salehali22/Flight-Controller/Website/Project_Analysis.md

# Comprehensive Analysis: Custom Flight Controller Development for UAV Applications

## Executive Summary

This is a well-structured, ambitious senior capstone project proposing the complete design and development of a custom flight controller from scratch. The proposal demonstrates strong technical awareness, realistic scope definition, and professional documentation standards. The project balances ambitious technical goals with practical constraints, showing mature engineering judgment.

---

## 1. PROJECT STRUCTURE & OBJECTIVES ANALYSIS

### 1.1 Strengths
- **Clear Objective Hierarchy**: Five specific, measurable objectives that cascade logically from hardware design to flight demonstration
- **Realistic Scope Definition**: Excellent distinction between "hardware-first" focus and "validation-level" firmware development
- **Modular Design Philosophy**: Emphasis on compatibility with existing ecosystems (ArduPilot, iNav, Betaflight) shows pragmatic engineering approach
- **Industry Alignment**: References to EASA/FAA standards demonstrate awareness of real-world requirements

### 1.2 Potential Concerns
- **Scope Creep Risk**: Section 1.4 mentions "cascaded PID control loops, sensor fusion, waypoint navigation" - this may be more extensive than "minimal firmware bring-up" (Section 1.3)
- **Ambiguity in Objective 5**: "Demonstrate stable quadcopter flight" could range from basic hover to full autonomous mission
- **Timeline Alignment**: 9-month timeline (Oct 2025 - June 2026) appears tight for a complete custom design-to-flight cycle

---

## 2. TECHNICAL ARCHITECTURE ANALYSIS

### 2.1 Microcontroller Selection: STM32H743

**Analysis:**
- **Appropriate Choice**: 480 MHz Cortex-M7 with FPU is well-suited for real-time flight control
- **Memory Adequacy**: 1MB RAM + 2MB Flash is sufficient but not generous for complex firmware ecosystems
- **Peripheral Richness**: Extensive peripheral set aligns with modular design goals
- **Cost Consideration**: STM32H743 is premium-priced; may stress budget constraints

**Concerns:**
- Compatibility with open-source firmware (ArduPilot/iNav) requires careful pin mapping - must verify these ecosystems support H7 series
- 480 MHz may be overkill if primarily using existing firmware, but appropriate for custom control loops

### 2.2 Sensor Architecture

#### Primary IMU: InvenSense ICM-42688-P
- **Excellent Choice**: High-performance, modern sensor with 4 kHz gyro rate
- **SPI Interface**: Correct choice for deterministic, low-latency operation
- **Redundancy**: Dual IMU setup (ICM-42688-P + BMI270) is industry best-practice

#### Secondary IMU: Bosch BMI270
- **Solid Choice**: Well-established sensor with good documentation
- **Compatibility**: Different manufacturer reduces common-mode failure risk

#### Barometric Sensor: BMP388
- **Standard Choice**: Widely used in UAV applications
- **Resolution**: ±0.08m is adequate but not exceptional (BMP390 offers better)
- **I²C Interface**: Appropriate for barometric sensing (not time-critical)

#### Missing/Not Explicitly Mentioned:
- **Temperature Sensors**: Critical for IMU calibration - need to verify if included in IMU packages
- **External Magnetometer**: Placement in GPS module is smart (avoids interference)

### 2.3 Power Management System

**Strengths:**
- **Staged Regulation**: Buck converters → LDOs is correct approach for noise isolation
- **Protection Circuitry**: Reverse-polarity and transient suppression mentioned
- **USB-C Integration**: Modern, convenient for development
- **Separation of Concerns**: Power distribution board for motors/servos is excellent design

**Potential Issues:**
- **Current Monitoring**: I²C sensor mentioned but not specified - verify bandwidth for real-time monitoring
- **Efficiency**: Multiple regulation stages may reduce overall efficiency (calculate power budget)
- **Component Count**: More components = higher cost and board complexity

### 2.4 Interface Architecture

#### CAN Bus (FDCAN)
- **Forward-Thinking**: Enables modern distributed UAV architectures
- **Implementation**: Requires proper termination and topology planning
- **Cost Impact**: CAN transceiver adds component cost

#### PWM Outputs (12 channels)
- **Sufficient Capacity**: Covers multirotor (4), individual ESCs (4), servos (4)
- **Timer Resource Allocation**: Must verify STM32H743 has sufficient timer peripherals for 12 independent PWM outputs
- **Voltage Level**: 3.3V logic may require level shifting for 5V ESC compatibility

#### Video Systems
- **Comprehensive Coverage**: Both analog (OSD) and digital (DJI Air Unit) support
- **DJI Integration**: Multiple Air Unit variants supported - excellent for market compatibility
- **Power Requirements**: DJI Air Units need significant power (9V/12V) - verify regulator capacity

---

## 3. PCB DESIGN & LAYOUT ANALYSIS

### 3.1 Six-Layer Stack-Up

**Layer Structure Analysis:**
```
Top Layer: Signal routing (GND reference)
Layer 2: VCC power plane
Layer 3: Solid GND
Layer 4: Segregated power (noisy domains)
Layer 5: Solid GND
Bottom Layer: Signal routing (GND reference)
```

**Strengths:**
- **Proper GND-PWR-GND Sandwich**: Essential for EMI control
- **Dedicated Noisy Power Layer**: Shows understanding of mixed-signal design
- **Signal Layers Adjacent to GND**: Minimizes loop area

**Concerns:**
- **Cost**: 6-layer PCBs are significantly more expensive than 4-layer (may consume 30-40% of PCB budget)
- **Manufacturing Complexity**: Not all cheap PCB fabs can reliably produce 6-layer boards
- **Via Stacks**: Need careful via design to avoid impedance discontinuities

### 3.2 EMC Design Philosophy

**Excellent Approach:**
- **Design-for-Compliance**: Proactive rather than reactive
- **Standards Reference**: IEC 61000 series, CISPR 32, IPC-2221 show proper research
- **Split Ground Avoidance**: Modern best practice (many designs incorrectly split grounds)

**Potential Gaps:**
- **Shielding**: No mention of board-level shielding or enclosure considerations
- **Ferrite Beads**: May be needed on external connectors for common-mode noise
- **Crystal Placement**: HSE oscillator placement relative to sensitive analog circuits

### 3.3 Signal Integrity Considerations

**Not Explicitly Addressed:**
- **Differential Pair Routing**: SPI at 8-10 MHz may need controlled impedance (depends on trace length)
- **Clock Distribution**: HSE oscillator routing and termination
- **Power Plane Decoupling**: Strategy for high-frequency decoupling capacitor placement

---

## 4. FIRMWARE STRATEGY ANALYSIS

### 4.1 Dual-Purpose Approach

**Strengths:**
- Compatibility with ArduPilot/iNav enables rapid validation
- Custom firmware path allows deep learning and experimentation
- Realistic acknowledgment that full firmware development is outside scope

### 4.2 Firmware Scope Clarification

**Inconsistency Identified:**
- Section 1.3: "firmware development is limited to essential board validation"
- Section 1.4: "cascaded PID control loops, sensor fusion, waypoint navigation"
- Section 3.2: "sensor fusion, filtering" and "state estimation, control logic"

**Recommendation**: Clarify whether custom flight control is required or if ArduPilot port is sufficient for validation

### 4.3 Sensor Fusion & State Estimation

**Complexity Assessment:**
- **IMU Fusion**: Basic complementary filter is manageable; full EKF/Madgwick requires significant effort
- **Altitude Fusion**: Combining barometer with IMU accelerometer (Z-axis)
- **GPS Integration**: Position/velocity fusion for autonomous modes

**Time Estimate**: Sensor fusion alone could consume 2-3 months if done from scratch

---

## 5. PROJECT TIMELINE & TASK ALLOCATION

### 5.1 Timeline Analysis (Oct 2025 - June 2026)

**Month-by-Month Breakdown:**
- **Oct 2025**: Planning & Schematic (1 month)
- **Nov 2025**: PCB Layout (1 month) - **AGGRESSIVE**
- **Dec 2025**: Manufacturing (1 month) - Includes fab lead time
- **Dec-Jan 2026**: Hardware bring-up (2 months)
- **Jan-Mar 2026**: Firmware development (3 months)
- **Feb-Apr 2026**: Control algorithms (3 months, overlaps)
- **Apr-May 2026**: Integration & flight testing (2 months)
- **Jun 2026**: Documentation & delivery (1 month)

**Critical Path Risks:**
1. **PCB Layout Duration**: 6-layer board with EMC considerations typically requires 4-6 weeks minimum
2. **Manufacturing Lead Time**: December may have holiday delays (2-4 weeks typical fab time)
3. **Hardware Debugging**: 2 months may be insufficient if major issues found
4. **Flight Testing**: Weather dependencies in Apr-May may cause delays

### 5.2 Task Allocation Analysis

#### Akaki Gvelesiani: Hardware + Low-Level Firmware
**Workload Assessment:**
- **Schematic Design**: 2-3 weeks
- **PCB Layout (6-layer)**: 4-6 weeks (CRITICAL PATH)
- **Low-Level Firmware**: HAL setup, drivers, sensor fusion - **4-6 weeks minimum**
- **Total**: 10-15 weeks of intensive work

**Risk**: Very heavy workload, particularly PCB layout is time-intensive and error-prone

#### Saleh Alhomeidy: Hardware Review + High-Level Firmware
**Workload Assessment:**
- **Hardware Review**: Ongoing support role
- **High-Level Firmware**: Control algorithms, PID tuning - **6-8 weeks**
- **Risk**: Control algorithm tuning is iterative and unpredictable

#### Levani Kazaishvili: Procurement + Mechanical
**Workload Assessment:**
- **Component Sourcing**: Critical early in project (Oct-Nov)
- **Budget Management**: Ongoing
- **Mechanical Integration**: Late-stage focus (Mar-May)

**Note**: This role appears lighter but procurement delays can derail entire timeline

---

## 6. BUDGET ANALYSIS (800 GEL ≈ $280 USD)

### 6.1 Cost Breakdown Estimate

**PCB Manufacturing:**
- 6-layer PCB (50mm x 50mm, ~10 pieces): $150-200
- Assembly (if outsourced): $200-300
- **Total PCB Cost**: Likely $200-300 (if manual assembly)

**Components:**
- STM32H743 (QFP-100): $15-25
- IMU ICM-42688-P: $8-12
- IMU BMI270: $5-8
- BMP388: $3-5
- AT7456E OSD: $5-8
- Power management ICs: $20-30
- Passive components, connectors: $30-50
- **Total Components**: ~$100-150

**Test Platform:**
- 7-inch quadcopter frame: $30-50
- Motors, ESCs (4x): $80-120
- Battery, props: $30-50
- **Total Test Platform**: ~$150-200

**Total Estimate**: $450-650 - **EXCEEDS BUDGET**

### 6.2 Budget Concerns

- **Single PCB Iteration**: No room for respins if issues found
- **Component Costs**: High-end MCU and dual IMUs are expensive
- **Test Platform**: May need to reuse existing equipment or borrow

**Recommendations:**
- Consider 4-layer PCB initially (save ~$100)
- Use lower-cost MCU alternative for validation (STM32F7 series)
- Plan for manual assembly to save costs
- Source components from budget distributors (LCSC, AliExpress)

---

## 7. TECHNICAL RISK ASSESSMENT

### 7.1 High-Risk Areas

#### 7.1.1 PCB First-Pass Success
**Risk Level**: HIGH
**Mitigation**: Extensive design review, simulation before fab
**Impact**: 4-6 week delay + additional cost

#### 7.1.2 Firmware Development Time
**Risk Level**: MEDIUM-HIGH
**Mitigation**: Leverage existing firmware (ArduPilot) rather than custom
**Impact**: May not meet "custom firmware" learning objectives

#### 7.1.3 Component Availability
**Risk Level**: MEDIUM
**Mitigation**: Early procurement, identify alternates
**Impact**: 2-4 week delays possible

#### 7.1.4 EMC/EMI Issues
**Risk Level**: MEDIUM
**Mitigation**: Design-for-compliance approach, but no testing validation
**Impact**: May have interference issues in flight that are difficult to diagnose

### 7.2 Medium-Risk Areas

- **Sensor Calibration**: Time-consuming, requires proper test setup
- **Control Algorithm Tuning**: Iterative process, weather-dependent flight testing
- **Power System Stability**: Under-transient conditions with motor loads

### 7.3 Low-Risk Areas

- **Basic Sensor Communication**: Well-documented interfaces
- **Mechanical Integration**: Standard form factor
- **Documentation**: Writing is less risky than hardware/firmware

---

## 8. STRENGTHS OF THE PROPOSAL

1. **Professional Documentation**: Well-structured, comprehensive, properly referenced
2. **Realistic Limitations**: Honest about constraints (budget, testing, certification)
3. **Standards Awareness**: References to IEC, IPC, EASA/FAA show professional approach
4. **Modular Design**: Enables flexibility and future extensibility
5. **Educational Value**: Covers full engineering workflow from concept to flight
6. **Industry Relevance**: Addresses real need for open, modular flight controllers
7. **Redundancy**: Dual IMU architecture shows safety awareness
8. **EMC Design**: Proper attention to electromagnetic compatibility from start

---

## 9. AREAS FOR IMPROVEMENT / CONCERNS

### 9.1 Technical Concerns

1. **Scope Clarity**: Resolve firmware development scope inconsistency
2. **Budget Realism**: 800 GEL appears insufficient for described scope
3. **Timeline Aggressiveness**: PCB layout and flight testing phases are tight
4. **Missing Specifications**: 
   - Exact form factor dimensions
   - Current ratings for power system
   - Connector specifications (pin counts, types)
   - Operating temperature range
5. **Component Selection Rationale**: Justify STM32H743 vs. lower-cost alternatives

### 9.2 Project Management Concerns

1. **Single PCB Iteration**: No buffer for hardware respins
2. **Weather Dependencies**: Flight testing in Apr-May may face weather delays
3. **Team Workload**: Akaki's role appears overloaded (hardware + significant firmware)
4. **Risk Mitigation**: Limited discussion of backup plans or scope reduction options

### 9.3 Testing Strategy Gaps

1. **Unit Testing**: No mention of individual sensor/interface validation procedures
2. **Integration Testing**: Sequence of integration steps not defined
3. **Failure Modes**: No discussion of how failures will be diagnosed
4. **Test Equipment**: What instrumentation is available/needed?

---

## 10. RECOMMENDATIONS

### 10.1 Immediate Actions

1. **Clarify Firmware Scope**: Define whether ArduPilot port or custom firmware is primary goal
2. **Revise Budget**: Either increase budget or reduce scope (e.g., 4-layer PCB, single IMU)
3. **Expand Timeline Buffer**: Add 2-3 weeks buffer to PCB layout and flight testing phases
4. **Component Procurement**: Immediately verify availability and lead times for critical components

### 10.2 Design Refinements

1. **Form Factor Specification**: Define exact dimensions, mounting hole pattern, connector placement
2. **Power Budget**: Calculate total power consumption and verify regulator capacity
3. **Thermal Analysis**: Consider heat dissipation, especially for power regulators
4. **Alternate Component List**: Prepare backup components for critical parts

### 10.3 Risk Mitigation Strategies

1. **PCB Design Review**: Schedule external review before manufacturing
2. **Prototype Phases**: Consider simplified first revision (fewer features) for validation
3. **Firmware Strategy**: Prioritize ArduPilot compatibility over custom firmware if time constrained
4. **Test Platform**: Secure test platform early to enable parallel work

### 10.4 Documentation Enhancements

1. **Test Procedures**: Define specific test procedures for each subsystem
2. **Design Decisions Log**: Document key design choices and rationale
3. **Risk Register**: Maintain formal risk tracking
4. **Change Management**: Process for handling scope/timeline changes

---

## 11. FEASIBILITY ASSESSMENT

### 11.1 Overall Feasibility: **MEDIUM-HIGH**

**Feasible If:**
- Firmware scope is limited to ArduPilot port + basic validation
- Budget is increased to ~1200-1500 GEL OR scope is reduced
- PCB layout receives adequate time (6 weeks minimum)
- Test platform is available/reused (not purchased)
- Team can dedicate significant weekly hours (15-20 hours/week)

**High-Risk If:**
- Custom firmware development is required
- Single PCB iteration fails
- Component procurement faces delays
- Weather delays flight testing window

### 11.2 Success Criteria Assessment

The proposal defines clear deliverables, but success hinges on:
- **Hardware**: First-pass PCB functionality (HIGH RISK)
- **Firmware**: ArduPilot compatibility OR basic custom control (MEDIUM RISK)
- **Flight**: Stable hover/manual flight (MEDIUM RISK)
- **Timeline**: June 2026 delivery (MEDIUM-HIGH RISK)

---

## 12. COMPETITIVE/INDUSTRY ANALYSIS

### 12.1 Comparison to Existing Solutions

**Commercial Flight Controllers:**
- Pixhawk variants: $100-300, open hardware
- Matek F405/F722: $30-50, popular in DIY community
- DJI N3/A3: $500-1000, proprietary

**Your Design Advantages:**
- Modern MCU (H743 vs. older F4/F7)
- Redundant IMU architecture
- CAN bus support
- DJI Air Unit integration
- Custom learning experience

**Market Position**: Educational/research focus rather than commercial competition

---

## 13. FINAL VERDICT

### 13.1 Technical Merit: **EXCELLENT**
- Sound engineering principles
- Proper standards awareness
- Realistic hardware design
- Good educational value

### 13.2 Project Execution Risk: **MEDIUM-HIGH**
- Timeline is aggressive
- Budget may be insufficient
- Single PCB iteration risky
- Workload distribution concerns

### 13.3 Recommendation: **PROCEED WITH MODIFICATIONS**

**Critical Success Factors:**
1. Clarify and reduce firmware scope to validation-only
2. Increase budget OR reduce hardware complexity
3. Add timeline buffers (especially PCB layout phase)
4. Secure test platform early
5. Prepare for single PCB iteration (extensive design review)

**Modified Timeline Suggestion:**
- Consider extending to 10-11 months OR
- Reduce scope to 4-layer PCB + single IMU for first revision

---

## 14. KEY QUESTIONS FOR CLARIFICATION

1. **Firmware**: Is ArduPilot/iNav port sufficient, or is custom flight control required?
2. **Budget**: Can budget be increased, or should hardware be simplified?
3. **PCB Iterations**: Is there budget/time for a second PCB revision if needed?
4. **Test Platform**: Is 7-inch quadcopter available, or must it be purchased?
5. **Firmware Tools**: What development tools are available (IDEs, debuggers, simulators)?
6. **Component Availability**: Have critical components been verified for availability?
7. **Assembly**: Will PCB be manually assembled or outsourced?
8. **Timeline Flexibility**: Can deadline be extended if needed?

---

## CONCLUSION

This is a well-conceived, technically sound proposal that demonstrates strong engineering fundamentals and professional documentation. The primary risks are **execution-related** (timeline, budget, scope) rather than **technical feasibility**. With appropriate scope adjustments and risk mitigation, this project is highly achievable and will provide excellent educational value.

The proposal would benefit from clearer firmware scope definition, more realistic budget planning, and explicit risk mitigation strategies. However, the technical approach is sound, and the modular, standards-aware design philosophy is appropriate for an academic project with potential for future extension.

**Overall Grade for Proposal: A- (Excellent with minor improvements needed)**

---

*Analysis Date: Based on Project Proposal dated Tbilisi, Georgia*
*Analyzer: Comprehensive Technical Review*
*Project Timeline: October 2025 - June 2026*
