salehali22/Flight-Controller/Hardware/1.png

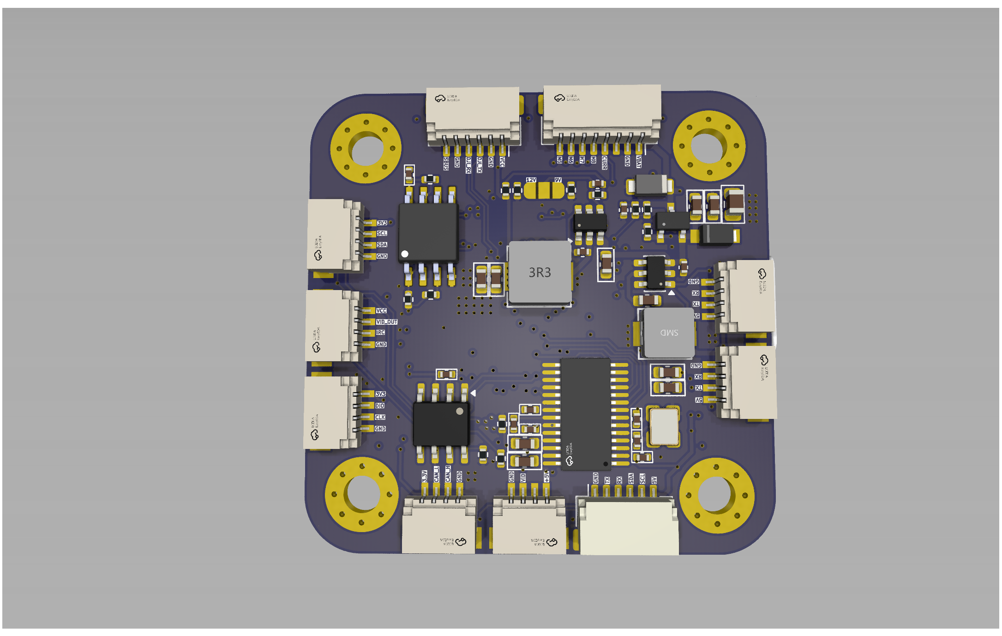
Hardware/1.png
