salehali22/Flight-Controller/Hardware/2.png

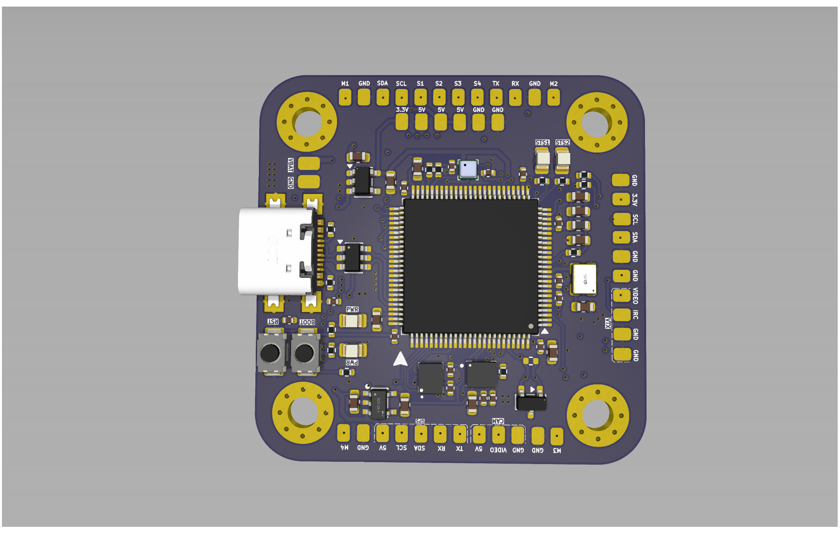
Hardware/2.png
