salehali22/Flight-Controller/Hardware/Flight Controller3.png

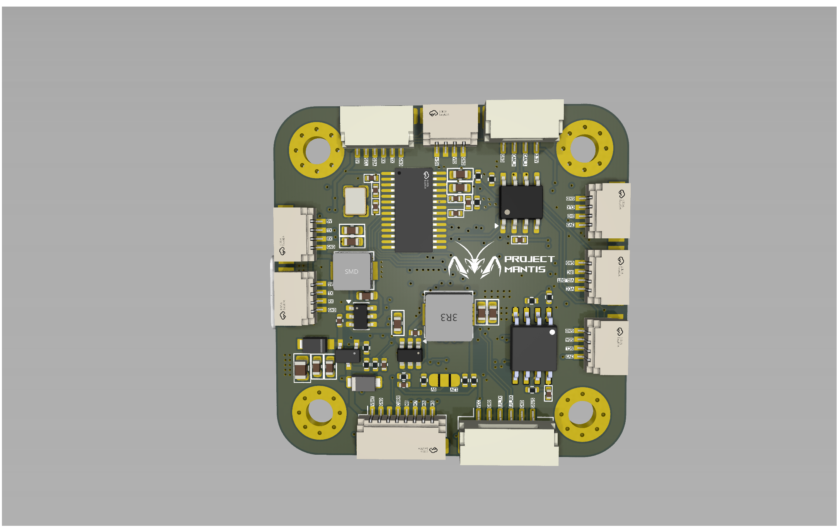
Hardware/Flight Controller3.png
