salehali22/Flight-Controller/Hardware/Flight Controller4.png

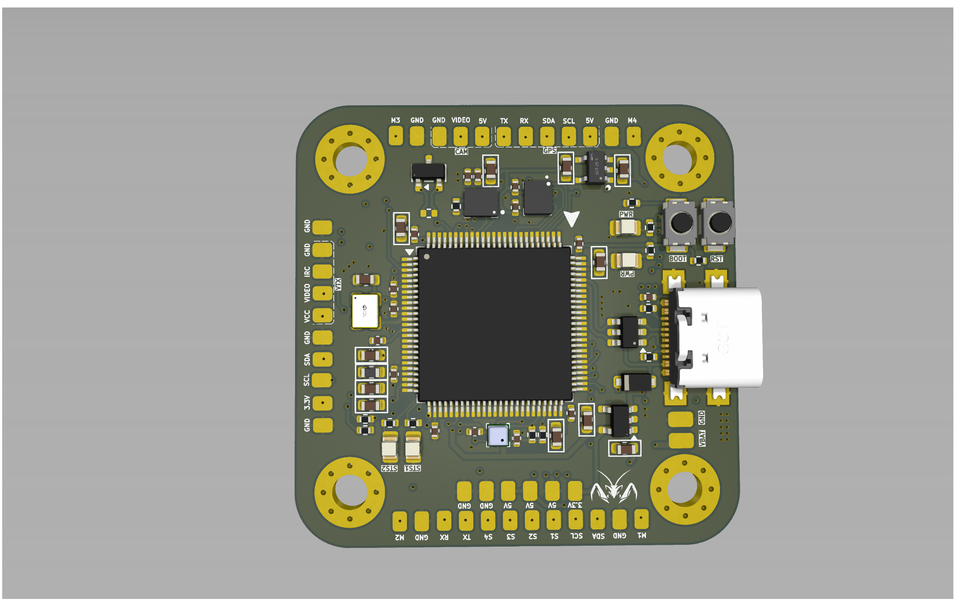
Hardware/Flight Controller4.png
