salehali22/Flight-Controller/Hardware/Flight Controller 1.png

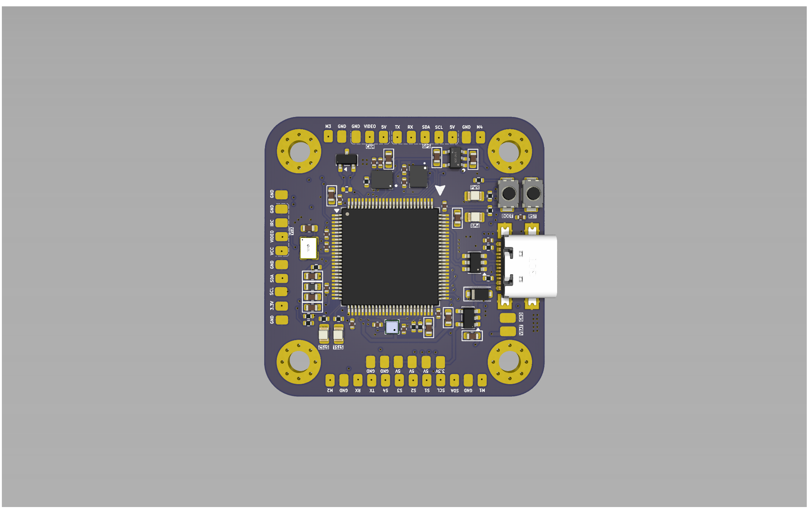
Hardware/Flight Controller 1.png
