salehali22/Flight-Controller/Hardware/Flight Controller 2.png

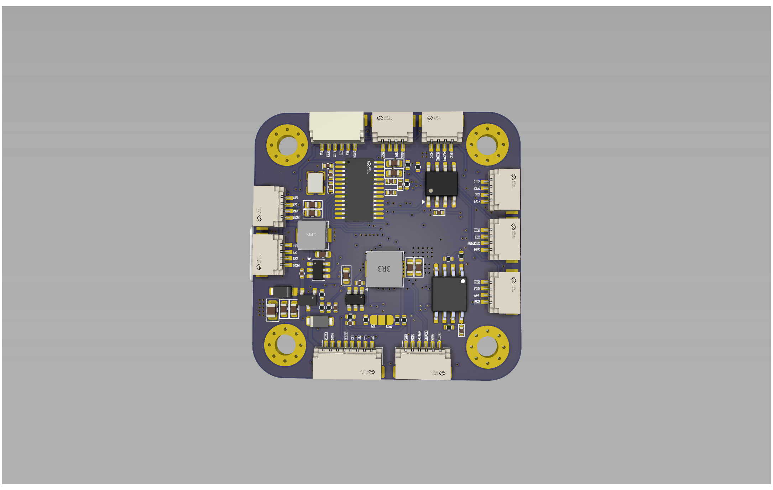
Hardware/Flight Controller 2.png
