salehali22/Flight-Controller/recordings/imu_chart_2025-11-14_03-24-00.png

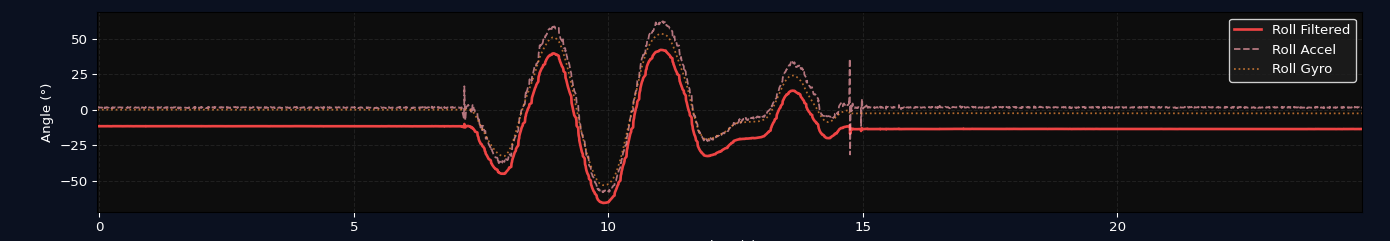
recordings/imu_chart_2025-11-14_03-24-00.png
