salehali22/Flight-Controller/Hardware/3D models/SM06B-GHS-TB.step

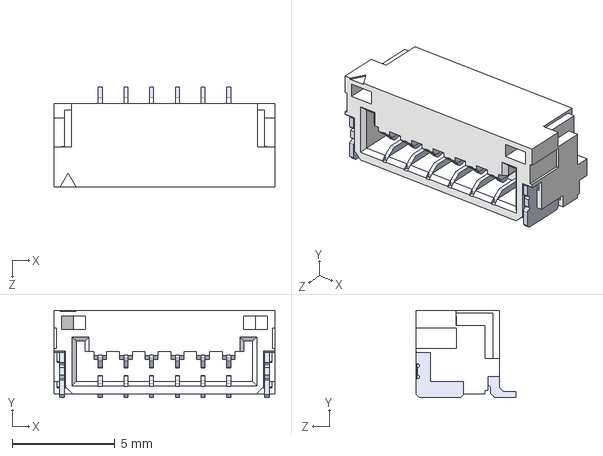
[picture p13: CAD file, 2026-02-09]
Hardware/3D models/SM06B-GHS-TB.step
10.8 x 4.25 x 4.85 mm
SMxB-GHS-TB_06
pin x 6
