salehali22/Flight-Controller/Test_Board/3D models/BMI270.step

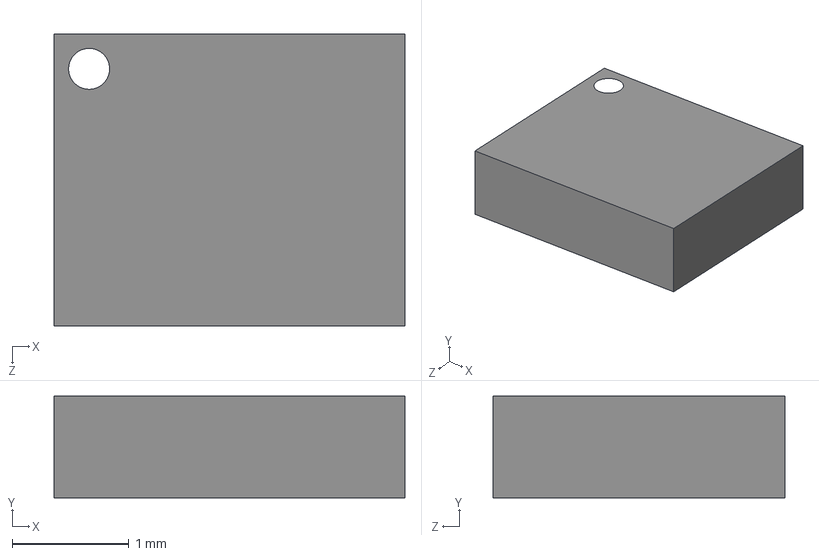
[picture p14: CAD file, 2025-11-20]
Test_Board/3D models/BMI270.step
3.00 x 0.87 x 2.50 mm
