salehali22/Flight-Controller/Hardware/3D models/(zener)SOD-123FL_L2.8-W1.8-LS3.7-RD-1.step

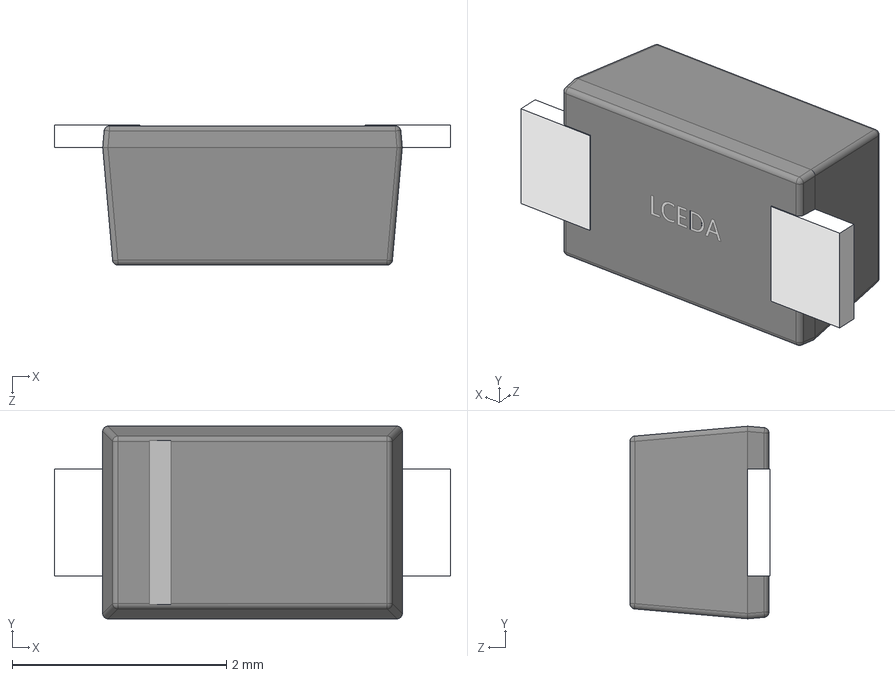
[picture p15: CAD file, 2026-02-07]
Hardware/3D models/(zener)SOD-123FL_L2.8-W1.8-LS3.7-RD-1.step
3.70 x 1.80 x 1.31 mm
