salehali22/Flight-Controller/Test_Board/3D models/SW-SMD_SSSS810701.step

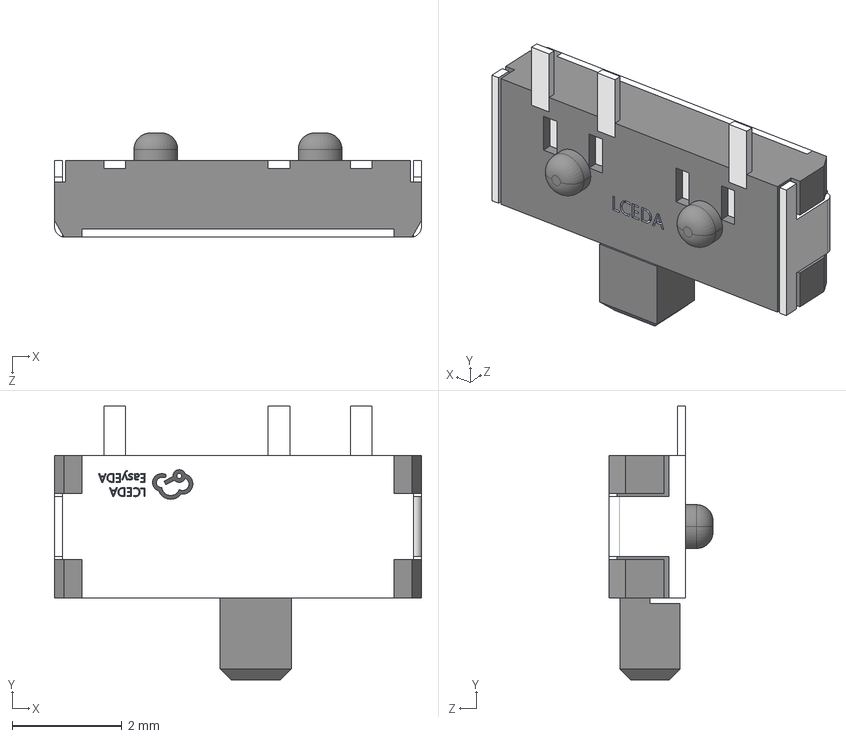
[picture p16: CAD file, 2025-11-14]
Test_Board/3D models/SW-SMD_SSSS810701.step
6.70 x 5.00 x 1.90 mm
