salehali22/Flight-Controller/Hardware/3D models/(HSE)OSC-SMD_4P-L3.2-W2.5-CJ13-320001210A20.step

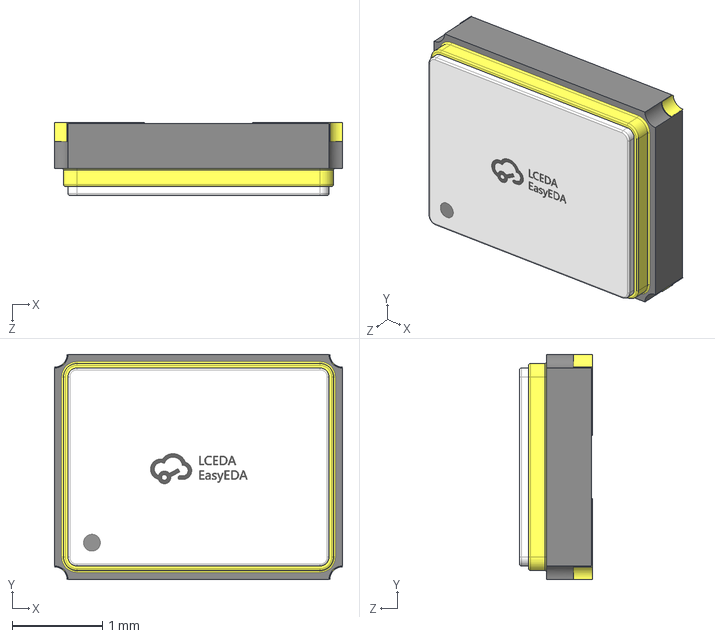
[picture p17: CAD file, 2025-12-16]
Hardware/3D models/(HSE)OSC-SMD_4P-L3.2-W2.5-CJ13-320001210A20.step
3.20 x 2.50 x 0.811 mm
