salehali22/Flight-Controller/Test_Board/3D models/QMC5883P.step

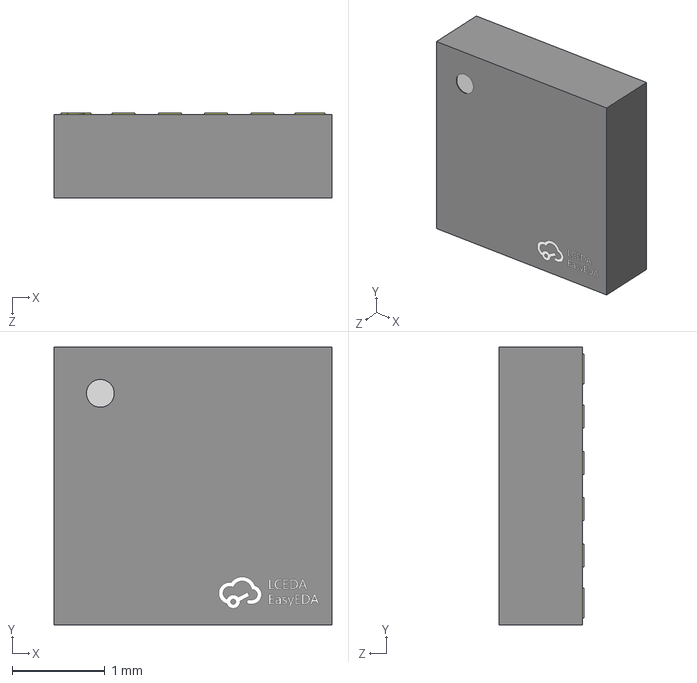
[picture p18: CAD file, 2025-11-14]
Test_Board/3D models/QMC5883P.step
3.00 x 3.00 x 0.921 mm
