salehali22/Flight-Controller/Hardware/3D models/mag.step

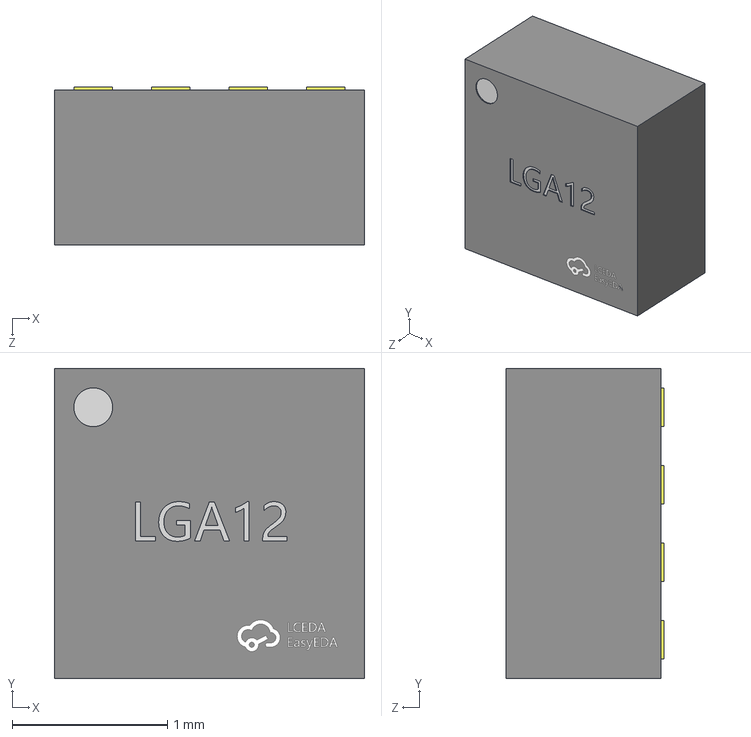
[picture p19: CAD file, 2025-12-01]
Hardware/3D models/mag.step
2.00 x 2.00 x 1.02 mm
