salehali22/Flight-Controller/Test_Board/3D models/W25Q128JVSIQ.step

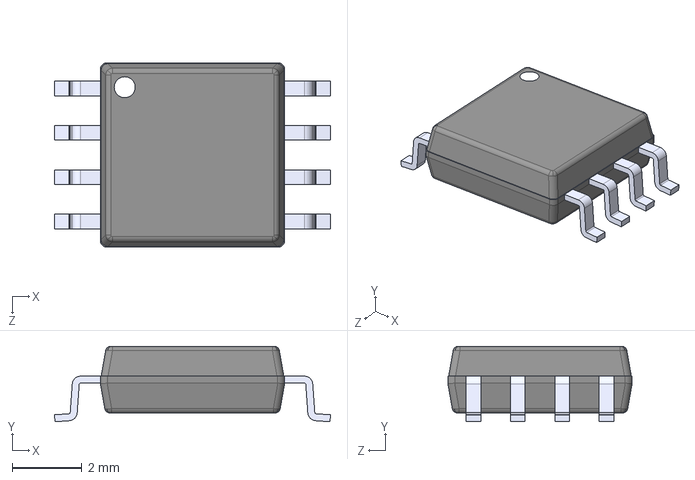
[picture p20: CAD file, 2025-11-14]
Test_Board/3D models/W25Q128JVSIQ.step
7.90 x 2.16 x 5.28 mm
