salehali22/Flight-Controller/Hardware/3D models/AP7343 .step

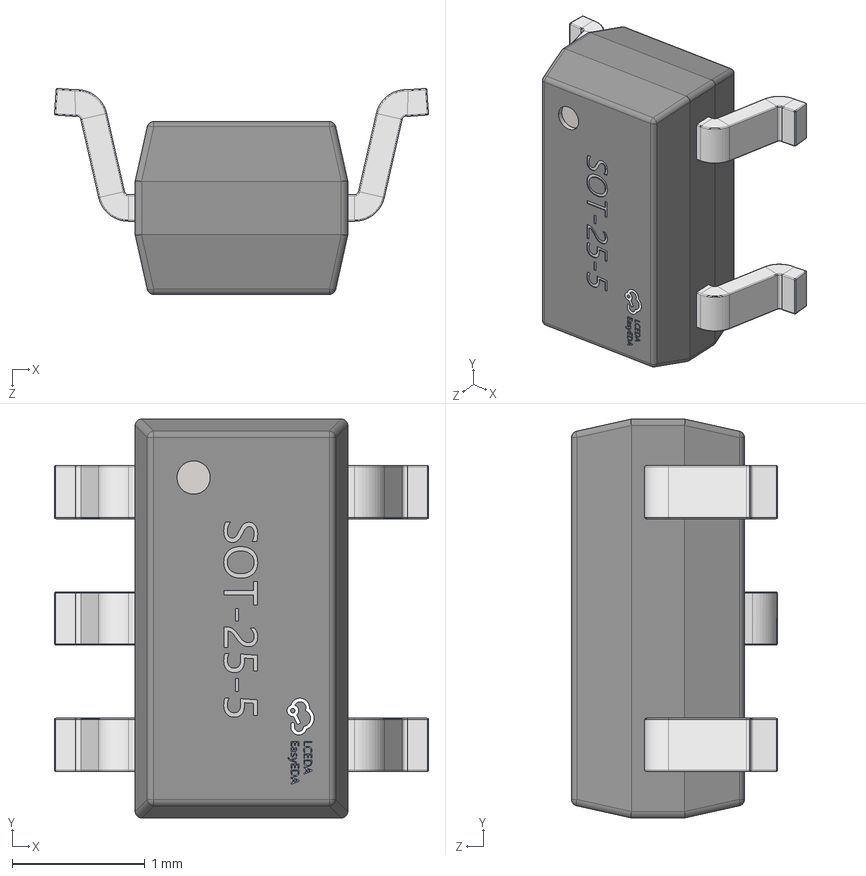
[picture p21: CAD file, 2025-12-01]
Hardware/3D models/AP7343 .step
2.81 x 3.00 x 1.55 mm
