salehali22/Flight-Controller/Test_Board/3D models/ICM-42688-P.step

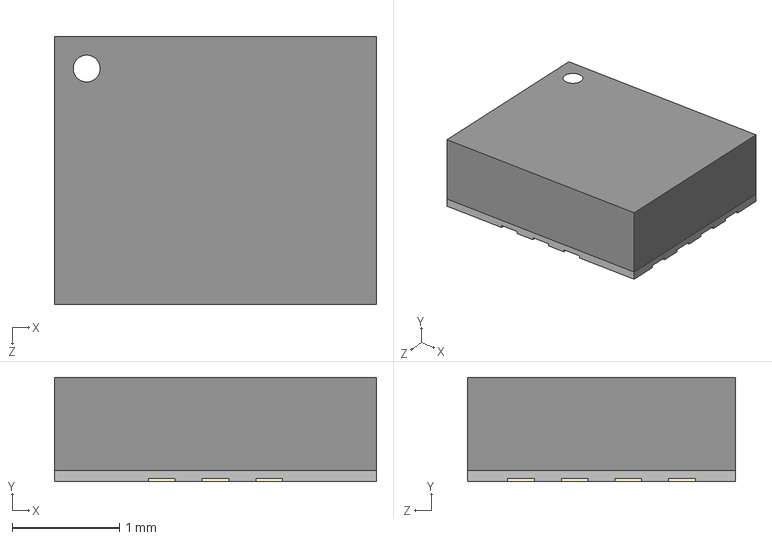
[picture p22: CAD file, 2025-11-13]
Test_Board/3D models/ICM-42688-P.step
3.00 x 0.97 x 2.50 mm
