salehali22/Flight-Controller/Hardware/3D models/AP2112K-3.3TRG1.step

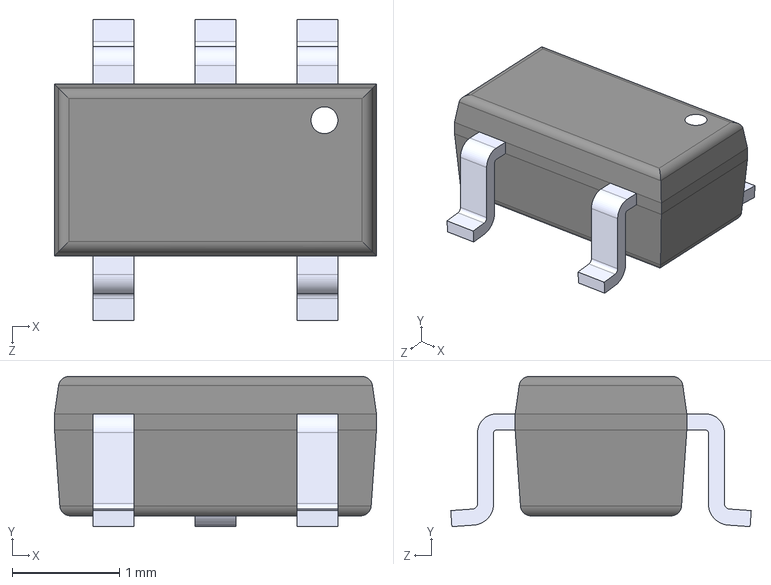
[picture p23: CAD file, 2025-11-29]
Hardware/3D models/AP2112K-3.3TRG1.step
3.00 x 1.40 x 2.80 mm
