salehali22/Flight-Controller/Test_Board/3D models/BMP388.step

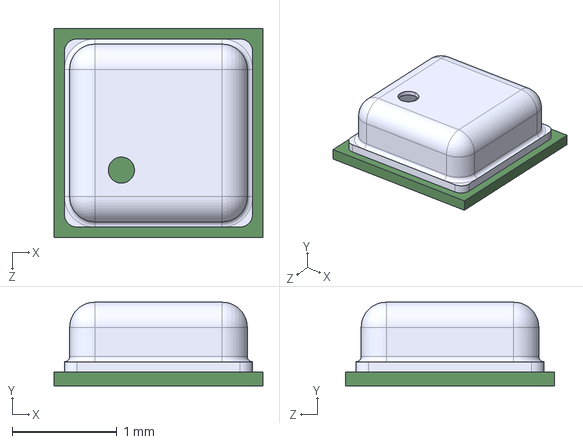
[picture p24: CAD file, 2025-11-13]
Test_Board/3D models/BMP388.step
2.00 x 0.8 x 2.00 mm
