salehali22/Flight-Controller/Hardware/3D models/8pconn.step

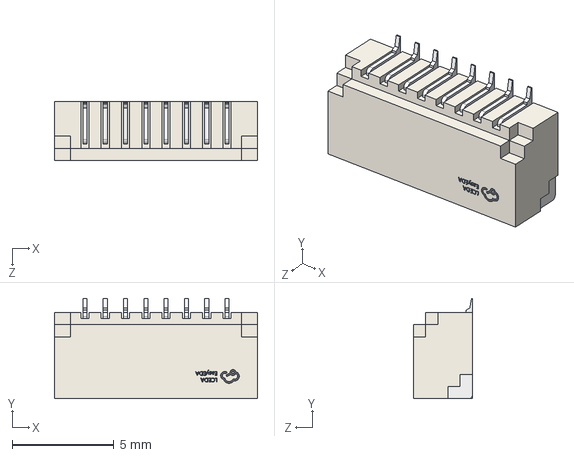
[picture p25: CAD file, 2025-11-25]
Hardware/3D models/8pconn.step
10.0 x 4.95 x 2.91 mm
