salehali22/Flight-Controller/Test_Board/3D models/AT7456E.step

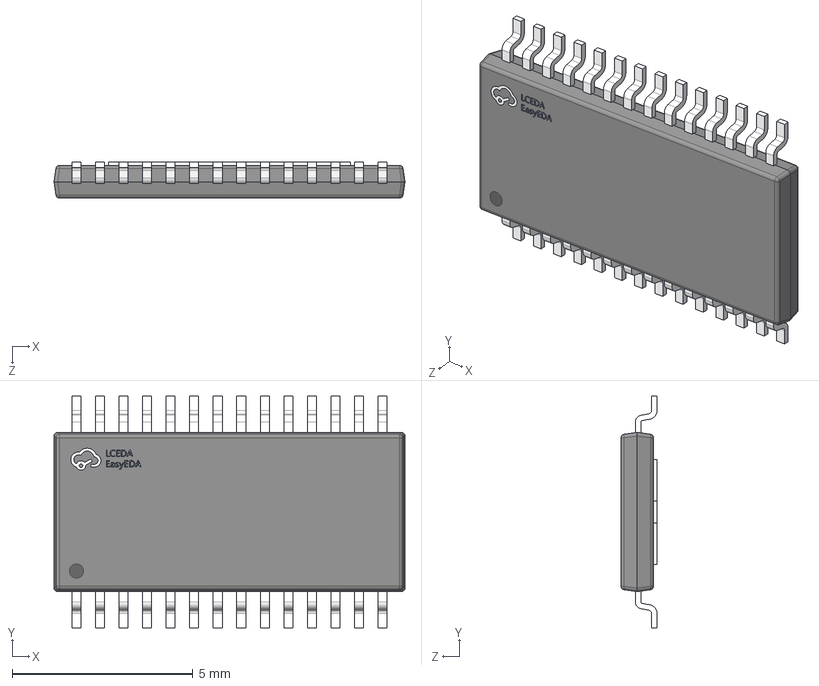
[picture p26: CAD file, 2025-11-13]
Test_Board/3D models/AT7456E.step
9.70 x 6.40 x 1.00 mm
