salehali22/Flight-Controller/Hardware/3D models/4pconnector1mm.step

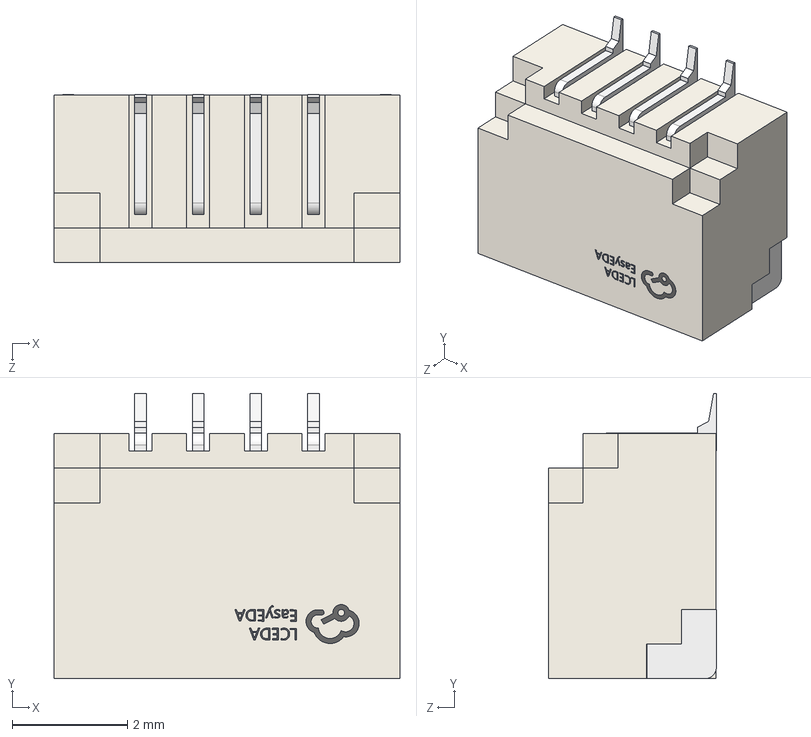
[picture p27: CAD file, 2025-11-25]
Hardware/3D models/4pconnector1mm.step
6.00 x 4.95 x 2.91 mm
