salehali22/Flight-Controller/Test_Board/3D models/USB4110GFA.step

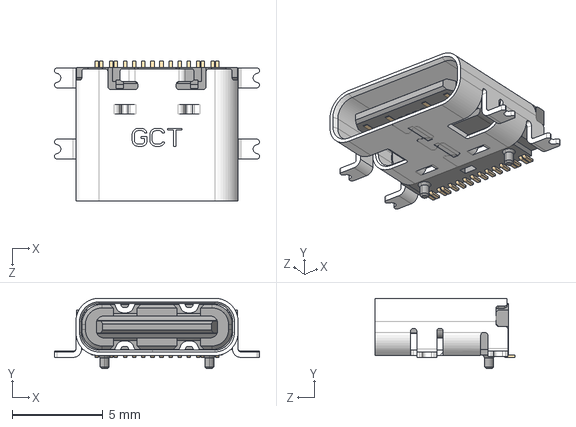
[picture p28: CAD file, 2025-11-13]
Test_Board/3D models/USB4110GFA.step
11.3 x 3.89 x 7.70 mm
