salehali22/Flight-Controller/Hardware/3D models/6pconn.step

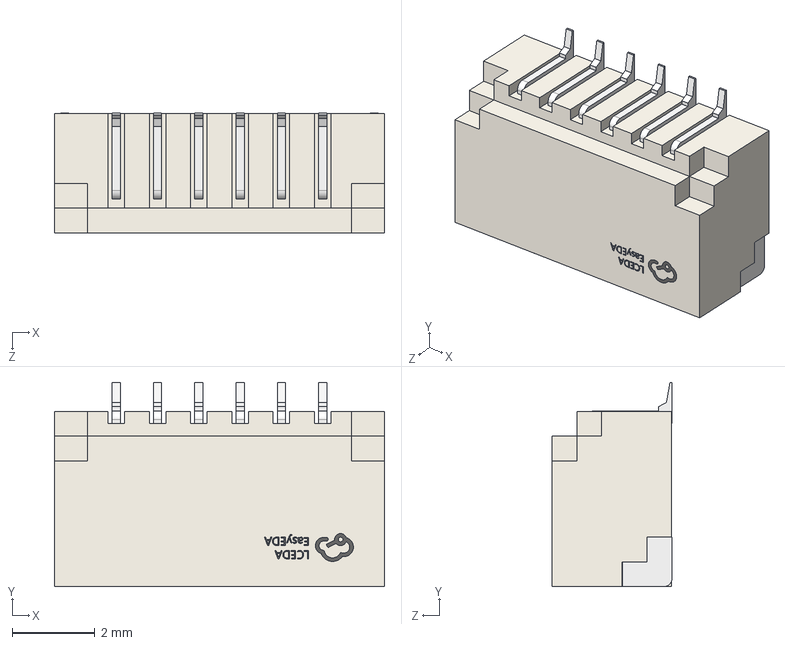
[picture p29: CAD file, 2025-11-25]
Hardware/3D models/6pconn.step
8.00 x 4.95 x 2.91 mm
