salehali22/Flight-Controller/Test_Board/3D models/STM32F722RET6.step

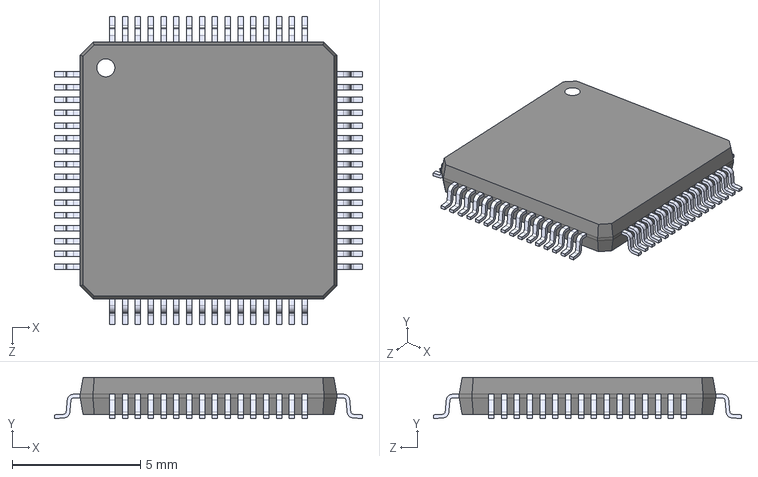
[picture p30: CAD file, 2025-11-13]
Test_Board/3D models/STM32F722RET6.step
12.0 x 1.60 x 12.0 mm
