salehali22/Flight-Controller/Hardware/3D models/IND-SMD_L4.2-W4.4-H2.0.step

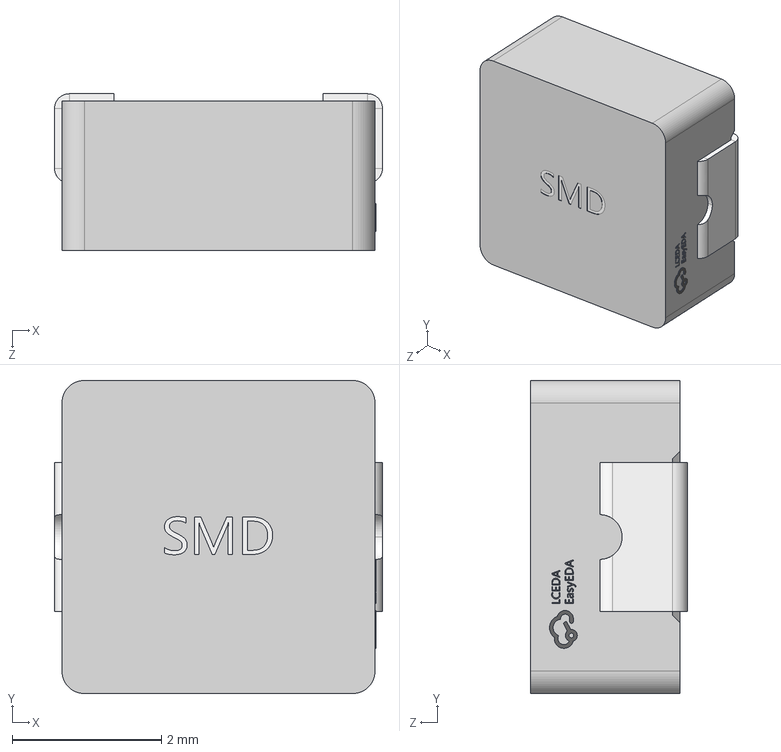
[picture p31: CAD file, 2025-11-23]
Hardware/3D models/IND-SMD_L4.2-W4.4-H2.0.step
4.40 x 4.20 x 2.10 mm
