salehali22/Flight-Controller/Hardware/3D models/AO3407A.step

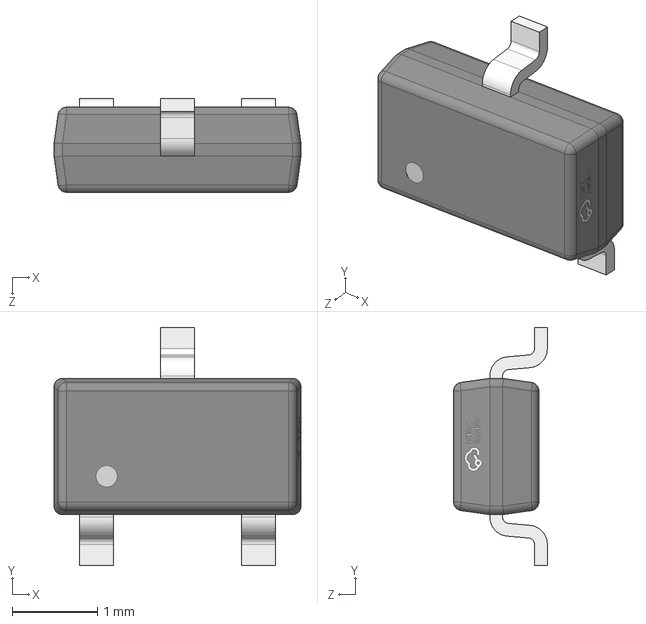
[picture p32: CAD file, 2025-11-23]
Hardware/3D models/AO3407A.step
2.90 x 2.80 x 1.10 mm
