salehali22/Flight-Controller/Hardware/3D models/IND-SMD_L5.4-W5.2-H3.0.step

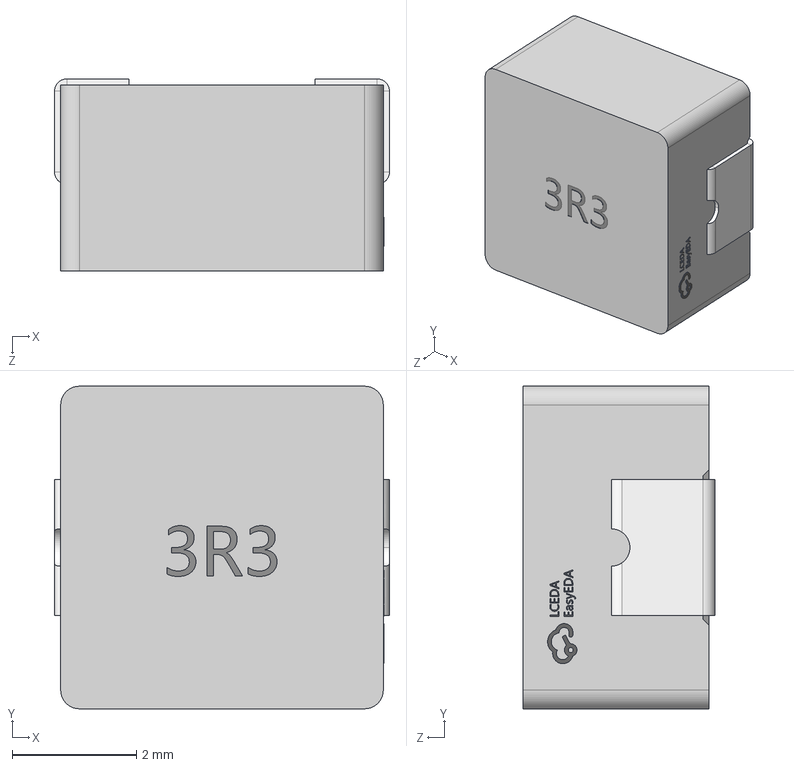
[picture p33: CAD file, 2025-11-23]
Hardware/3D models/IND-SMD_L5.4-W5.2-H3.0.step
5.40 x 5.20 x 3.10 mm
