salehali22/Flight-Controller/Hardware/3D models/R2512_L6.3-W3.2-H0.6.step

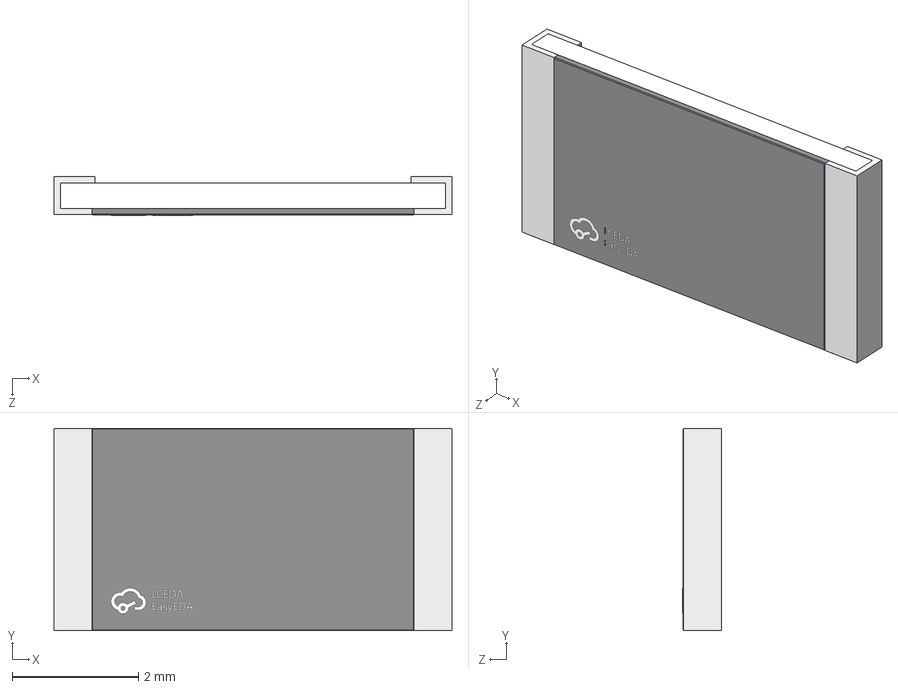
[picture p34: CAD file, 2025-11-23]
Hardware/3D models/R2512_L6.3-W3.2-H0.6.step
6.30 x 3.20 x 0.611 mm
