salehali22/Flight-Controller/recordings/drift_test_2025-11-14_01-17/drift_test_2025-11-14_01-17.csv

# IMU Data Export
# Exported: 2025-11-14 01:17:02
# Blocks: 1
# Range: markers
# Block 7: Mode=FILTERED Rate=100 Samples=29999 Duration=300.01s
# MODE=FILTERED
# RATE=100
# ALPHA=0.98
# DURATION=300
block_id | timestamp_s | datetime | roll | pitch | yaw | gx | gy | gz | ax | ay | az | roll_raw | pitch_raw | yaw_raw
7 | 0.000000 | 2025-11-14 01:09:52.246 | -0.089000 | 0.618000 | -0.001000
7 | 0.010000 | 2025-11-14 01:09:52.256 | -0.094000 | 0.616000 | -0.001000
7 | 0.020000 | 2025-11-14 01:09:52.266 | -0.090000 | 0.615000 | -0.000000
7 | 0.030000 | 2025-11-14 01:09:52.276 | -0.088000 | 0.608000 | -0.001000
7 | 0.040000 | 2025-11-14 01:09:52.286 | -0.081000 | 0.612000 | -0.001000
7 | 0.050000 | 2025-11-14 01:09:52.296 | -0.088000 | 0.615000 | -0.001000
7 | 0.060000 | 2025-11-14 01:09:52.306 | -0.087000 | 0.607000 | 0.000000
7 | 0.070000 | 2025-11-14 01:09:52.316 | -0.086000 | 0.612000 | -0.001000
7 | 0.080000 | 2025-11-14 01:09:52.326 | -0.097000 | 0.621000 | -0.001000
7 | 0.090000 | 2025-11-14 01:09:52.336 | -0.089000 | 0.610000 | -0.002000
7 | 0.100000 | 2025-11-14 01:09:52.346 | -0.084000 | 0.615000 | -0.003000
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
