salehali22/Flight-Controller/recordings/drift_test_2025-11-14_01-25/drift_test_2025-11-14_01-25.csv

# IMU Data Export
# Exported: 2025-11-14 01:25:01
# Blocks: 1
# Range: markers
# Block 12: Mode=FILTERED Rate=100 Samples=29999 Duration=300.04s
# MODE=FILTERED
# RATE=100
# ALPHA=0.95
# DURATION=300
block_id | timestamp_s | datetime | roll | pitch | yaw | gx | gy | gz | ax | ay | az | roll_raw | pitch_raw | yaw_raw
12 | 0.000000 | 2025-11-14 01:19:35.700 | 0.017000 | 0.559000 | -0.001000
12 | 0.010000 | 2025-11-14 01:19:35.710 | 0.012000 | 0.519000 | -0.001000
12 | 0.020000 | 2025-11-14 01:19:35.720 | 0.022000 | 0.533000 | -0.001000
12 | 0.030000 | 2025-11-14 01:19:35.730 | 0.052000 | 0.529000 | -0.001000
12 | 0.040000 | 2025-11-14 01:19:35.740 | 0.027000 | 0.525000 | 0.001000
12 | 0.050000 | 2025-11-14 01:19:35.750 | 0.009000 | 0.536000 | -0.001000
12 | 0.060000 | 2025-11-14 01:19:35.760 | 0.017000 | 0.525000 | -0.000000
12 | 0.070000 | 2025-11-14 01:19:35.770 | 0.038000 | 0.534000 | 0.000000
12 | 0.080000 | 2025-11-14 01:19:35.780 | 0.031000 | 0.545000 | -0.002000
12 | 0.090000 | 2025-11-14 01:19:35.790 | 0.030000 | 0.524000 | -0.000000
12 | 0.100000 | 2025-11-14 01:19:35.800 | 0.021000 | 0.518000 | -0.000000
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
