salehali22/Flight-Controller/recordings/drift_test_2025-11-14_01-27/drift_test_2025-11-14_01-27.csv

# IMU Data Export
# Exported: 2025-11-14 01:27:50
# Blocks: 1
# Range: markers
# Block 13: Mode=FILTERED Rate=100 Samples=339 Duration=3.39s
# MODE=FILTERED
# RATE=100
# ALPHA=0.95
# DURATION=300
block_id | timestamp_s | datetime | roll | pitch | yaw | gx | gy | gz | ax | ay | az | roll_raw | pitch_raw | yaw_raw
13 | 0.000000 | 2025-11-14 01:27:47.419 | 0.028000 | 0.613000 | 0.000000
13 | 0.010000 | 2025-11-14 01:27:47.429 | 0.023000 | 0.620000 | 0.001000
13 | 0.020000 | 2025-11-14 01:27:47.439 | 0.030000 | 0.639000 | 0.001000
13 | 0.030000 | 2025-11-14 01:27:47.449 | 0.025000 | 0.603000 | 0.001000
13 | 0.040000 | 2025-11-14 01:27:47.459 | 0.008000 | 0.611000 | -0.001000
13 | 0.050000 | 2025-11-14 01:27:47.469 | 0.015000 | 0.656000 | -0.000000
13 | 0.060000 | 2025-11-14 01:27:47.479 | 0.022000 | 0.619000 | 0.000000
13 | 0.070000 | 2025-11-14 01:27:47.489 | 0.036000 | 0.630000 | 0.002000
13 | 0.080000 | 2025-11-14 01:27:47.499 | 0.017000 | 0.615000 | 0.002000
13 | 0.090000 | 2025-11-14 01:27:47.509 | 0.011000 | 0.615000 | 0.002000
13 | 0.100000 | 2025-11-14 01:27:47.519 | 0.026000 | 0.624000 | -0.000000
13 | 0.110000 | 2025-11-14 01:27:47.529 | 0.024000 | 0.625000 | 0.000000
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
