salehali22/Flight-Controller/recordings/drift_test_2025-11-14_03-00/drift_test_2025-11-14_03-00.csv

# IMU Data Export
# Exported: 2025-11-14 03:00:15
# Blocks: 1
# Range: markers
# Block 0: Mode=BOTH Rate=100 Samples=77 Duration=0.77s
# MODE=BOTH
# RATE=100
# ALPHA=0.98
block_id | timestamp_s | datetime | roll | pitch | yaw | gx | gy | gz | ax | ay | az | roll_raw | pitch_raw | yaw_raw | roll_gyro_raw | pitch_gyro_raw | yaw_gyro_raw
0 | 0.000000 | 2025-11-14 03:00:15.151 | -0.036000 | 0.150000 | -0.002000 | -0.020000 | 0.097000 | -0.155000 | -0.043000 | 0.021000 | 0.882000 | 1.362310 | 2.790332 |  | 0.000000 | 0.000000 | 0.000000
0 | 0.010000 | 2025-11-14 03:00:15.161 | -0.033000 | 0.151000 | -0.003000 | -0.142000 | 0.013000 | -0.116000 | -0.043000 | 0.024000 | 0.881000 | 1.558598 | 2.793250 |  | -0.001420 | 0.000130 | -0.001160
0 | 0.020000 | 2025-11-14 03:00:15.171 | -0.033000 | 0.154000 | -0.003000 | 0.072000 | 0.135000 | 0.013000 | -0.045000 | 0.024000 | 0.878000 | 1.563730 | 2.932911 |  | -0.000700 | 0.001480 | -0.001030
0 | 0.030000 | 2025-11-14 03:00:15.181 | -0.030000 | 0.157000 | -0.003000 | -0.027000 | 0.143000 | -0.078000 | -0.046000 | 0.027000 | 0.883000 | 1.749050 | 2.980745 |  | -0.000970 | 0.002910 | -0.001810
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
