salehali22/Flight-Controller/recordings/drift_test_2025-11-14_03-19/drift_test_2025-11-14_03-19.csv

# IMU Data Export
# Exported: 2025-11-14 03:19:24
# Blocks: 1
# Range: markers
# Block 2: Mode=FILTERED Rate=100 Samples=29999 Duration=300.00s
# MODE=FILTERED
# RATE=100
# ALPHA=0.98
# DURATION=300
block_id | timestamp_s | datetime | roll | pitch | yaw | gx | gy | gz | ax | ay | az | roll_raw | pitch_raw | yaw_raw | roll_gyro_raw | pitch_gyro_raw | yaw_gyro_raw
2 | 0.000000 | 2025-11-14 03:08:09.763 | -0.176000 | 0.326000 | -0.001000 |  |  |  |  |  |  |  |  |  | 0.000000 | 0.000000 | 0.000000
2 | 0.010000 | 2025-11-14 03:08:09.773 | -0.175000 | 0.331000 | -0.000000 |  |  |  |  |  |  |  |  |  | 0.000000 | 0.000000 | 0.000000
2 | 0.020000 | 2025-11-14 03:08:09.783 | -0.176000 | 0.323000 | -0.001000 |  |  |  |  |  |  |  |  |  | 0.000000 | 0.000000 | 0.000000
2 | 0.030000 | 2025-11-14 03:08:09.793 | -0.176000 | 0.328000 | -0.001000 |  |  |  |  |  |  |  |  |  | 0.000000 | 0.000000 | 0.000000
2 | 0.040000 | 2025-11-14 03:08:09.803 | -0.170000 | 0.330000 | -0.002000 |  |  |  |  |  |  |  |  |  | 0.000000 | 0.000000 | 0.000000
2 | 0.050000 | 2025-11-14 03:08:09.813 | -0.168000 | 0.314000 | -0.001000 |  |  |  |  |  |  |  |  |  | 0.000000 | 0.000000 | 0.000000
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
