salehali22/Flight-Controller/recordings/static test.csv

# IMU Timed Run Data Export
# Start Time: 2025-11-15 15:52:04
# Samples: 6063
# Duration: 66.67 s
#
# Configuration:
# Calibration Samples: 1000
# Alpha Factor: 0.9500
# Sample Rate (Set): 100 Hz
# Sample Rate (Measured): 90.94 Hz
#
# Statistics:
# Roll: Min= -0.321° Max= 0.252° Mean= -0.018° StdDev= 0.073° RMS= 0.075° Drift= -0.021°/min
# Pitch: Min= -0.285° Max= 0.334° Mean= 0.017° StdDev= 0.085° RMS= 0.086° Drift= -0.031°/min
# Yaw: Min= -0.157° Max= -0.023° Mean= -0.101° StdDev= 0.032° RMS= 0.106° Drift= -0.041°/min
#
Time_Relative_s | Roll_deg | Pitch_deg | Yaw_deg
0.000000 | 0.108000 | -0.037000 | -0.113000
0.009660 | 0.126000 | -0.088000 | -0.114000
0.019835 | 0.121000 | -0.189000 | -0.118000
0.040004 | 0.145000 | -0.160000 | -0.120000
0.043531 | 0.074000 | -0.028000 | -0.123000
0.059693 | 0.090000 | 0.025000 | -0.126000
0.061569 | 0.113000 | -0.019000 | -0.127000
0.069936 | 0.126000 | 0.030000 | -0.130000
0.079673 | 0.164000 | 0.032000 | -0.131000
0.088875 | 0.189000 | 0.036000 | -0.132000
0.098912 | 0.129000 | 0.101000 | -0.134000
0.118081 | 0.117000 | -0.005000 | -0.134000
0.120137 | 0.150000 | -0.009000 | -0.136000
0.138444 | 0.125000 | -0.002000 | -0.136000
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
