salehali22/Flight-Controller/Hardware/Flight Controller.kicad_pcb

## KiCad design Hardware/Flight Controller.kicad_pcb (2026-02-22)

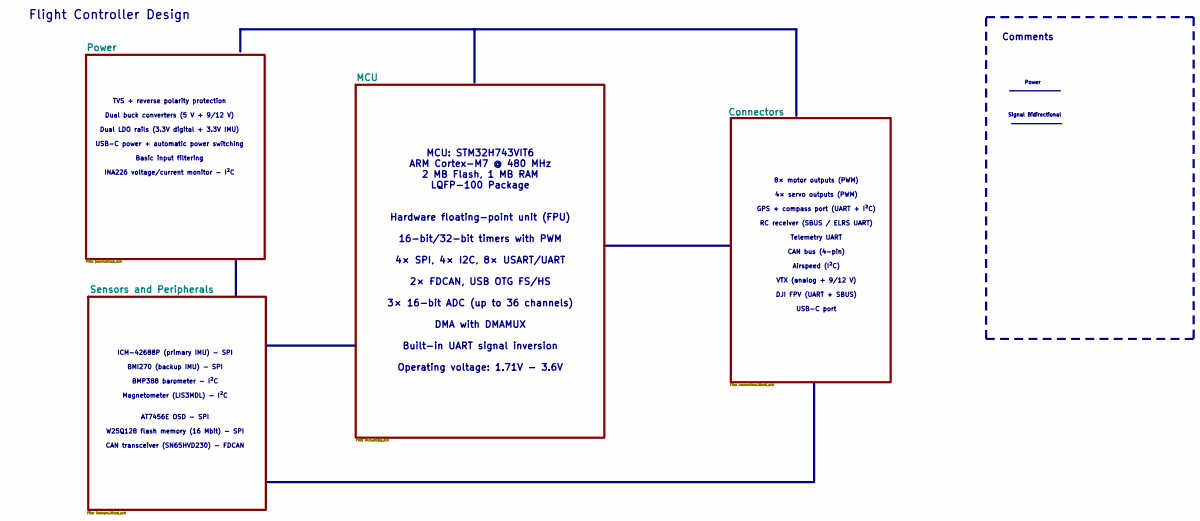
[picture p35: schematic Flight Controller.kicad_sch]

Notes on the sheet:
Flight Controller Design
ICM-42688P (primary IMU) - SPI BMI270 (backup IMU) - SPI BMP388 barometer - I²C Magnetometer (LIS3MDL) - I²C AT7456E OSD - SPI W25Q128 flash memory (16 Mbit) - SPI CAN transceiver (SN65HVD230) - FDCAN
Signal Bidirectional
8× motor outputs (PWM) 4× servo outputs (PWM) GPS + compass port (UART + I²C) RC receiver (SBUS / ELRS UART) Telemetry UART CAN bus (4-pin) Airspeed (I²C) VTX (analog + 9/12 V) DJI FPV (UART + SBUS) USB-C port
Comments
TVS + reverse polarity protection Dual buck converters (5 V + 9/12 V) Dual LDO rails (3.3V digital + 3.3V IMU) USB-C power + automatic power switching Basic input filtering INA226 voltage/current monitor - I²C
MCU: STM32H743VIT6 ARM Cortex-M7 @ 480 MHz 2 MB Flash, 1 MB RAM LQFP-100 Package Hardware floating-point unit (FPU) 16-bit/32-bit timers with PWM 4× SPI, 4× I2C, 8× USART/UART 2× FDCAN, USB OTG FS/HS 3× 16-bit ADC (up to 36 channels) DMA with DMAMUX Built-in UART signal inversion Operating voltage: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
Power

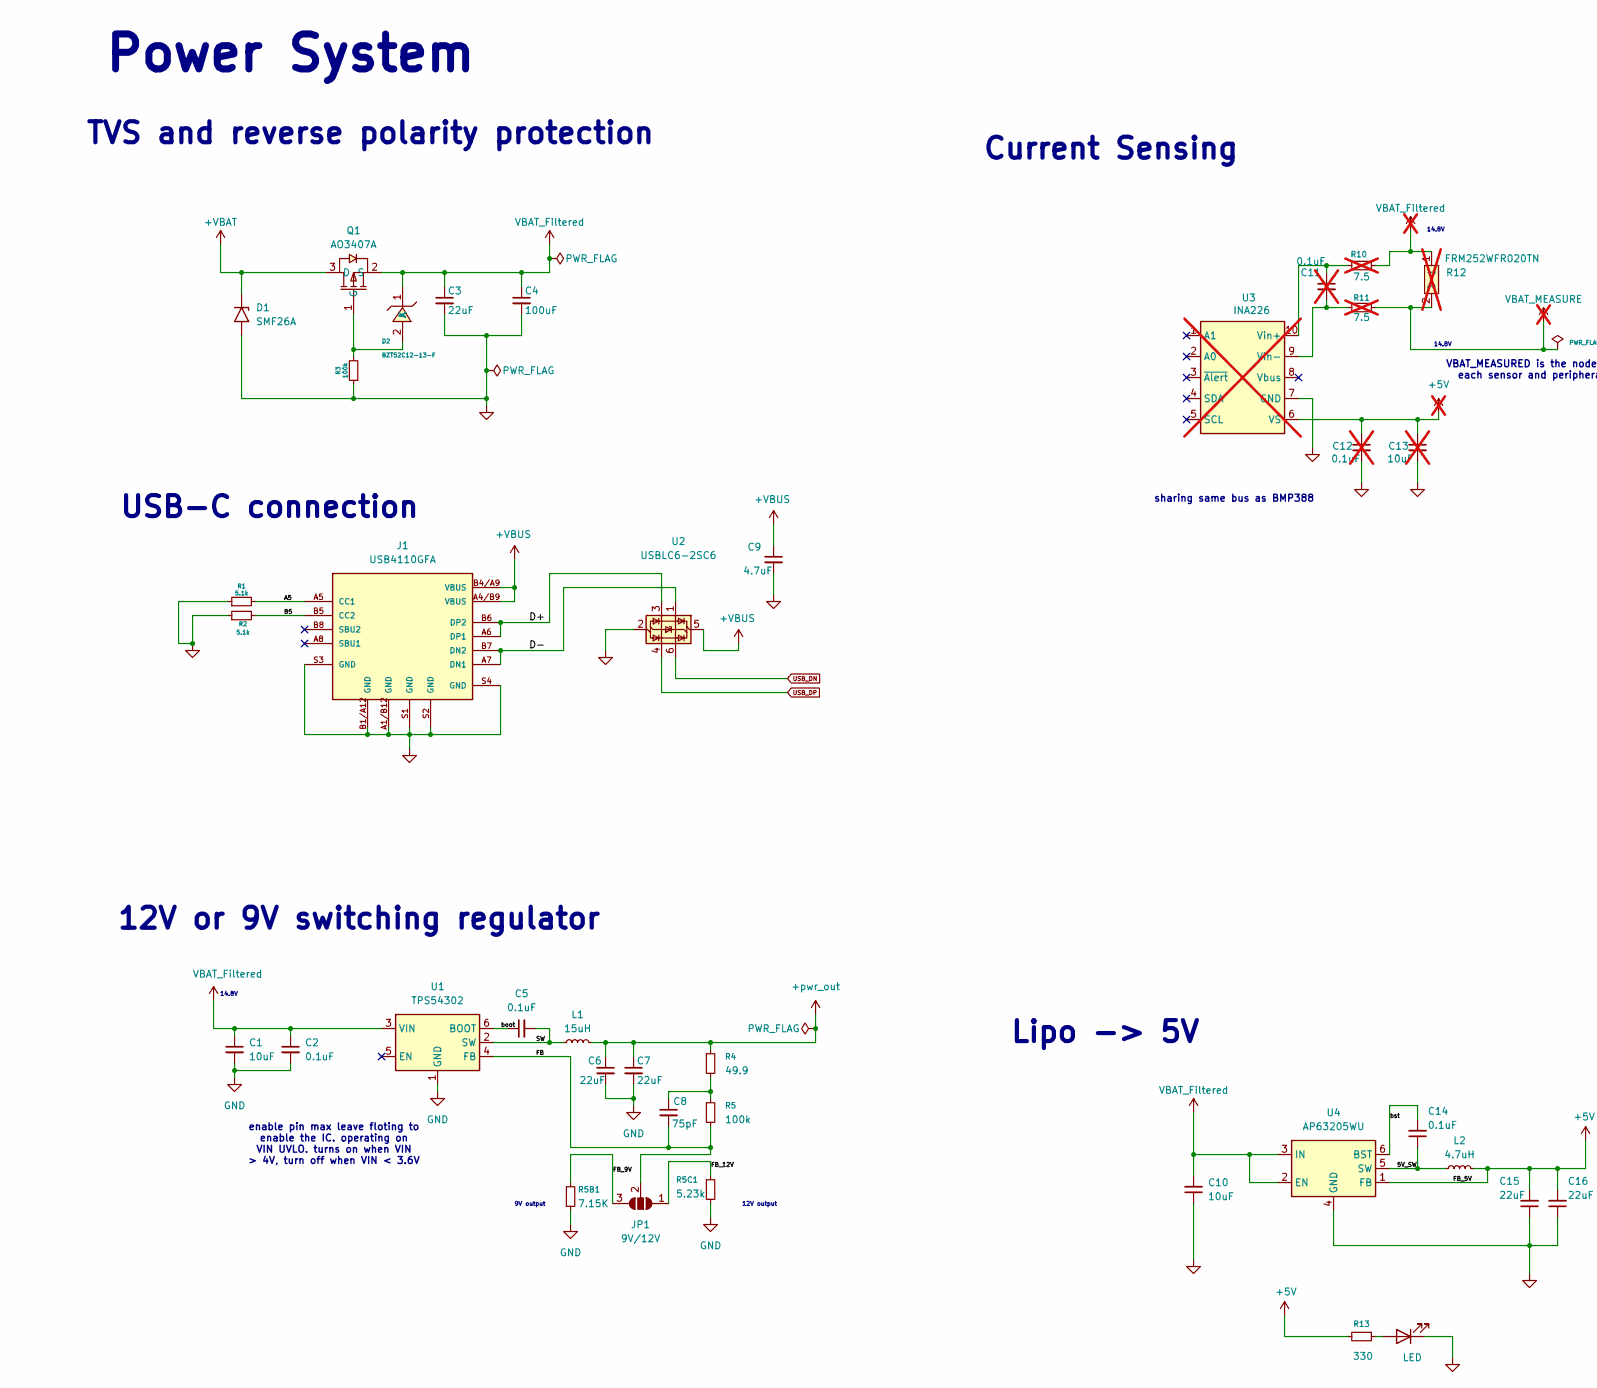
[picture p36: schematic power.kicad_sch, part in row 1, column 1]

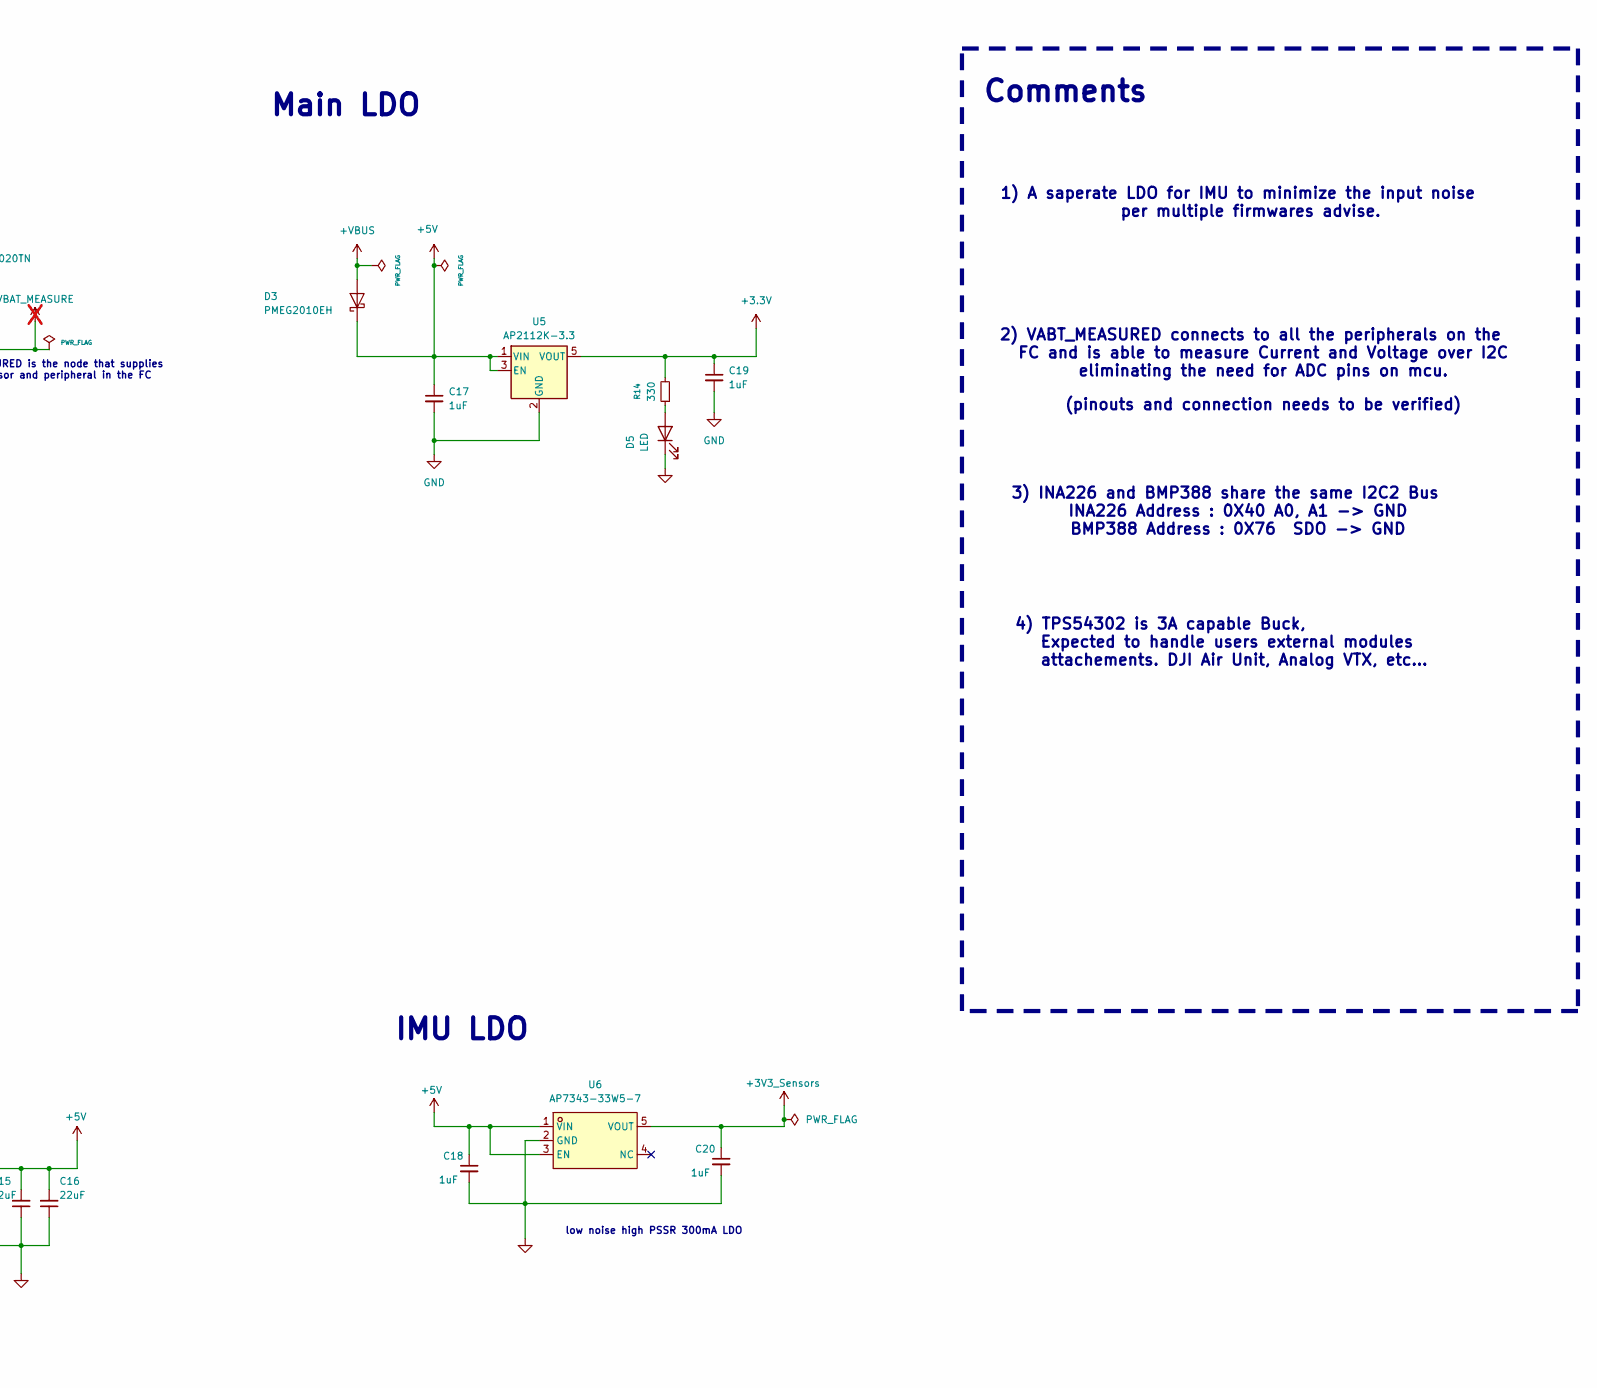
[picture p37: schematic power.kicad_sch, part in row 1, column 2]

Parts:
C1, C10: 10uF; C_0603_1608Metric
C2, C5: 0.1uF; C_0402_1005Metric
C3, C6, C7, C15, C16: 22uF; C_0603_1608Metric
C4: 100uF; C_0805_2012Metric
C8: 75pF; C_0402_1005Metric
C9: 4.7uF; C_0402_1005Metric
C11, C12: 0.1uF; C_0603_1608Metric; not fitted
C13: 10uF; C_0805_2012Metric; not fitted
C14: 0.1uF; C_0603_1608Metric
C17, C18, C19, C20: 1uF; C_0603_1608Metric
D1: SMF26A; D_SMF
D2: BZT52C12-13-F; (zener)SOD-123F_L2.8-W1.8-LS3.7-RD; LCSC Part C177013
D3: PMEG2010EH; D_SOD-123F
D4, D5: LED; LED_0805_2012Metric
J1: USB4110GFA; GCT_USB4110GFA
JP1: 9V/12V; SolderJumper-3_P1.3mm_Open_RoundedPad1.0x1.5mm_NumberLabels
L1: 15uH; IND-SMD_L5.4-W5.2
L2: 4.7uH; IND-SMD_L4.4-W4.2
Q1: AO3407A; LCSC Part C15155
R1, R2: 5.1k; R_0402_1005Metric
R3, R5: 100k; R_0402_1005Metric
R4: 49.9; R_0402_1005Metric
R5B1: 7.15K; R_0402_1005Metric
R5C1: 5.23k; R_0402_1005Metric
R10, R11: 7.5; R_0402_1005Metric; not fitted
R12: FRM252WFR020TN; R2512; LCSC Part C7420049; not fitted
R13, R14: 330; R_0402_1005Metric
U1: TPS54302; SOT-23-6
U2: USBLC6-2SC6; SOT-23-6
U3: INA226; VSSOP-10_3x3mm_P0.5mm; not fitted
U4: AP63205WU; TSOT-23-6
U5: AP2112K-3.3; SOT-23-5
U6: AP7343-33W5-7; (AP7343 )SOT-25_L3.0-W1.6-P0.95-LS2.8-BL; LCSC Part C460383

Connections:
+3.3V: C19.1, R14.2, U5.5 (VOUT); also elsewhere on the board
+3V3_Sensors: C20.1, U6.5 (VOUT); also elsewhere on the board
+5V: C12.1, C13.1, C15.2, C16.2, C17.1, C18.1, D3.1 (K), L2.2, R13.2, U3.6 (VS), U4.1 (FB), U5.1 (VIN), U5.3 (EN), U6.1 (VIN), U6.3 (EN); also elsewhere on the board
+VBAT: D1.1 (A1), Q1.3 (D); also elsewhere on the board
+VBUS: C9.1, D3.2 (A), J1.A4/B9 (VBUS), J1.B4/A9 (VBUS), U2.5 (VBUS)
+pwr_out: C6.1, C7.1, L1.2, R4.1; also elsewhere on the board
/Power/5V_SW: C14.1, L2.1, U4.5 (SW)
/Power/A5: J1.A5 (CC1), R1.2
/Power/B5: J1.B5 (CC2), R2.2
/Power/D+: J1.A6 (DP1), J1.B6 (DP2), U2.3 (I/O2)
/Power/D-: J1.A7 (DN1), J1.B7 (DN2), U2.1 (I/O1)
/Power/FB: C8.2, JP1.2 (C), R5.2, U1.4 (FB)
/Power/FB_9V: JP1.3 (B), R5B1.1
/Power/FB_12V: JP1.1 (A), R5C1.1
/Power/SW: C5.2, L1.1, U1.2 (SW)
/Power/boot: C5.1, U1.6 (BOOT)
/Power/bst: C14.2, U4.6 (BST)
GND: C1.2, C2.2, C3.2, C4.2, C6.2, C7.2, C9.2, C10.1, C12.2, C13.2, C15.1, C16.1, C17.2, C18.2, C19.2, C20.2, D1.2 (A2), D4.1 (K), D5.1 (K), J1.A1/B12 (GND), J1.B1/A12 (GND), J1.S1 (GND), J1.S2 (GND), J1.S3 (GND), J1.S4 (GND), R1.1, R2.1, R3.1, R5B1.2, R5C1.2, U1.1 (GND), U2.2 (GND), U3.7 (GND), U4.4 (GND), U5.2 (GND), U6.2 (GND); also elsewhere on the board
unnamed: C8.1, R4.2, R5.1
unnamed: C11.1, R10.1, U3.10 (Vin+)
unnamed: C11.2, R11.1, U3.9 (Vin-)
unnamed: D2.2 (A), Q1.1 (G), R3.2
unnamed: D4.2 (A), R13.1
unnamed: D5.2 (A), R14.1
unnamed: R11.2, R12.2
USB_DN: U2.6 (I/O1); also elsewhere on the board
USB_DP: U2.4 (I/O2); also elsewhere on the board
VBAT_Filtered: C1.1, C2.1, C3.1, C4.1, C10.2, D2.1 (K), Q1.2 (S), R10.2, R12.1, U1.3 (VIN), U4.2 (EN), U4.3 (IN)

Notes on the sheet:
Lipo -> 5V
Power System
2) VABT_MEASURED connects to all the peripherals on the FC and is able to measure Current and Voltage over I2C eliminating the need for ADC pins on mcu.
low noise high PSSR 300mA LDO
(pinouts and connection needs to be verified)
VBAT_MEASURED is the node that supplies each sensor and peripheral in the FC
9V output
12V output
IMU LDO
TVS and reverse polarity protection
4) TPS54302 is 3A capable Buck, Expected to handle users external modules attachements. DJI Air Unit, Analog VTX, etc...
sharing same bus as BMP388
Comments
3) INA226 and BMP388 share the same I2C2 Bus INA226 Address : 0X40 A0, A1 -> GND BMP388 Address : 0X76 SDO -> GND
14.8V
Current Sensing
12V or 9V switching regulator
USB-C connection
1) A saperate LDO for IMU to minimize the input noise per multiple firmwares advise.
Main LDO
enable pin max leave floting to enable the IC. operating on VIN UVLO. turns on when VIN > 4V, turn off when VIN < 3.6V

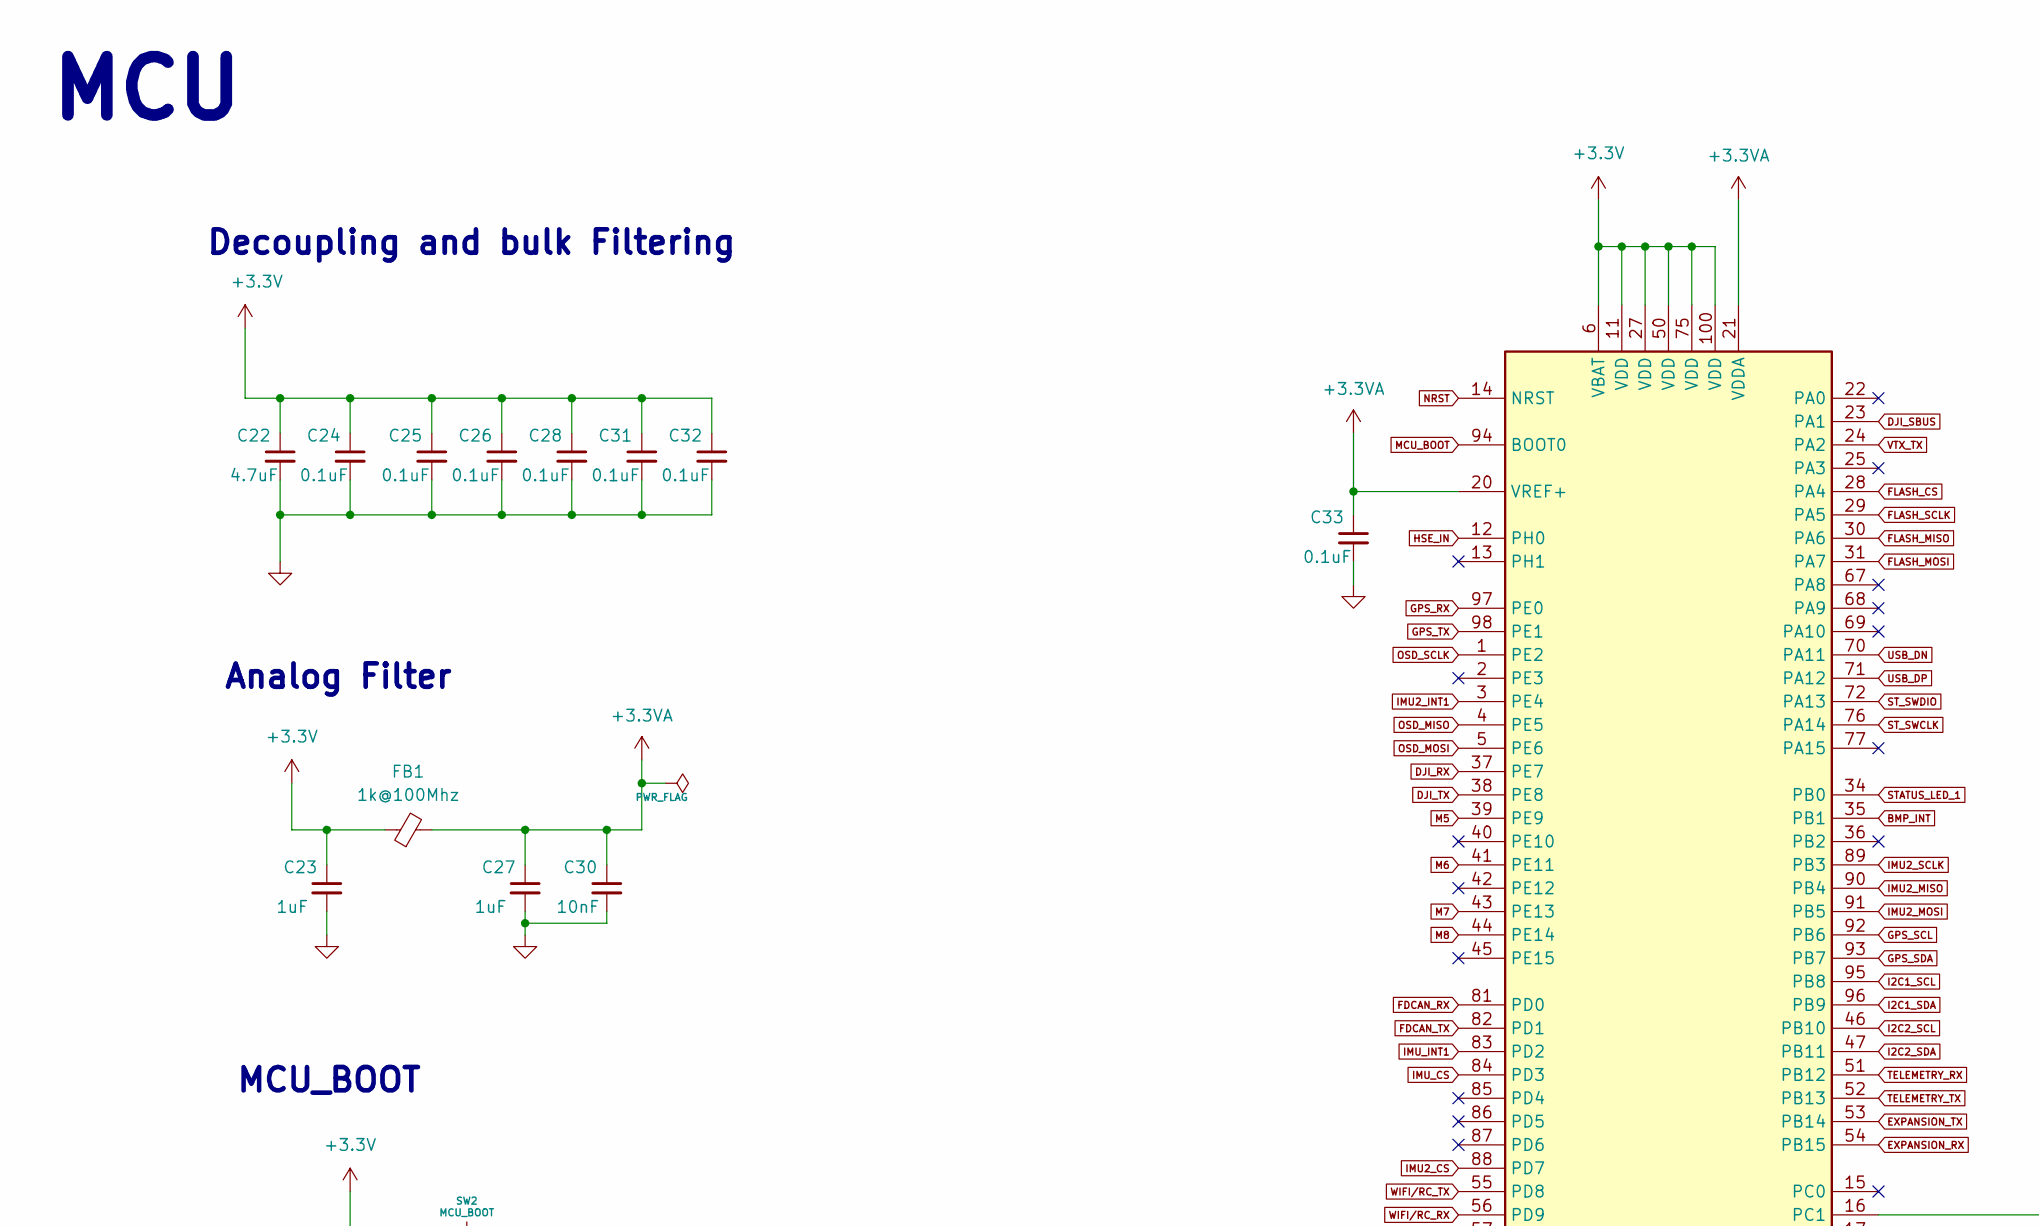
[picture p38: schematic MCU.kicad_sch, part in row 1, column 1]

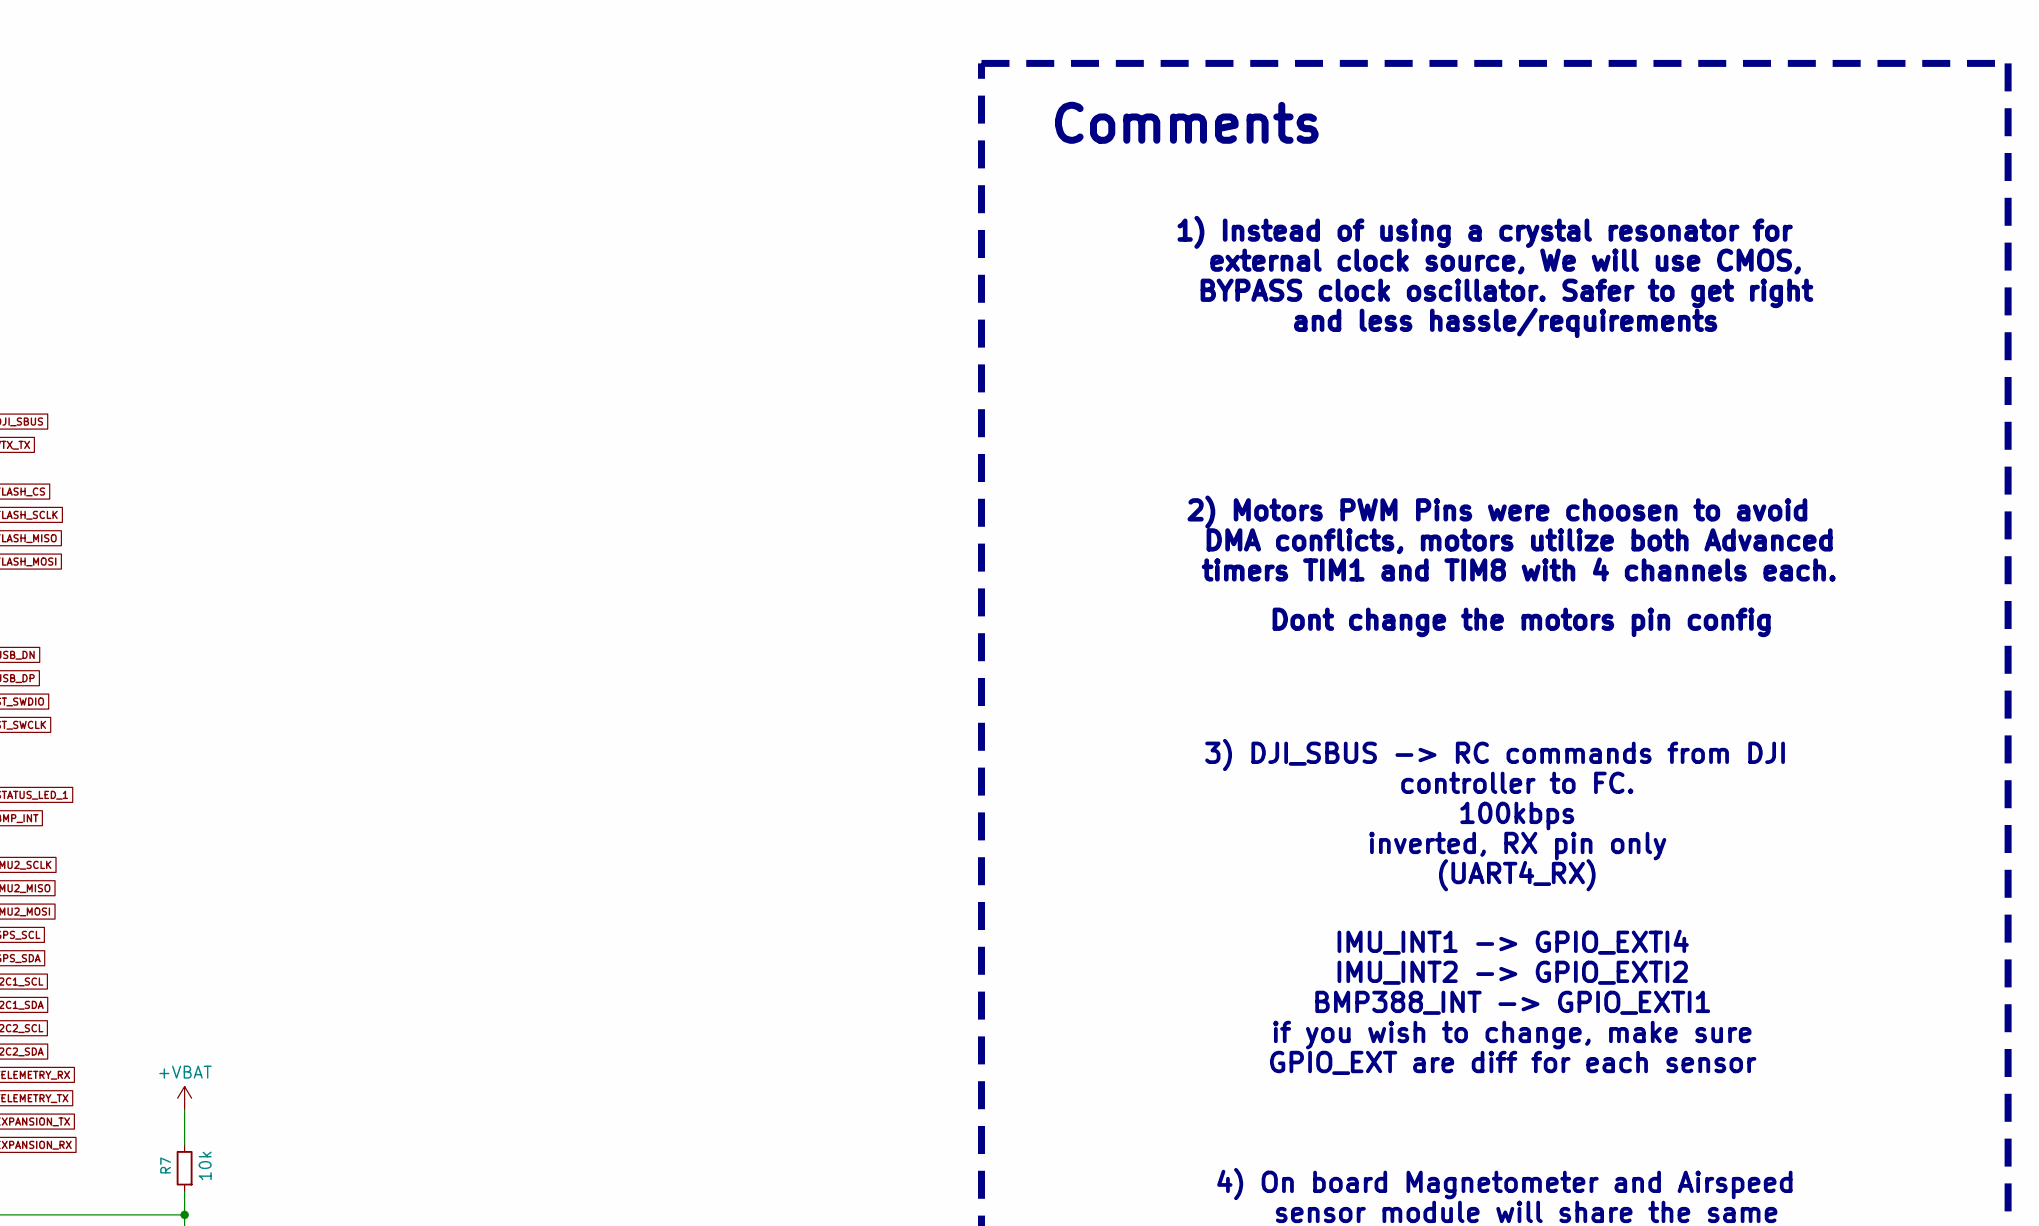
[picture p39: schematic MCU.kicad_sch, part in row 1, column 2]

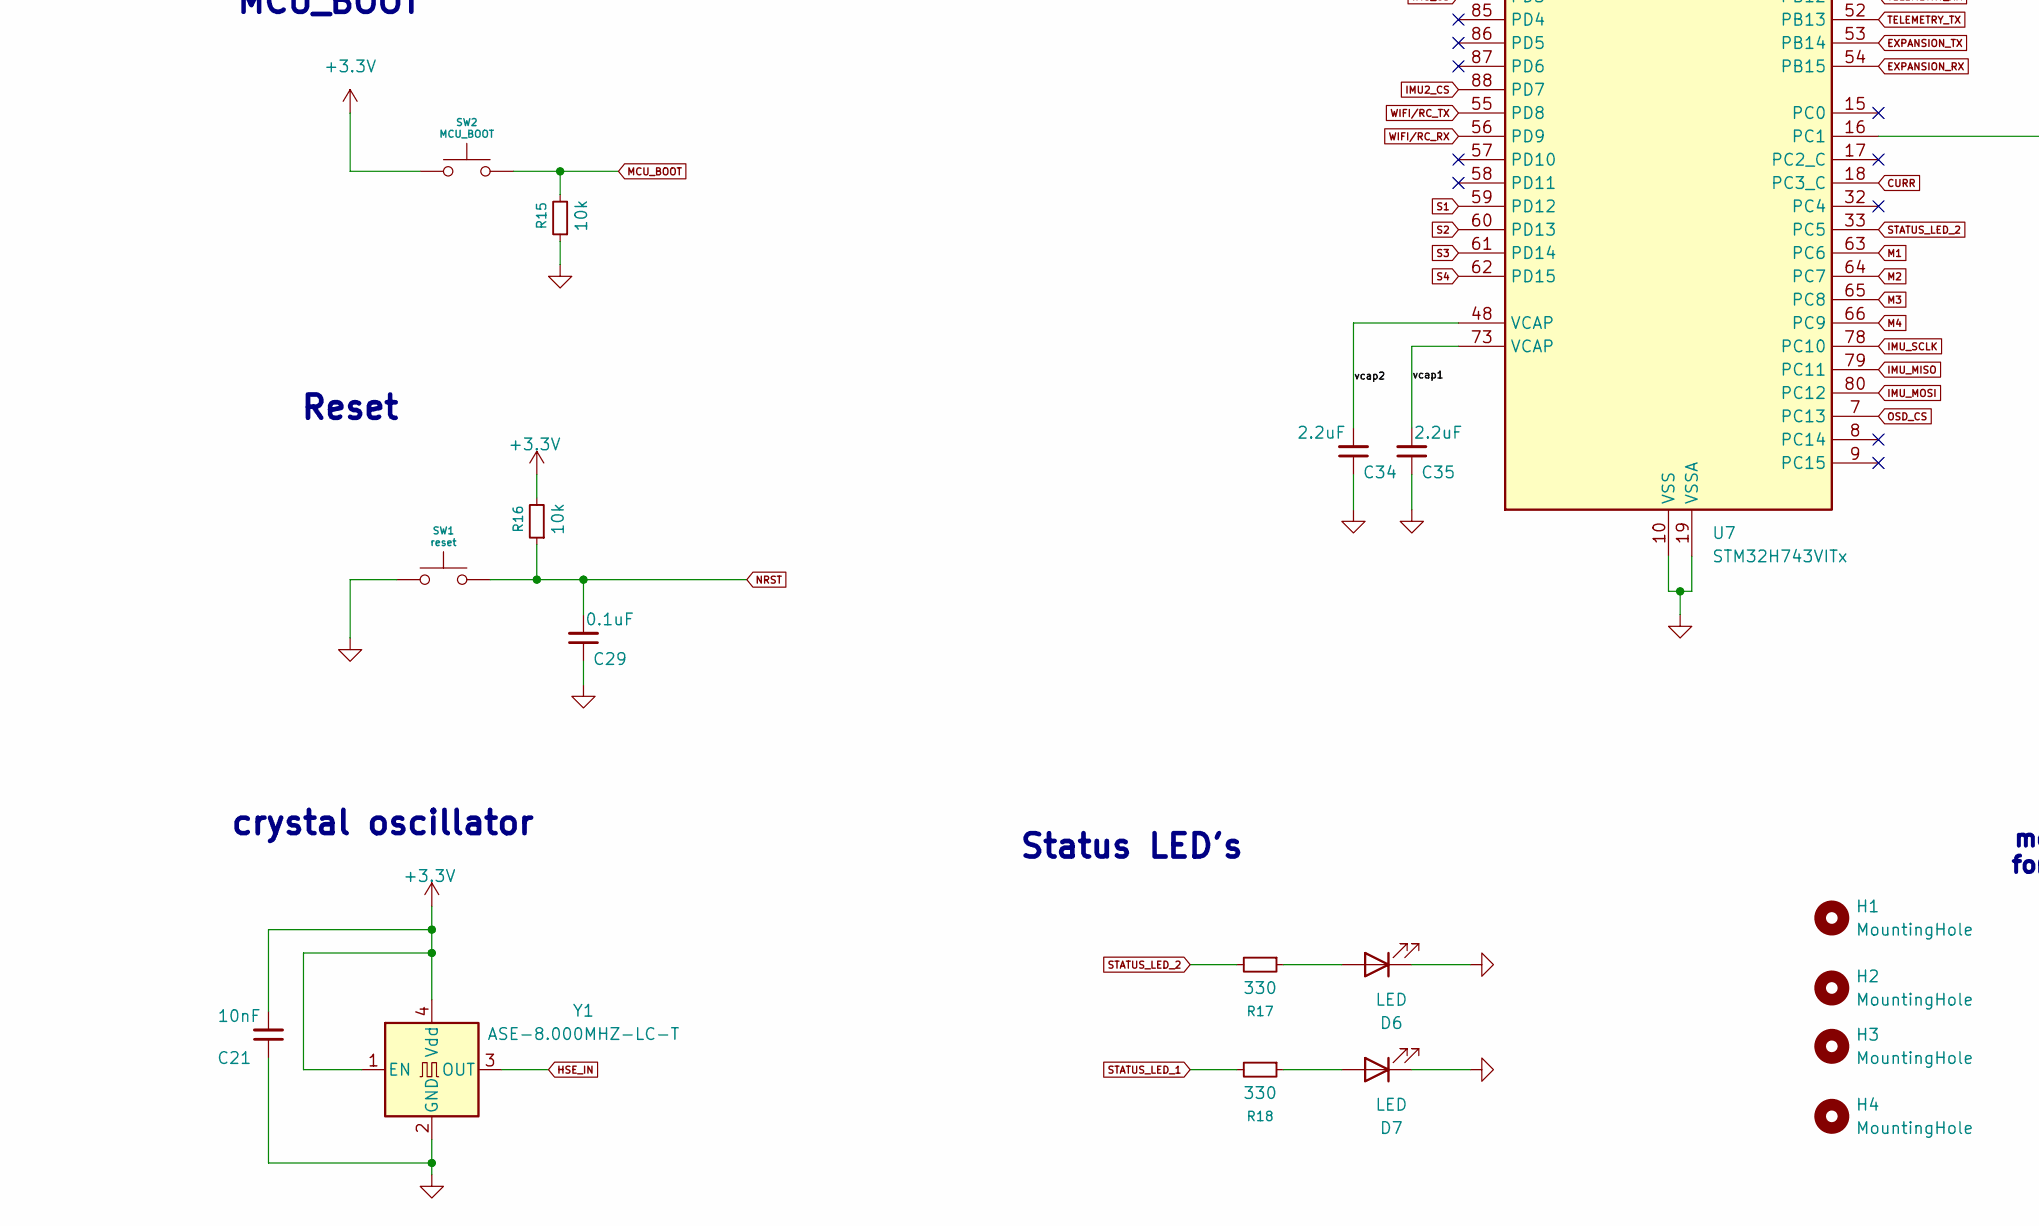
[picture p40: schematic MCU.kicad_sch, part in row 2, column 1]

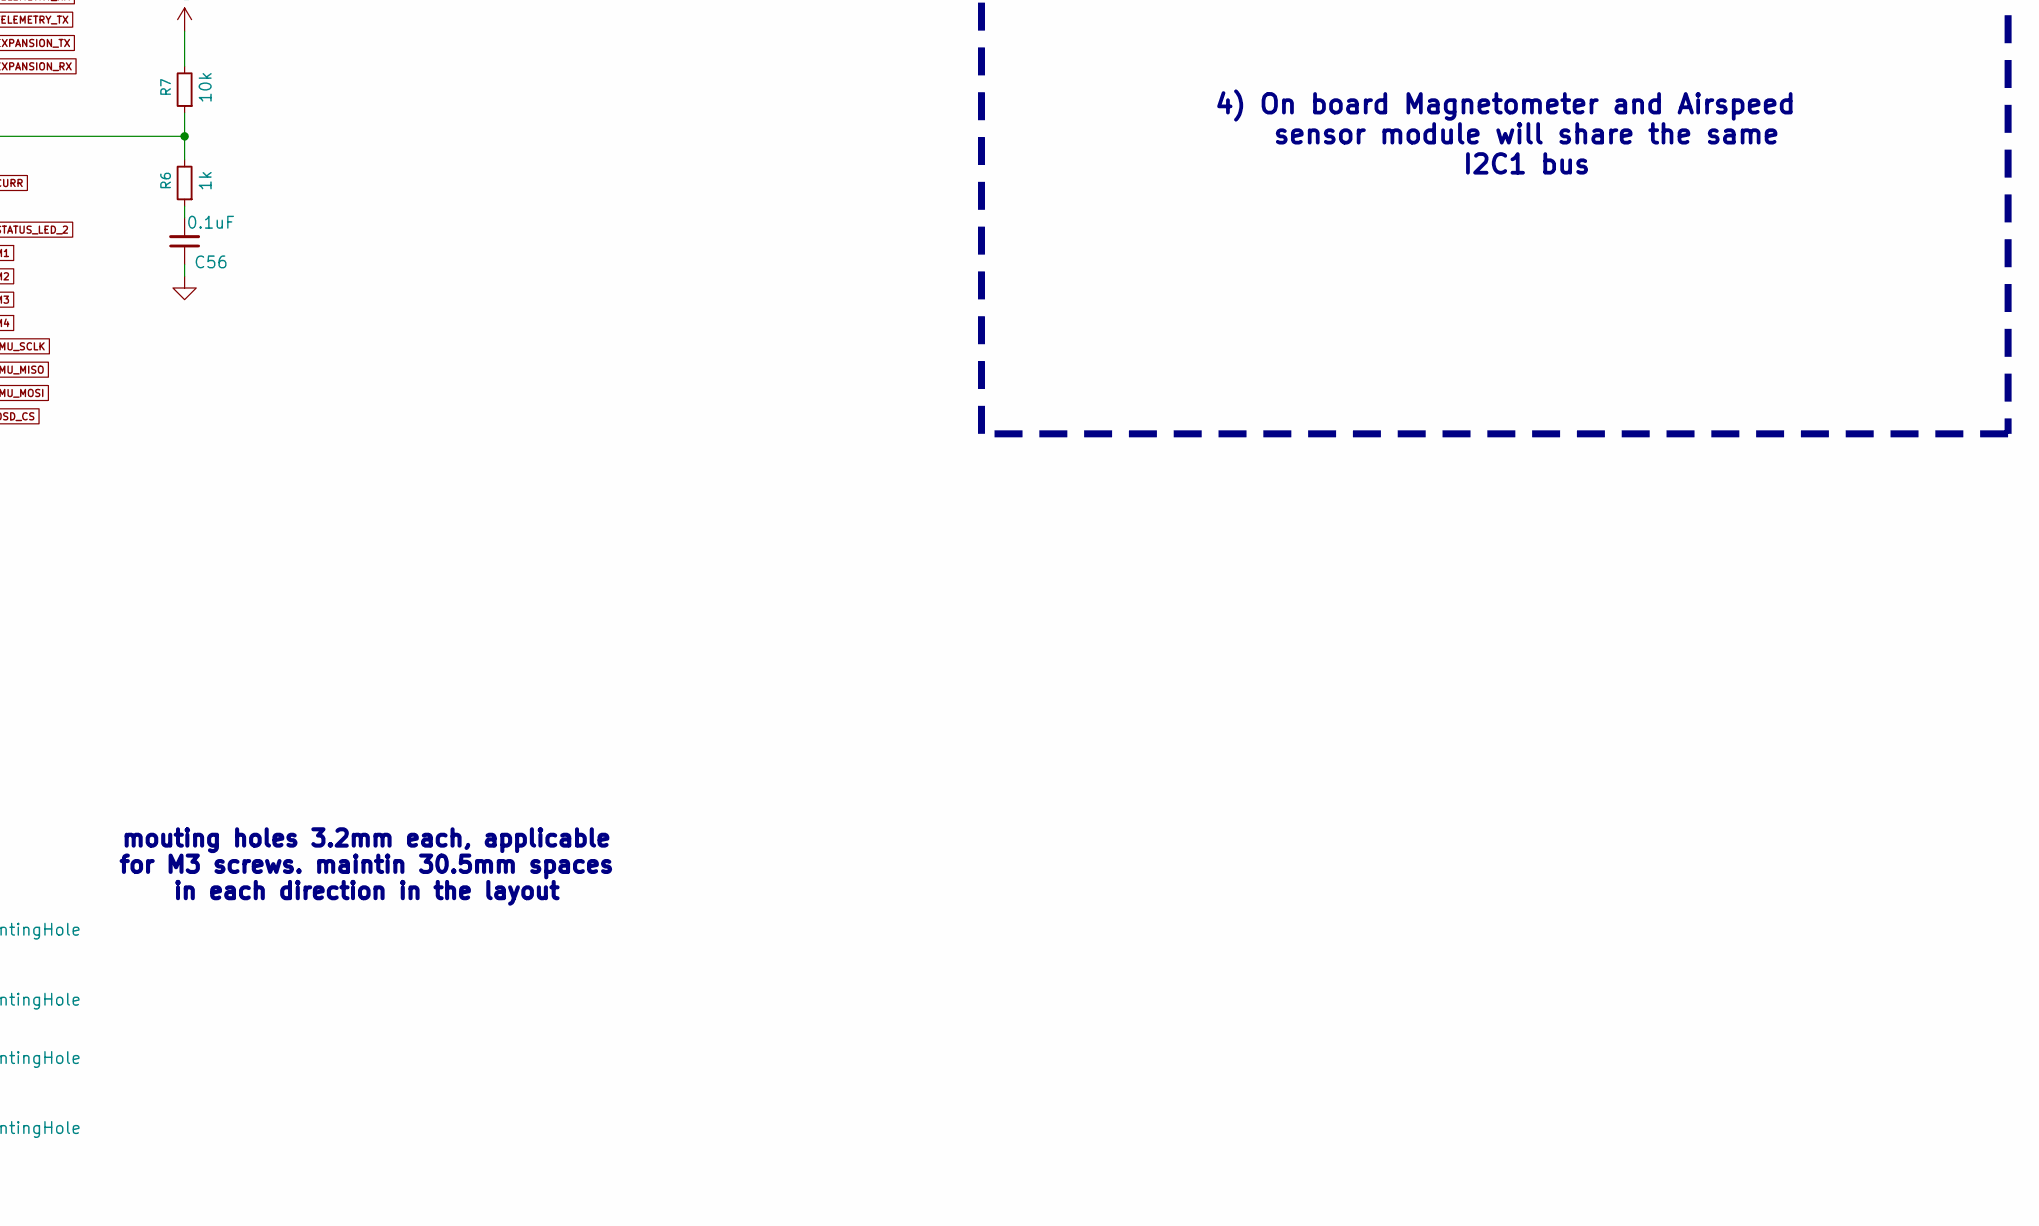
[picture p41: schematic MCU.kicad_sch, part in row 2, column 2]

Parts:
C21: 10nF; C_0603_1608Metric
C22: 4.7uF; C_0603_1608Metric
C23, C27: 1uF; C_0603_1608Metric
C24, C25, C26, C28, C29, C31, C32, C56: 0.1uF; C_0402_1005Metric
C30: 10nF; C_0402_1005Metric
C33: 0.1uF; C_0603_1608Metric
C34, C35: 2.2uF; C_0603_1608Metric
D6, D7: LED; LED_0805_2012Metric
FB1: 1k@100Mhz; L_0603_1608Metric
H1, H2, H3, H4: MountingHole; MountingHole_3.2mm_M3_Pad_Via
R6: 1k; R_0402_1005Metric
R7, R15, R16: 10k; R_0402_1005Metric
R17, R18: 330; R_0402_1005Metric
SW1: reset; SW_Push_SPST_NO_Alps_SKRK
SW2: MCU_BOOT; SW_Push_SPST_NO_Alps_SKRK
U7: STM32H743VITx; LQFP-100_14x14mm_P0.5mm
Y1: ASE-8.000MHZ-LC-T; Oscillator_SMD_Abracon_ASE-4Pin_3.2x2.5mm

Connections:
+3.3V: C21.2, C22.1, C23.1, C24.1, C25.1, C26.1, C28.1, C31.1, C32.1, FB1.1, R16.2, SW2.1, U7.6 (VBAT), U7.11 (VDD), U7.27 (VDD), U7.50 (VDD), U7.75 (VDD), U7.100 (VDD), Y1.1 (EN), Y1.4 (Vdd); also elsewhere on the board
+3.3VA: C27.1, C30.1, C33.1, FB1.2, U7.20 (VREF+), U7.21 (VDDA)
+VBAT: R7.2; also elsewhere on the board
/MCU/vcap1: C35.2, U7.73 (VCAP)
/MCU/vcap2: C34.2, U7.48 (VCAP)
BMP_INT: U7.35 (PB1); also elsewhere on the board
CURR: U7.18 (PC3_C); also elsewhere on the board
DJI_RX: U7.37 (PE7); also elsewhere on the board
DJI_SBUS: U7.23 (PA1); also elsewhere on the board
DJI_TX: U7.38 (PE8); also elsewhere on the board
EXPANSION_RX: U7.54 (PB15); also elsewhere on the board
EXPANSION_TX: U7.53 (PB14); also elsewhere on the board
FDCAN_RX: U7.81 (PD0); also elsewhere on the board
FDCAN_TX: U7.82 (PD1); also elsewhere on the board
FLASH_CS: U7.28 (PA4); also elsewhere on the board
FLASH_MISO: U7.30 (PA6); also elsewhere on the board
FLASH_MOSI: U7.31 (PA7); also elsewhere on the board
FLASH_SCLK: U7.29 (PA5); also elsewhere on the board
GND: C21.1, C22.2, C23.2, C24.2, C25.2, C26.2, C27.2, C28.2, C29.1, C30.2, C31.2, C32.2, C33.2, C34.1, C35.1, C56.1, D6.1 (K), D7.1 (K), R15.1, SW1.1, U7.10 (VSS), U7.19 (VSSA), U7.26 (VSS), U7.49 (VSS), U7.74 (VSS), U7.99 (VSS), Y1.2 (GND); also elsewhere on the board
GPS_RX: U7.97 (PE0); also elsewhere on the board
GPS_SCL: U7.92 (PB6); also elsewhere on the board
GPS_SDA: U7.93 (PB7); also elsewhere on the board
GPS_TX: U7.98 (PE1); also elsewhere on the board
HSE_IN: U7.12 (PH0), Y1.3 (OUT)
I2C1_SCL: U7.95 (PB8); also elsewhere on the board
I2C1_SDA: U7.96 (PB9); also elsewhere on the board
I2C2_SCL: U7.46 (PB10); also elsewhere on the board
I2C2_SDA: U7.47 (PB11); also elsewhere on the board
IMU2_CS: U7.88 (PD7); also elsewhere on the board
IMU2_INT1: U7.3 (PE4); also elsewhere on the board
IMU2_MISO: U7.90 (PB4); also elsewhere on the board
IMU2_MOSI: U7.91 (PB5); also elsewhere on the board
IMU2_SCLK: U7.89 (PB3); also elsewhere on the board
IMU_CS: U7.84 (PD3); also elsewhere on the board
IMU_INT1: U7.83 (PD2); also elsewhere on the board
IMU_MISO: U7.79 (PC11); also elsewhere on the board
IMU_MOSI: U7.80 (PC12); also elsewhere on the board
IMU_SCLK: U7.78 (PC10); also elsewhere on the board
M1: U7.63 (PC6); also elsewhere on the board
M2: U7.64 (PC7); also elsewhere on the board
M3: U7.65 (PC8); also elsewhere on the board
M4: U7.66 (PC9); also elsewhere on the board
M5: U7.39 (PE9); also elsewhere on the board
M6: U7.41 (PE11); also elsewhere on the board
M7: U7.43 (PE13); also elsewhere on the board
M8: U7.44 (PE14); also elsewhere on the board
MCU_BOOT: R15.2, SW2.2, U7.94 (BOOT0)
NRST: C29.2, R16.1, SW1.2, U7.14 (NRST)
unnamed: C56.2, R6.1
unnamed: D6.2 (A), R17.1
unnamed: D7.2 (A), R18.1
unnamed: R6.2, R7.1, U7.16 (PC1)
OSD_CS: U7.7 (PC13); also elsewhere on the board
OSD_MISO: U7.4 (PE5); also elsewhere on the board
OSD_MOSI: U7.5 (PE6); also elsewhere on the board
OSD_SCLK: U7.1 (PE2); also elsewhere on the board
S1: U7.59 (PD12); also elsewhere on the board
S2: U7.60 (PD13); also elsewhere on the board
S3: U7.61 (PD14); also elsewhere on the board
S4: U7.62 (PD15); also elsewhere on the board
STATUS_LED_1: R18.2, U7.34 (PB0)
STATUS_LED_2: R17.2, U7.33 (PC5)
ST_SWCLK: U7.76 (PA14); also elsewhere on the board
ST_SWDIO: U7.72 (PA13); also elsewhere on the board
TELEMETRY_RX: U7.51 (PB12); also elsewhere on the board
TELEMETRY_TX: U7.52 (PB13); also elsewhere on the board
USB_DN: U7.70 (PA11); also elsewhere on the board
USB_DP: U7.71 (PA12); also elsewhere on the board
VTX_TX: U7.24 (PA2); also elsewhere on the board
WIFI/RC_RX: U7.56 (PD9); also elsewhere on the board
WIFI/RC_TX: U7.55 (PD8); also elsewhere on the board

Notes on the sheet:
Analog Filter
Reset
4) On board Magnetometer and Airspeed sensor module will share the same I2C1 bus
mouting holes 3.2mm each, applicable for M3 screws. maintin 30.5mm spaces in each direction in the layout
1) Instead of using a crystal resonator for external clock source, We will use CMOS, BYPASS clock oscillator. Safer to get right and less hassle/requirements
Comments
MCU
2) Motors PWM Pins were choosen to avoid DMA conflicts, motors utilize both Advanced timers TIM1 and TIM8 with 4 channels each.
3) DJI_SBUS -> RC commands from DJI controller to FC. 100kbps inverted, RX pin only (UART4_RX)
MCU_BOOT
crystal oscillator
IMU_INT1 -> GPIO_EXTI4 IMU_INT2 -> GPIO_EXTI2 BMP388_INT -> GPIO_EXTI1 if you wish to change, make sure GPIO_EXT are diff for each sensor
Dont change the motors pin config
Decoupling and bulk Filtering
Status LED's
