salehali22/Flight-Controller/Hardware/Flight Controller.kicad_pcb

## KiCad design Hardware/Flight Controller.kicad_pcb (continued)

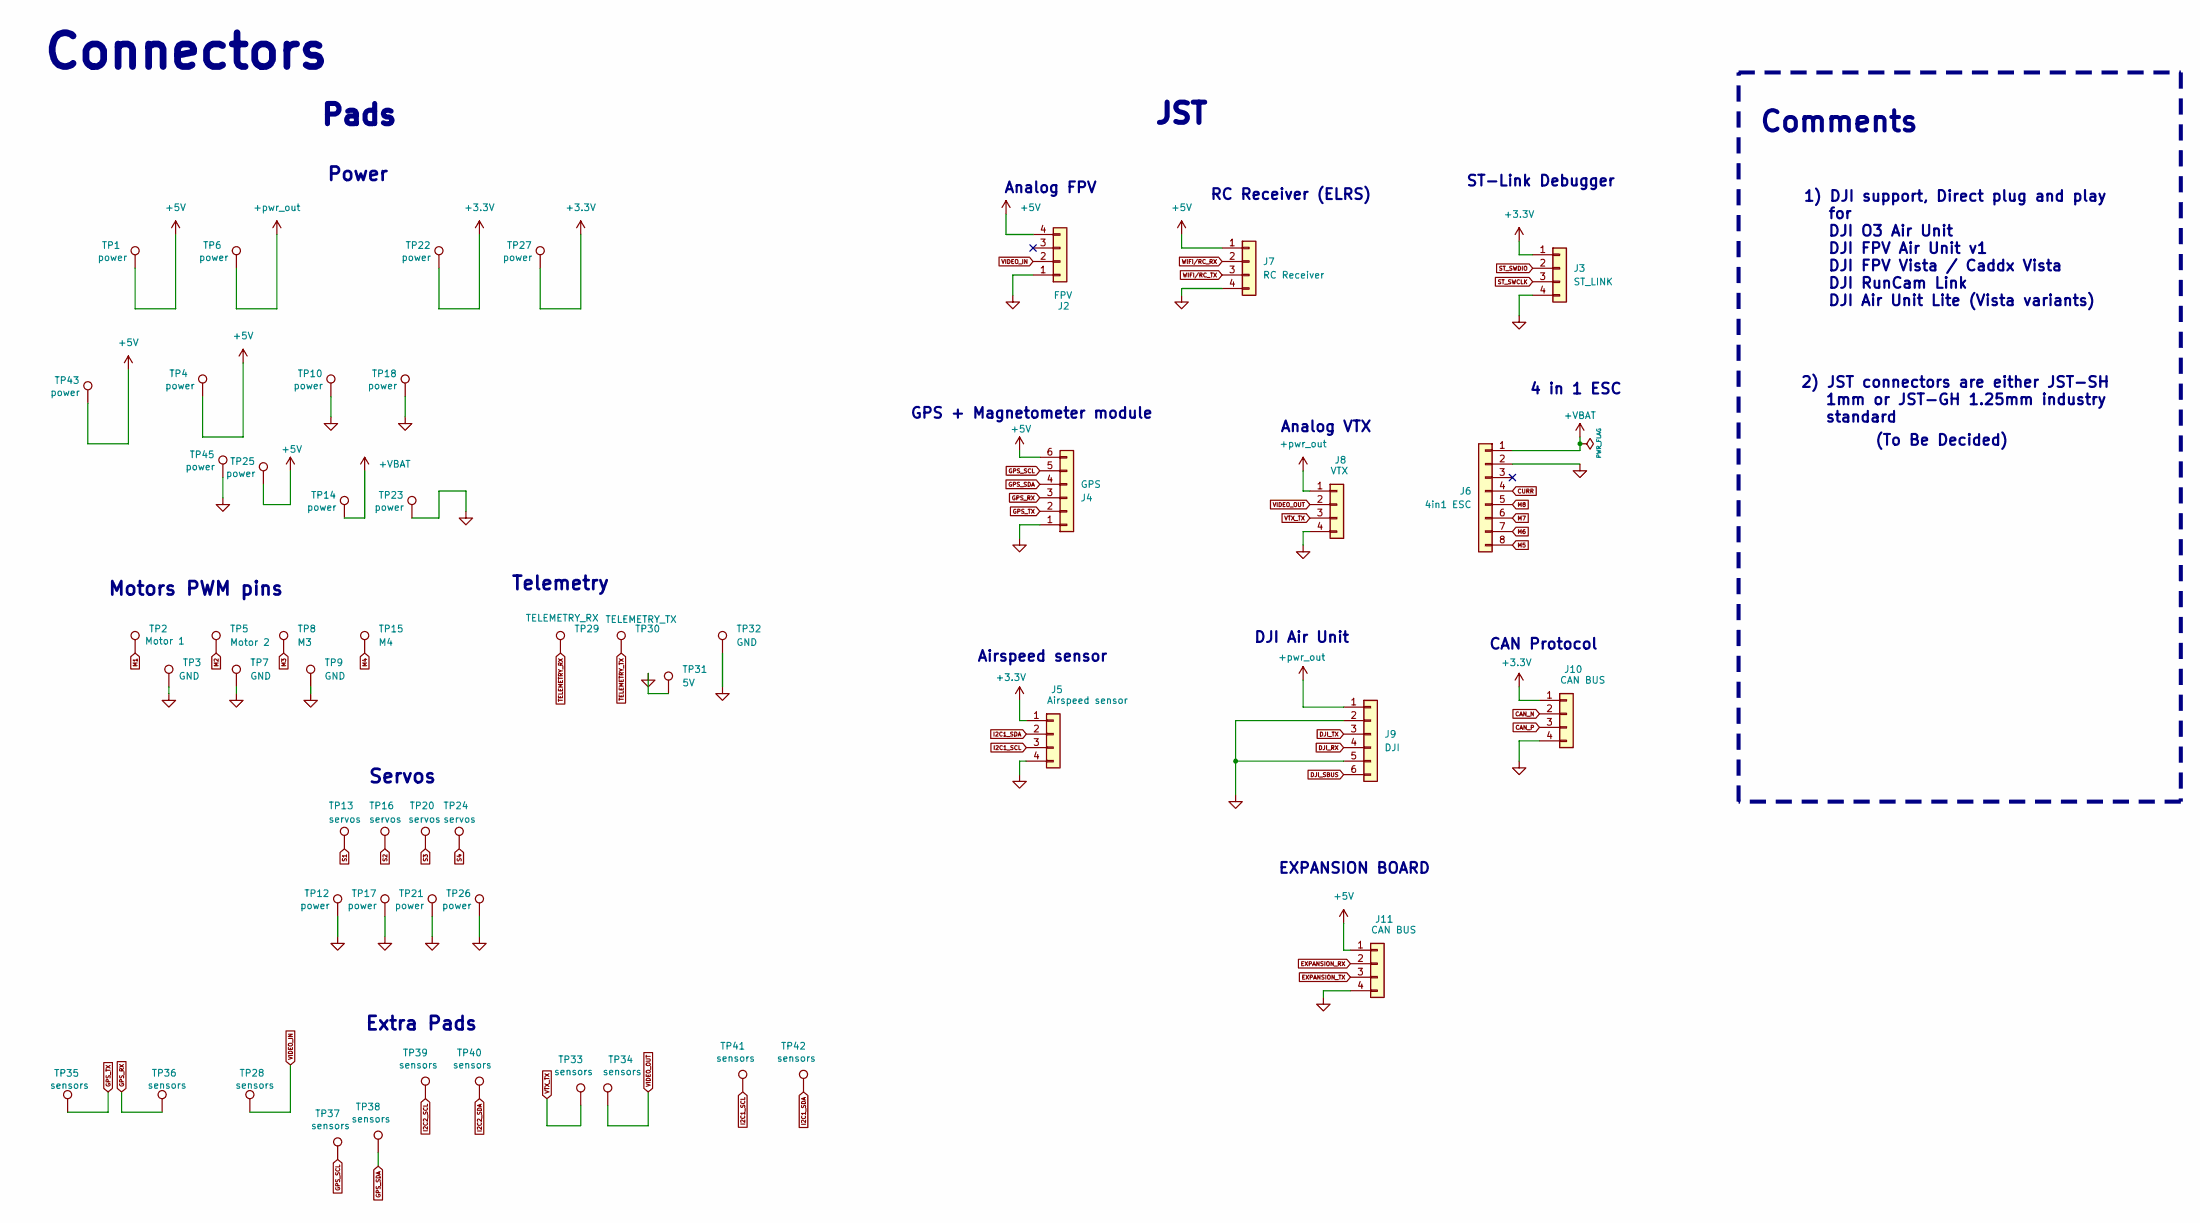
[picture p42: schematic connectors.kicad_sch]

Parts:
J2: FPV; CONN-SMD_4P-P1.00_SM04B-SRSS-TB-LF-SN
J3: ST_LINK; CONN-SMD_4P-P1.00_SM04B-SRSS-TB-LF-SN
J4: GPS; JST_SH_SM06B-SRSS-TB_1x06-1MP_P1.00mm_Horizontal
J5: Airspeed sensor; CONN-SMD_4P-P1.00_SM04B-SRSS-TB-LF-SN
J6: 4in1 ESC; JST_SH_SM08B-SRSS-TB_1x08-1MP_P1.00mm_Horizontal
J7: RC Receiver; CONN-SMD_4P-P1.00_SM04B-SRSS-TB-LF-SN
J8: VTX; CONN-SMD_4P-P1.00_SM04B-SRSS-TB-LF-SN
J9: DJI; JST_GH_SM06B-GHS-TB_1x06-1MP_P1.25mm_Horizontal
J10: CAN BUS; JST_GH_SM04B-GHS-TB_1x04-1MP_P1.25mm_Horizontal
J11: CAN BUS; CONN-SMD_4P-P1.00_SM04B-SRSS-TB-LF-SN
TP1, TP4, TP6, TP10, TP12, TP17, TP18, TP21, TP22, TP25, TP26, TP27, TP43, TP45: power; Solderpad
TP2: Motor 1; Solderpad
TP3, TP7, TP9, TP32: GND; Solderpad
TP5: Motor 2; Solderpad
TP8: M3; Solderpad
TP13, TP16, TP20, TP24: servos; Solderpad
TP14, TP23: power; BAT pad
TP15: M4; Solderpad
TP28, TP33, TP34, TP35, TP36, TP37, TP38, TP39, TP40, TP41, TP42: sensors; Solderpad
TP29: TELEMETRY_RX; Solderpad
TP30: TELEMETRY_TX; Solderpad
TP31: 5V; Solderpad

Connections:
+3.3V: J3.1, J5.1, J10.1, TP22.1, TP27.1; also elsewhere on the board
+5V: J2.4, J4.6, J7.1, J11.1, TP1.1, TP4.1, TP25.1, TP43.1; also elsewhere on the board
+VBAT: J6.1, TP14.1; also elsewhere on the board
+pwr_out: J8.1, J9.1, TP6.1; also elsewhere on the board
CAN_N: J10.2; also elsewhere on the board
CAN_P: J10.3; also elsewhere on the board
CURR: J6.4; also elsewhere on the board
DJI_RX: J9.4; also elsewhere on the board
DJI_SBUS: J9.6; also elsewhere on the board
DJI_TX: J9.3; also elsewhere on the board
EXPANSION_RX: J11.2; also elsewhere on the board
EXPANSION_TX: J11.3; also elsewhere on the board
GND: J2.1, J3.4, J4.1, J5.4, J6.2, J7.4, J8.4, J9.2, J9.5, J10.4, J11.4, TP3.1, TP7.1, TP9.1, TP10.1, TP12.1, TP17.1, TP18.1, TP21.1, TP23.1, TP26.1, TP31.1, TP32.1, TP45.1; also elsewhere on the board
GPS_RX: J4.3, TP36.1; also elsewhere on the board
GPS_SCL: J4.5, TP37.1; also elsewhere on the board
GPS_SDA: J4.4, TP38.1; also elsewhere on the board
GPS_TX: J4.2, TP35.1; also elsewhere on the board
I2C1_SCL: J5.3, TP41.1; also elsewhere on the board
I2C1_SDA: J5.2, TP42.1; also elsewhere on the board
I2C2_SCL: TP39.1; also elsewhere on the board
I2C2_SDA: TP40.1; also elsewhere on the board
M1: TP2.1; also elsewhere on the board
M2: TP5.1; also elsewhere on the board
M3: TP8.1; also elsewhere on the board
M4: TP15.1; also elsewhere on the board
M5: J6.8; also elsewhere on the board
M6: J6.7; also elsewhere on the board
M7: J6.6; also elsewhere on the board
M8: J6.5; also elsewhere on the board
S1: TP13.1; also elsewhere on the board
S2: TP16.1; also elsewhere on the board
S3: TP20.1; also elsewhere on the board
S4: TP24.1; also elsewhere on the board
ST_SWCLK: J3.3; also elsewhere on the board
ST_SWDIO: J3.2; also elsewhere on the board
TELEMETRY_RX: TP29.1; also elsewhere on the board
TELEMETRY_TX: TP30.1; also elsewhere on the board
VIDEO_IN: J2.2, TP28.1; also elsewhere on the board
VIDEO_OUT: J8.2, TP34.1; also elsewhere on the board
VTX_TX: J8.3, TP33.1; also elsewhere on the board
WIFI/RC_RX: J7.2; also elsewhere on the board
WIFI/RC_TX: J7.3; also elsewhere on the board

Notes on the sheet:
Servos
JST
RC Receiver (ELRS)
ST-Link Debugger
GPS + Magnetometer module
4 in 1 ESC
Power
Telemetry
CAN Protocol
EXPANSION BOARD
Comments
Airspeed sensor
2) JST connectors are either JST-SH 1mm or JST-GH 1.25mm industry standard
1) DJI support, Direct plug and play for DJI O3 Air Unit DJI FPV Air Unit v1 DJI FPV Vista / Caddx Vista DJI RunCam Link DJI Air Unit Lite (Vista variants)
Extra Pads
Analog VTX
DJI Air Unit
(To Be Decided)
Connectors
Pads
Analog FPV
Motors PWM pins

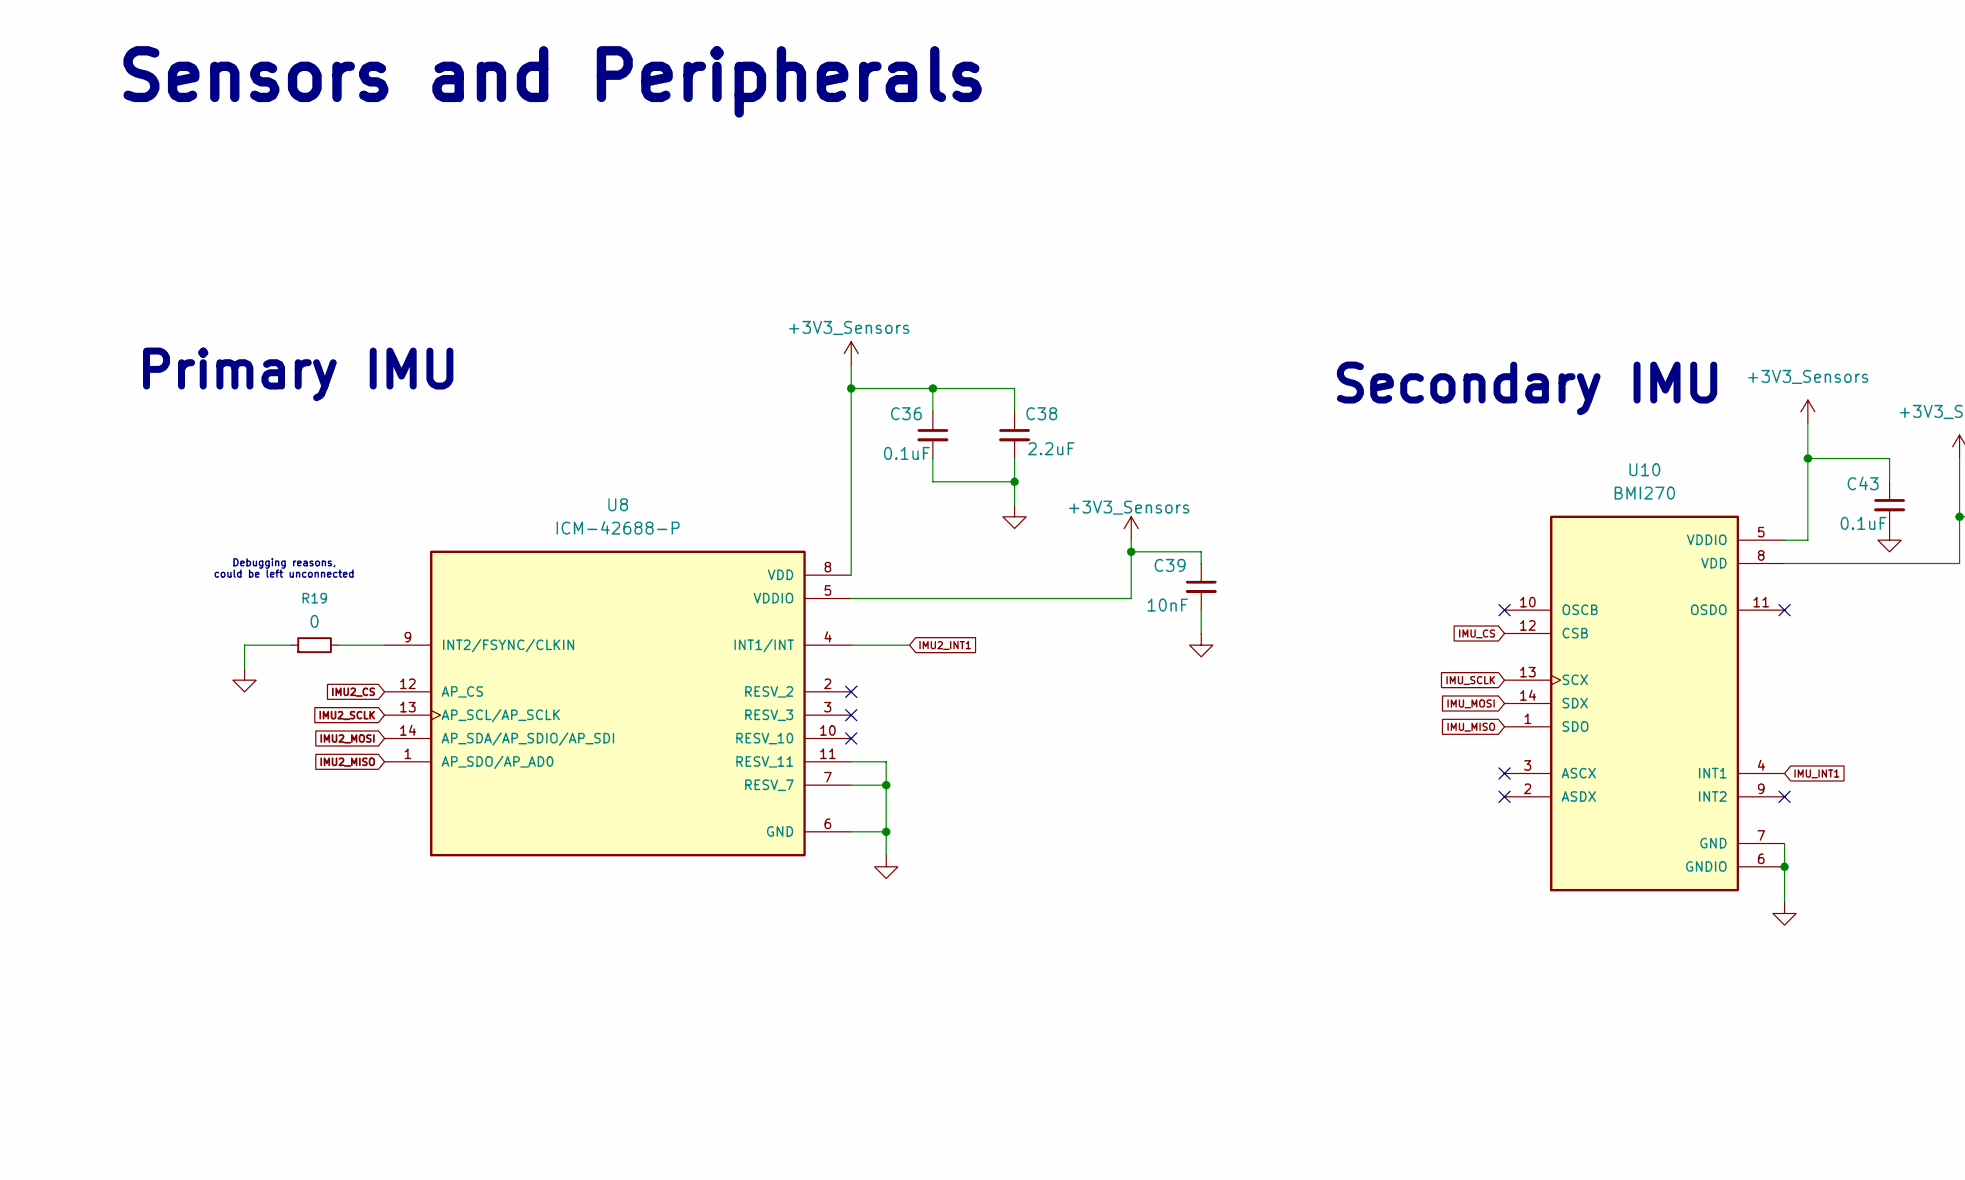
[picture p43: schematic Sensors.kicad_sch, part in row 1, column 1]

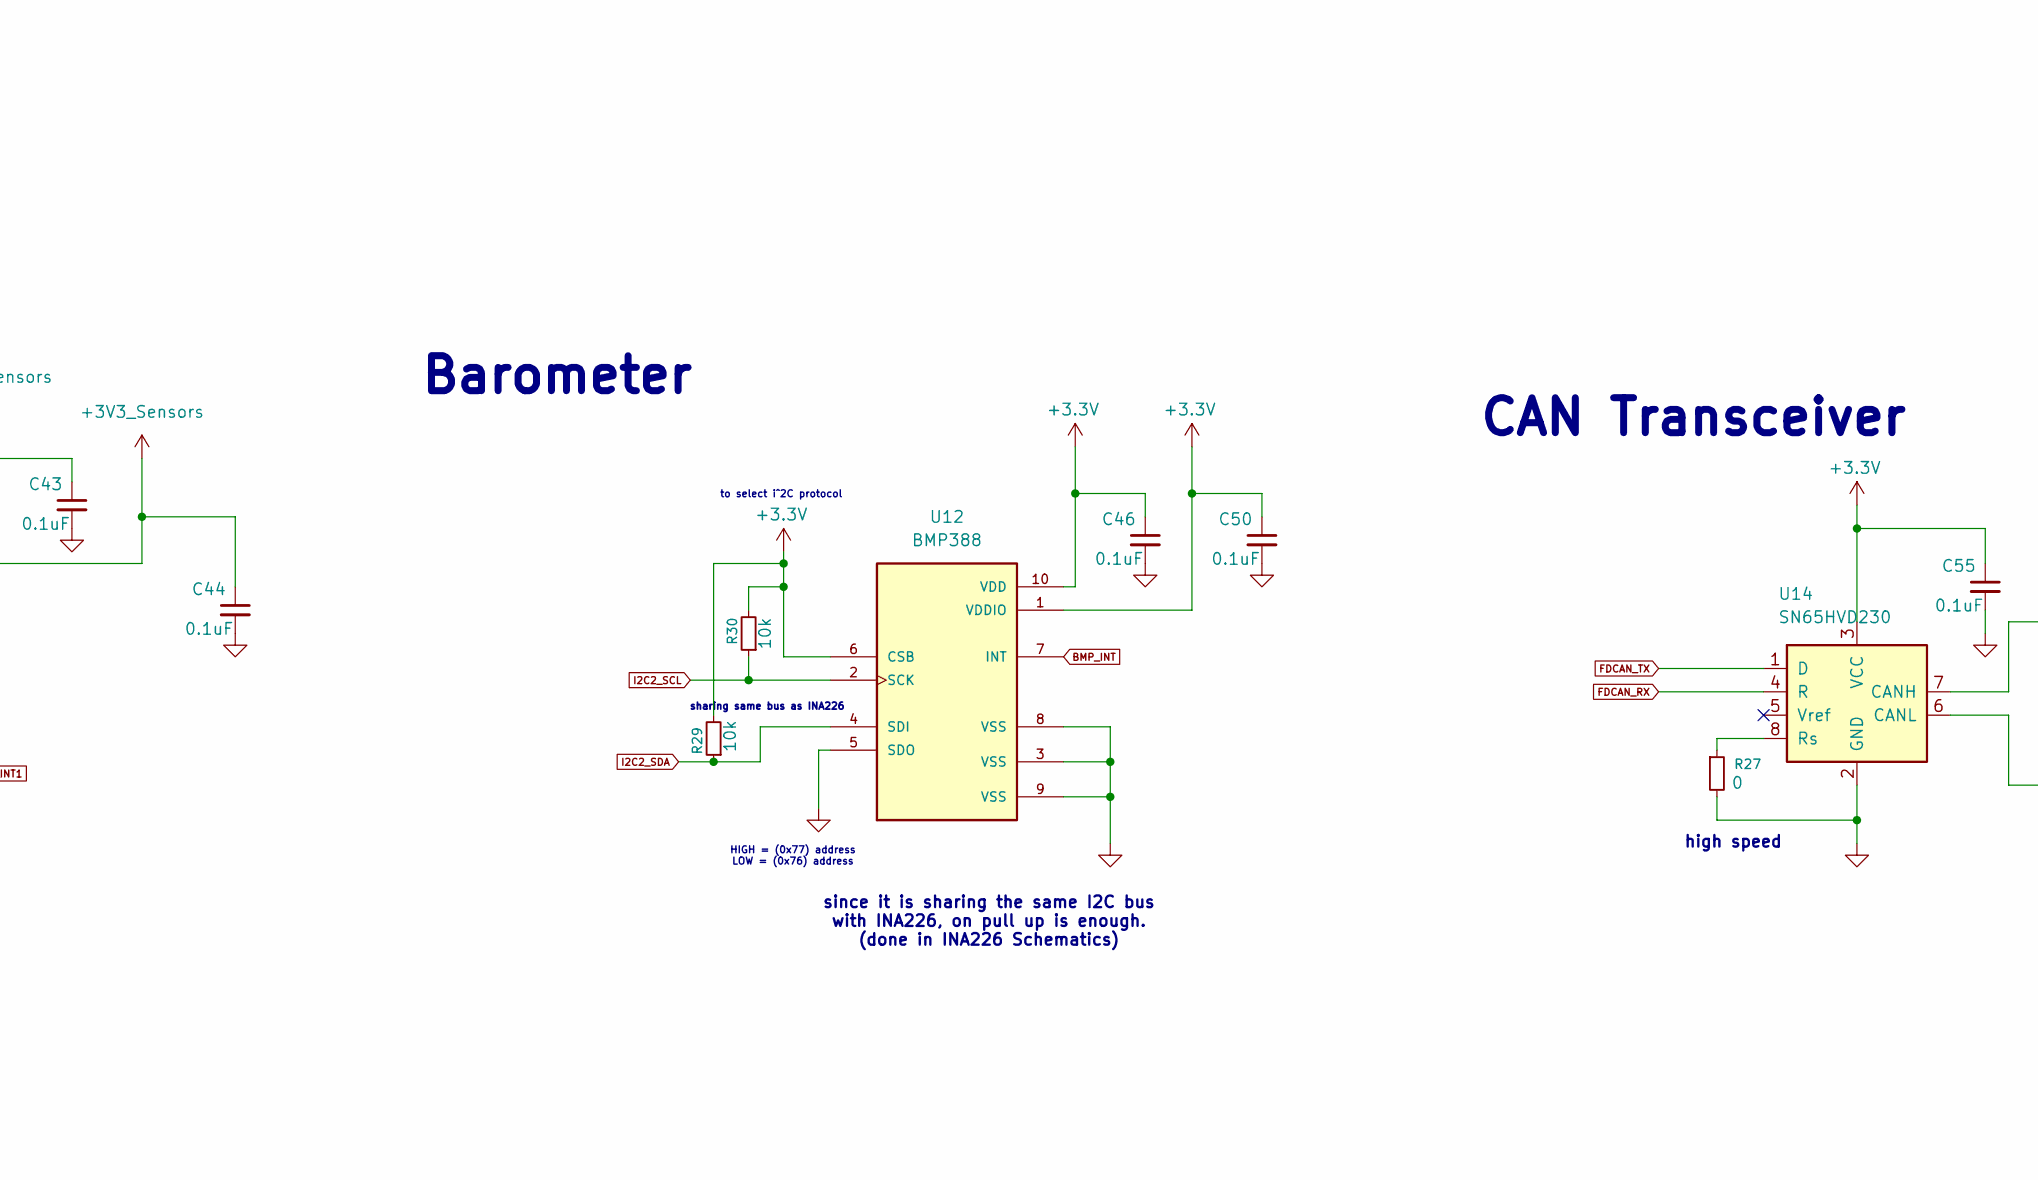
[picture p44: schematic Sensors.kicad_sch, part in row 1, column 2]

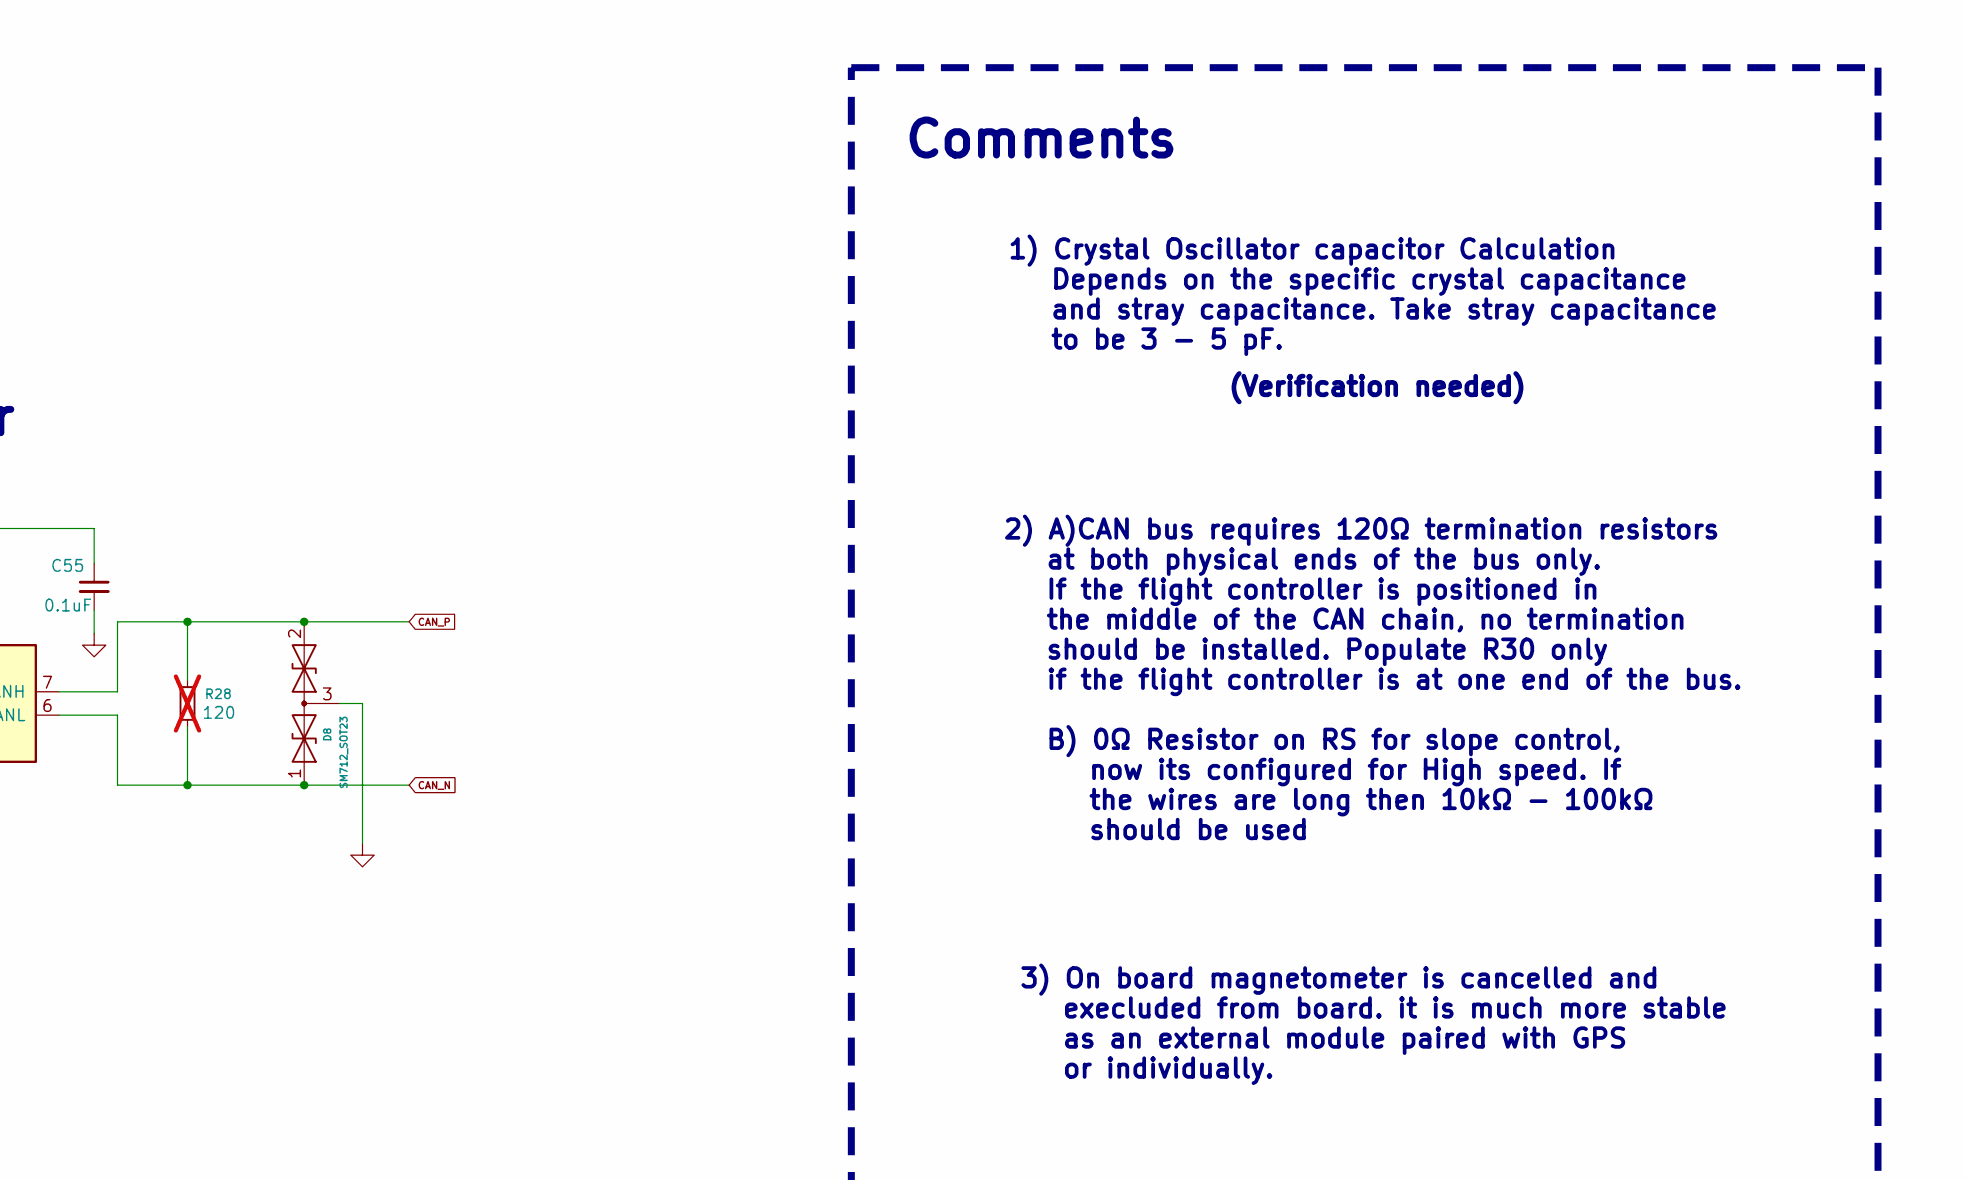
[picture p45: schematic Sensors.kicad_sch, part in row 1, column 3]

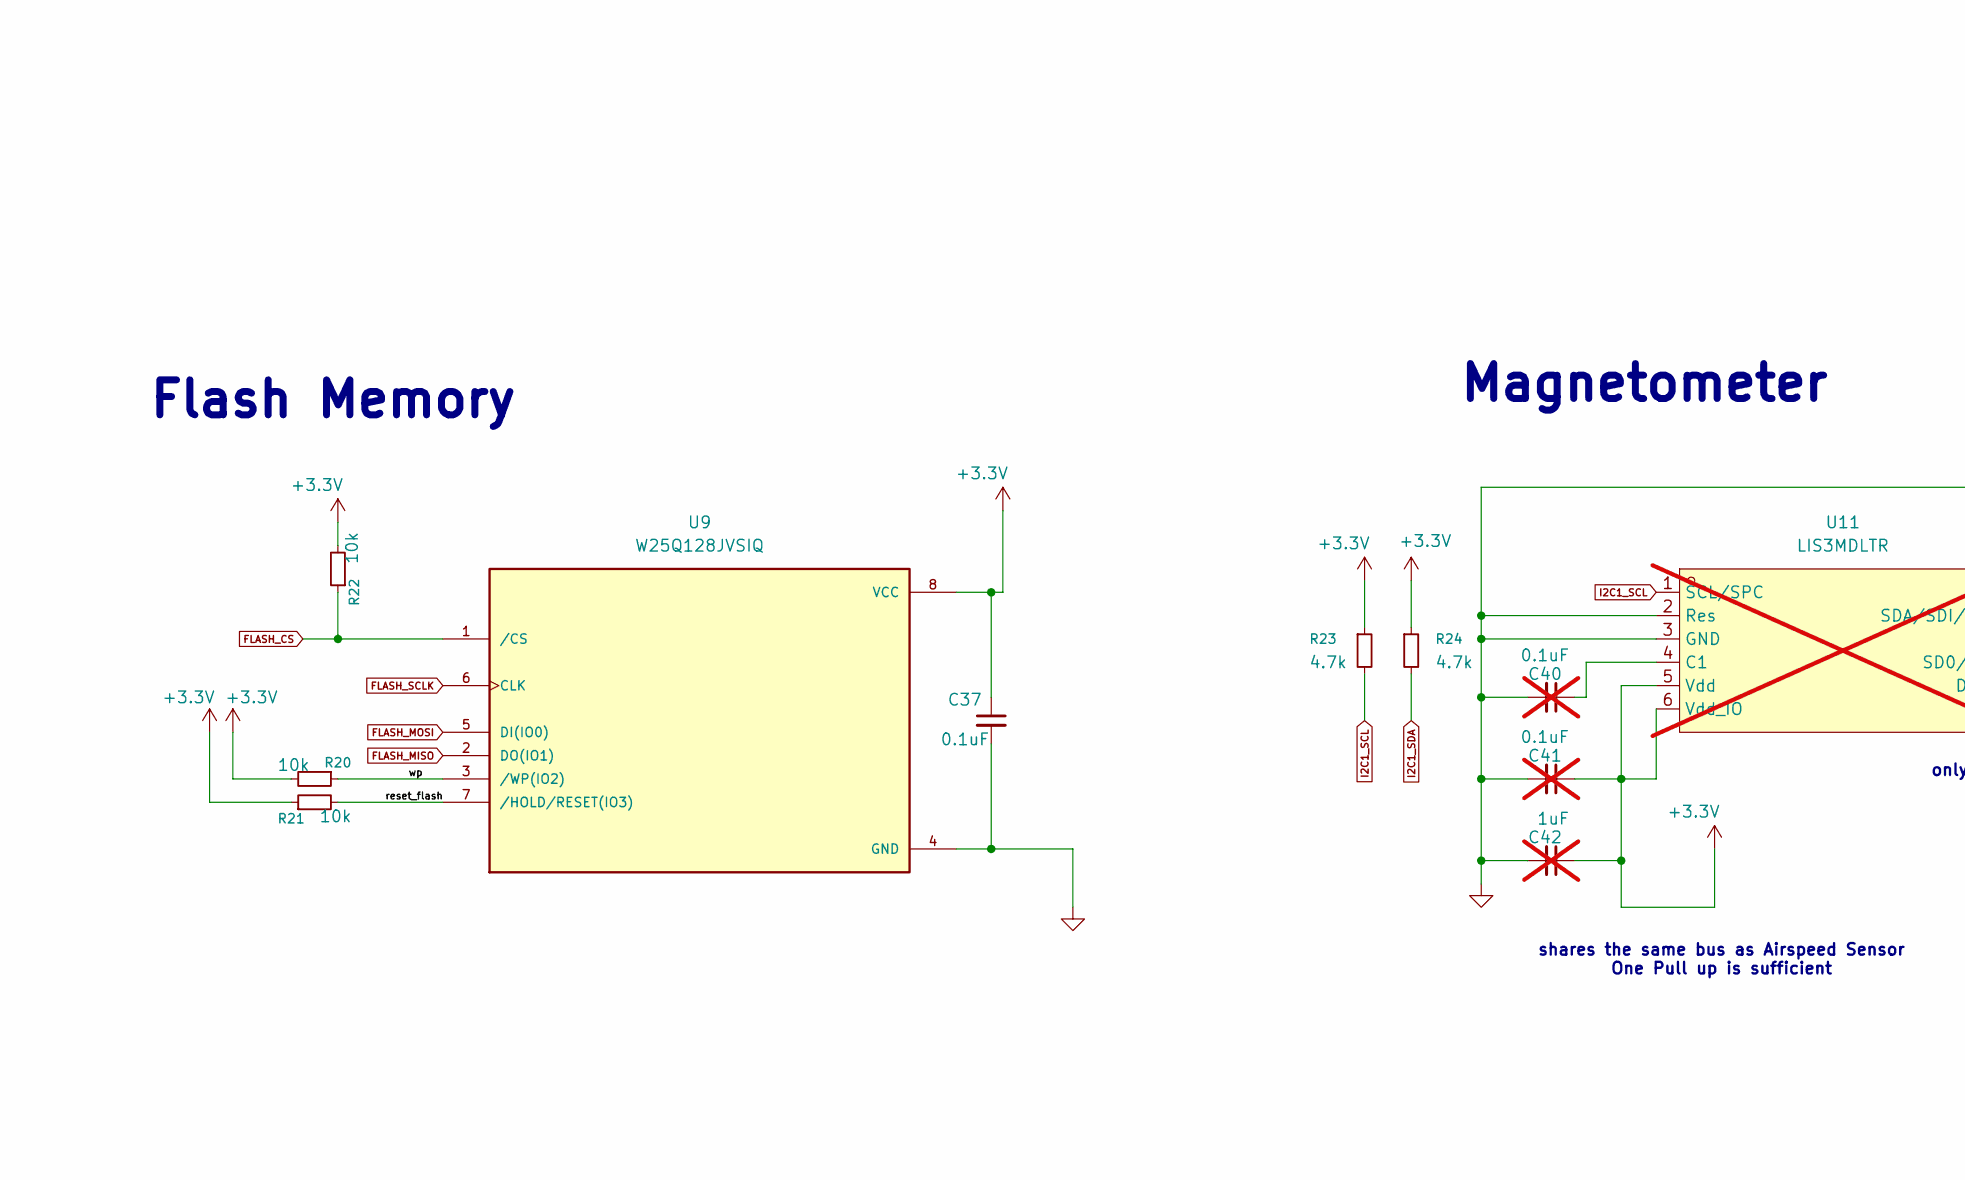
[picture p46: schematic Sensors.kicad_sch, part in row 2, column 1]

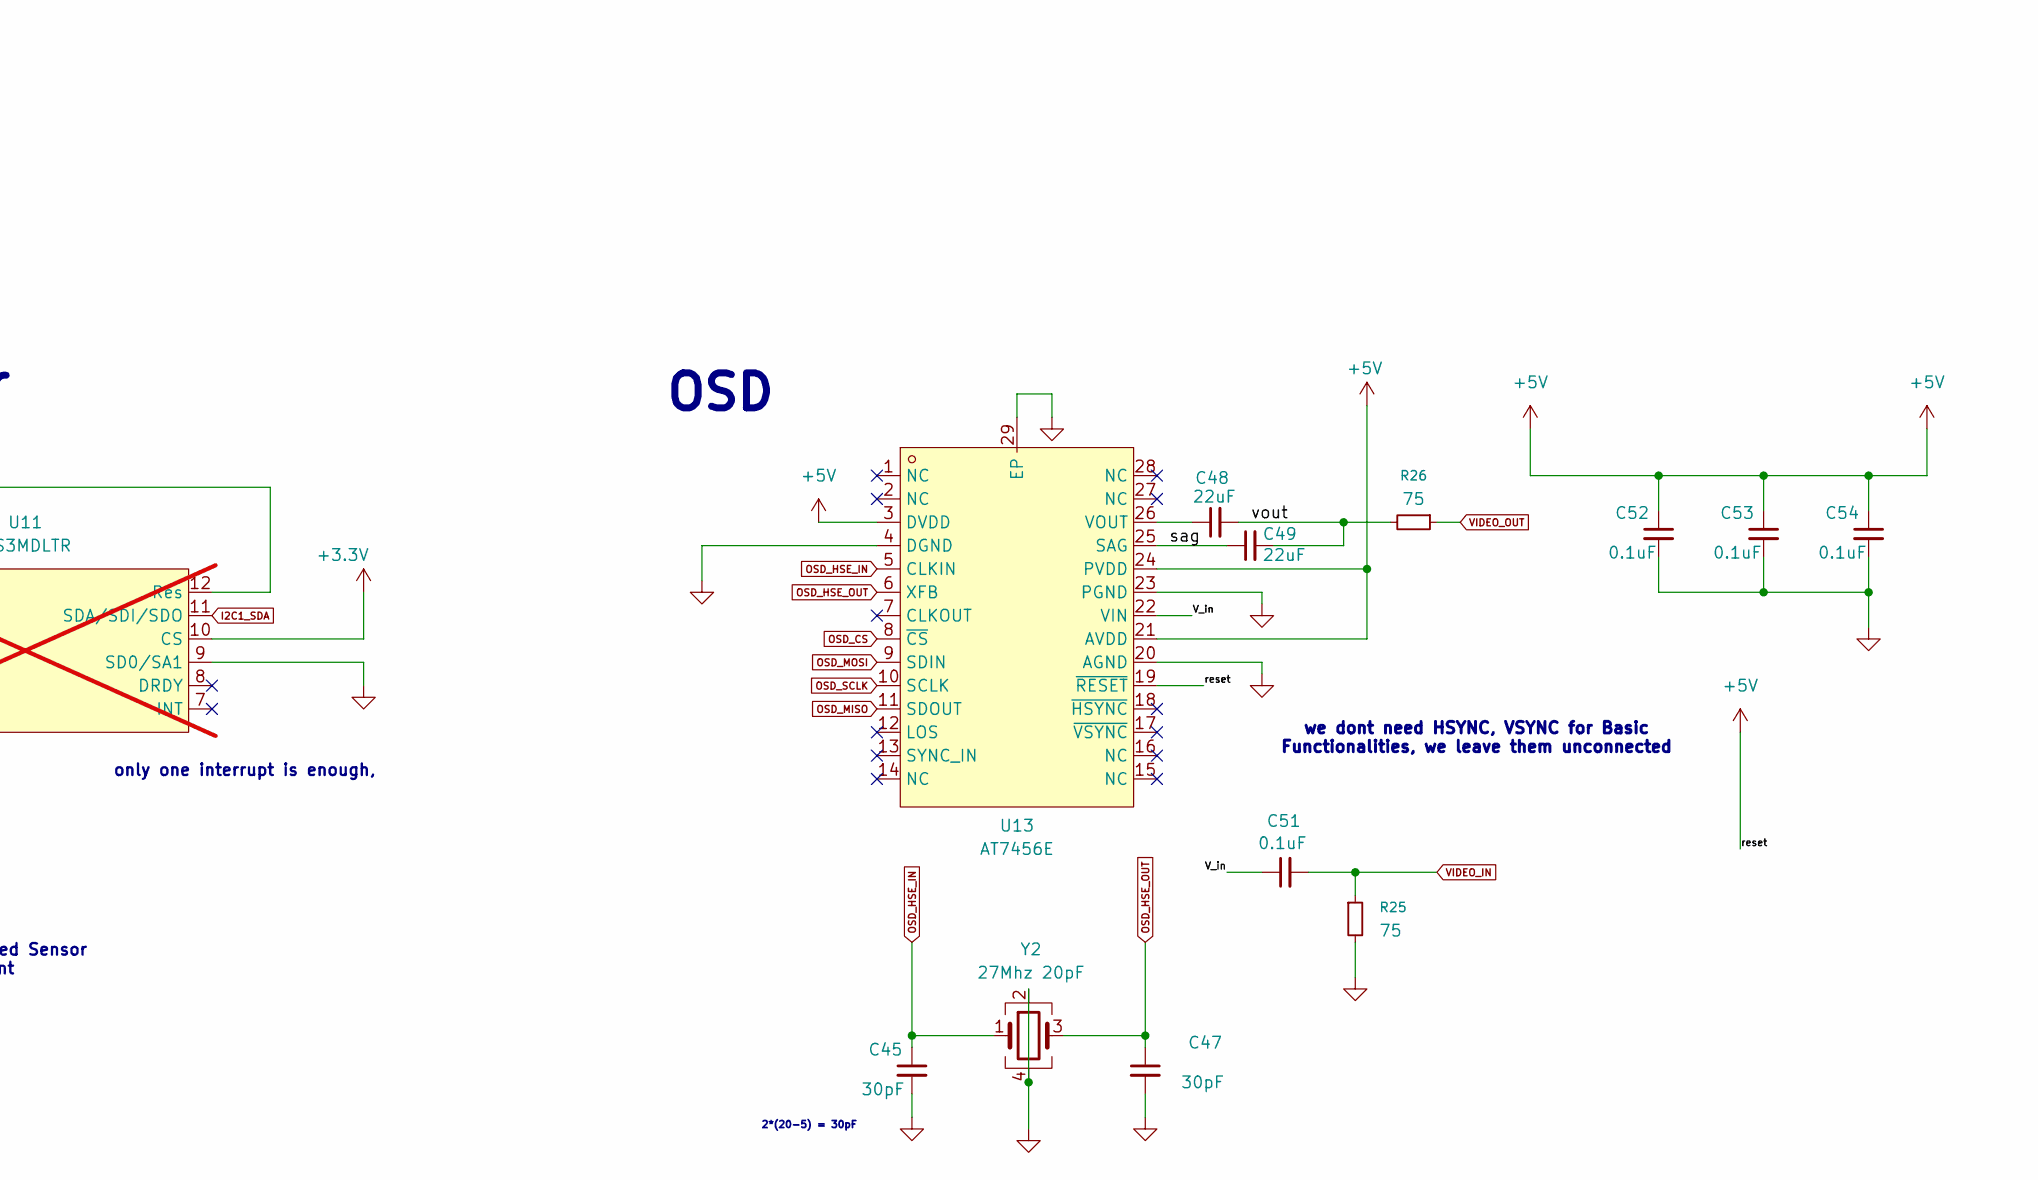
[picture p47: schematic Sensors.kicad_sch, part in row 2, column 2]

Parts:
C36, C37, C43, C44, C46, C50, C51, C52, C53, C54, C55: 0.1uF; C_0402_1005Metric
C38: 2.2uF; C_0603_1608Metric
C39: 10nF; C_0402_1005Metric
C40, C41: 0.1uF; C_0402_1005Metric; not fitted
C42: 1uF; C_0402_1005Metric; not fitted
C45, C47: 30pF; C_0402_1005Metric
C48, C49: 22uF; C_0603_1608Metric
D8: SM712_SOT23; SOT-23
R19, R27: 0; R_0402_1005Metric
R20, R21, R22, R29, R30: 10k; R_0402_1005Metric
R23, R24: 4.7k; R_0402_1005Metric
R25, R26: 75; R_0402_1005Metric
R28: 120; R_0402_1005Metric; not fitted
U8: ICM-42688-P; PQFN50P300X250X97-14N; PARTREV 1.2
U9: W25Q128JVSIQ; PARTREV I
U10: BMI270; XDCR_BMI270
U11: LIS3MDLTR; (mag)LGA-12_L2.0-W2.0-P0.50-BL; LCSC Part C478483; not fitted
U12: BMP388; PQFN50P200X200X80-10N; PARTREV 1.1
U13: AT7456E; LCSC Part C82351
U14: SN65HVD230; SOIC-8_3.9x4.9mm_P1.27mm
Y2: 27Mhz 20pF; Crystal_SMD_3225-4Pin_3.2x2.5mm

Connections:
+3.3V: C37.1, C41.1, C42.1, C46.1, C50.1, C55.1, R20.2, R21.1, R22.2, R23.1, R24.1, R29.2, R30.2, U9.8 (VCC), U11.5 (Vdd), U11.6 (Vdd_IO), U11.10 (CS), U12.1 (VDDIO), U12.6 (CSB), U12.10 (VDD), U14.3 (VCC); also elsewhere on the board
+3V3_Sensors: C36.1, C38.1, C39.1, C43.1, C44.1, U8.5 (VDDIO), U8.8 (VDD), U10.5 (VDDIO), U10.8 (VDD); also elsewhere on the board
+5V: C52.1, C53.1, C54.1, U13.3 (DVDD), U13.19 (~RESET), U13.21 (AVDD), U13.24 (PVDD); also elsewhere on the board
/Sensors and Peripherals/V_in: C51.1, U13.22 (VIN)
/Sensors and Peripherals/reset_flash: R21.2, U9.7 (/HOLD/RESET(IO3))
/Sensors and Peripherals/sag: C49.1, U13.25 (SAG)
/Sensors and Peripherals/vout: C48.2, C49.2, R26.2
/Sensors and Peripherals/wp: R20.1, U9.3 (/WP(IO2))
BMP_INT: U12.7 (INT); also elsewhere on the board
CAN_N: D8.1 (A1), R28.2, U14.6 (CANL); also elsewhere on the board
CAN_P: D8.2 (A2), R28.1, U14.7 (CANH); also elsewhere on the board
FDCAN_RX: U14.4 (R); also elsewhere on the board
FDCAN_TX: U14.1 (D); also elsewhere on the board
FLASH_CS: R22.1, U9.1 (/CS); also elsewhere on the board
FLASH_MISO: U9.2 (DO(IO1)); also elsewhere on the board
FLASH_MOSI: U9.5 (DI(IO0)); also elsewhere on the board
FLASH_SCLK: U9.6 (CLK); also elsewhere on the board
GND: C36.2, C37.2, C38.2, C39.2, C40.2, C41.2, C42.2, C43.2, C44.2, C45.2, C46.2, C47.2, C50.2, C52.2, C53.2, C54.2, C55.2, D8.3 (common), R19.1, R25.2, R27.2, U8.6 (GND), U8.7 (RESV_7), U8.11 (RESV_11), U9.4 (GND), U10.6 (GNDIO), U10.7 (GND), U11.2 (Res), U11.3 (GND), U11.9 (SD0/SA1), U11.12 (Res), U12.3 (VSS), U12.5 (SDO), U12.8 (VSS), U12.9 (VSS), U13.4 (DGND), U13.20 (AGND), U13.23 (PGND), U13.29 (EP), U14.2 (GND), Y2.2, Y2.4; also elsewhere on the board
I2C1_SCL: R23.2, U11.1 (SCL/SPC); also elsewhere on the board
I2C1_SDA: R24.2, U11.11 (SDA/SDI/SDO); also elsewhere on the board
I2C2_SCL: R30.1, U12.2 (SCK); also elsewhere on the board
I2C2_SDA: R29.1, U12.4 (SDI); also elsewhere on the board
IMU2_CS: U8.12 (AP_CS); also elsewhere on the board
IMU2_INT1: U8.4 (INT1/INT); also elsewhere on the board
IMU2_MISO: U8.1 (AP_SDO/AP_AD0); also elsewhere on the board
IMU2_MOSI: U8.14 (AP_SDA/AP_SDIO/AP_SDI); also elsewhere on the board
IMU2_SCLK: U8.13 (AP_SCL/AP_SCLK); also elsewhere on the board
IMU_CS: U10.12 (CSB); also elsewhere on the board
IMU_INT1: U10.4 (INT1); also elsewhere on the board
IMU_MISO: U10.1 (SDO); also elsewhere on the board
IMU_MOSI: U10.14 (SDX); also elsewhere on the board
IMU_SCLK: U10.13 (SCX); also elsewhere on the board
unnamed: C40.1, U11.4 (C1)
unnamed: R19.2, U8.9 (INT2/FSYNC/CLKIN)
unnamed: C48.1, U13.26 (VOUT)
unnamed: R27.1, U14.8 (Rs)
OSD_CS: U13.8 (~CS); also elsewhere on the board
OSD_HSE_IN: C45.1, U13.5 (CLKIN), Y2.1
OSD_HSE_OUT: C47.1, U13.6 (XFB), Y2.3
OSD_MISO: U13.11 (SDOUT); also elsewhere on the board
OSD_MOSI: U13.9 (SDIN); also elsewhere on the board
OSD_SCLK: U13.10 (SCLK); also elsewhere on the board
VIDEO_IN: C51.2, R25.1; also elsewhere on the board
VIDEO_OUT: R26.1; also elsewhere on the board

Notes on the sheet:
Debugging reasons, could be left unconnected
shares the same bus as Airspeed Sensor One Pull up is sufficient
high speed
we dont need HSYNC, VSYNC for Basic Functionalities, we leave them unconnected
sharing same bus as INA226
(Verification needed)
2*(20-5) = 30pF
1) Crystal Oscillator capacitor Calculation Depends on the specific crystal capacitance and stray capacitance. Take stray capacitance to be 3 - 5 pF.
HIGH = (0x77) address LOW = (0x76) address
to select i^2C protocol
only one interrupt is enough,
Magnetometer
2) A)CAN bus requires 120Ω termination resistors at both physical ends of the bus only. If the flight controller is positioned in the middle of the CAN chain, no termination should be installed. Populate R30 only if the flight controller is at one end of the bus. B) 0Ω Resistor on RS for slope cont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
Barometer
Flash Memory
3) On board magnetometer is cancelled and execluded from board. it is much more stable as an external module paired with GPS or individually.
OSD
Comments
Secondary IMU
Primary IMU
CAN Transceiver
Sensors and Peripherals
since it is sharing the same I2C bus with INA226, on pull up is enough. (done in INA226 Schematics)

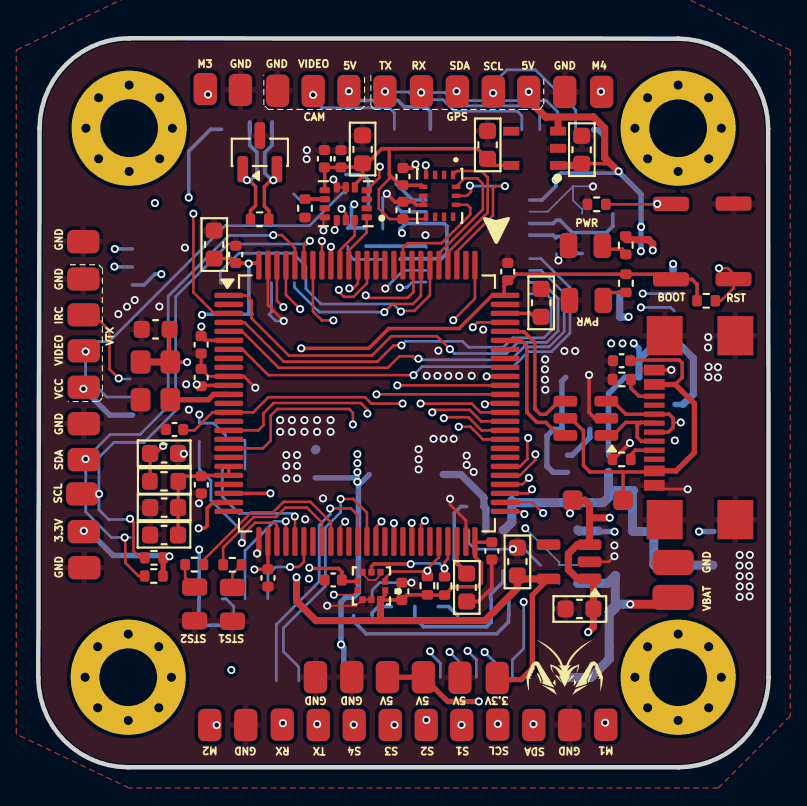
[picture p48: board Flight Controller.kicad_pcb from above]

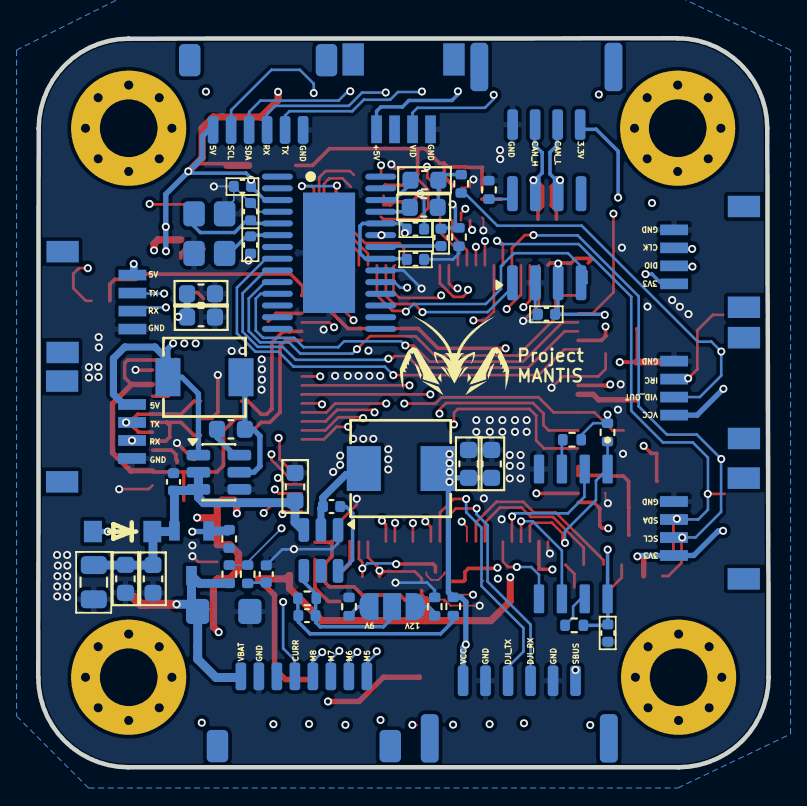
[picture p49: board Flight Controller.kicad_pcb from below]

Board: 6 copper layers, 40.6 x 40.5 mm, 163 parts (58 on the bottom side), 105 nets.
