salehali22/Flight-Controller/Test_Board/board.kicad_pcb

## KiCad design Test_Board/board.kicad_pcb (2026-01-14)

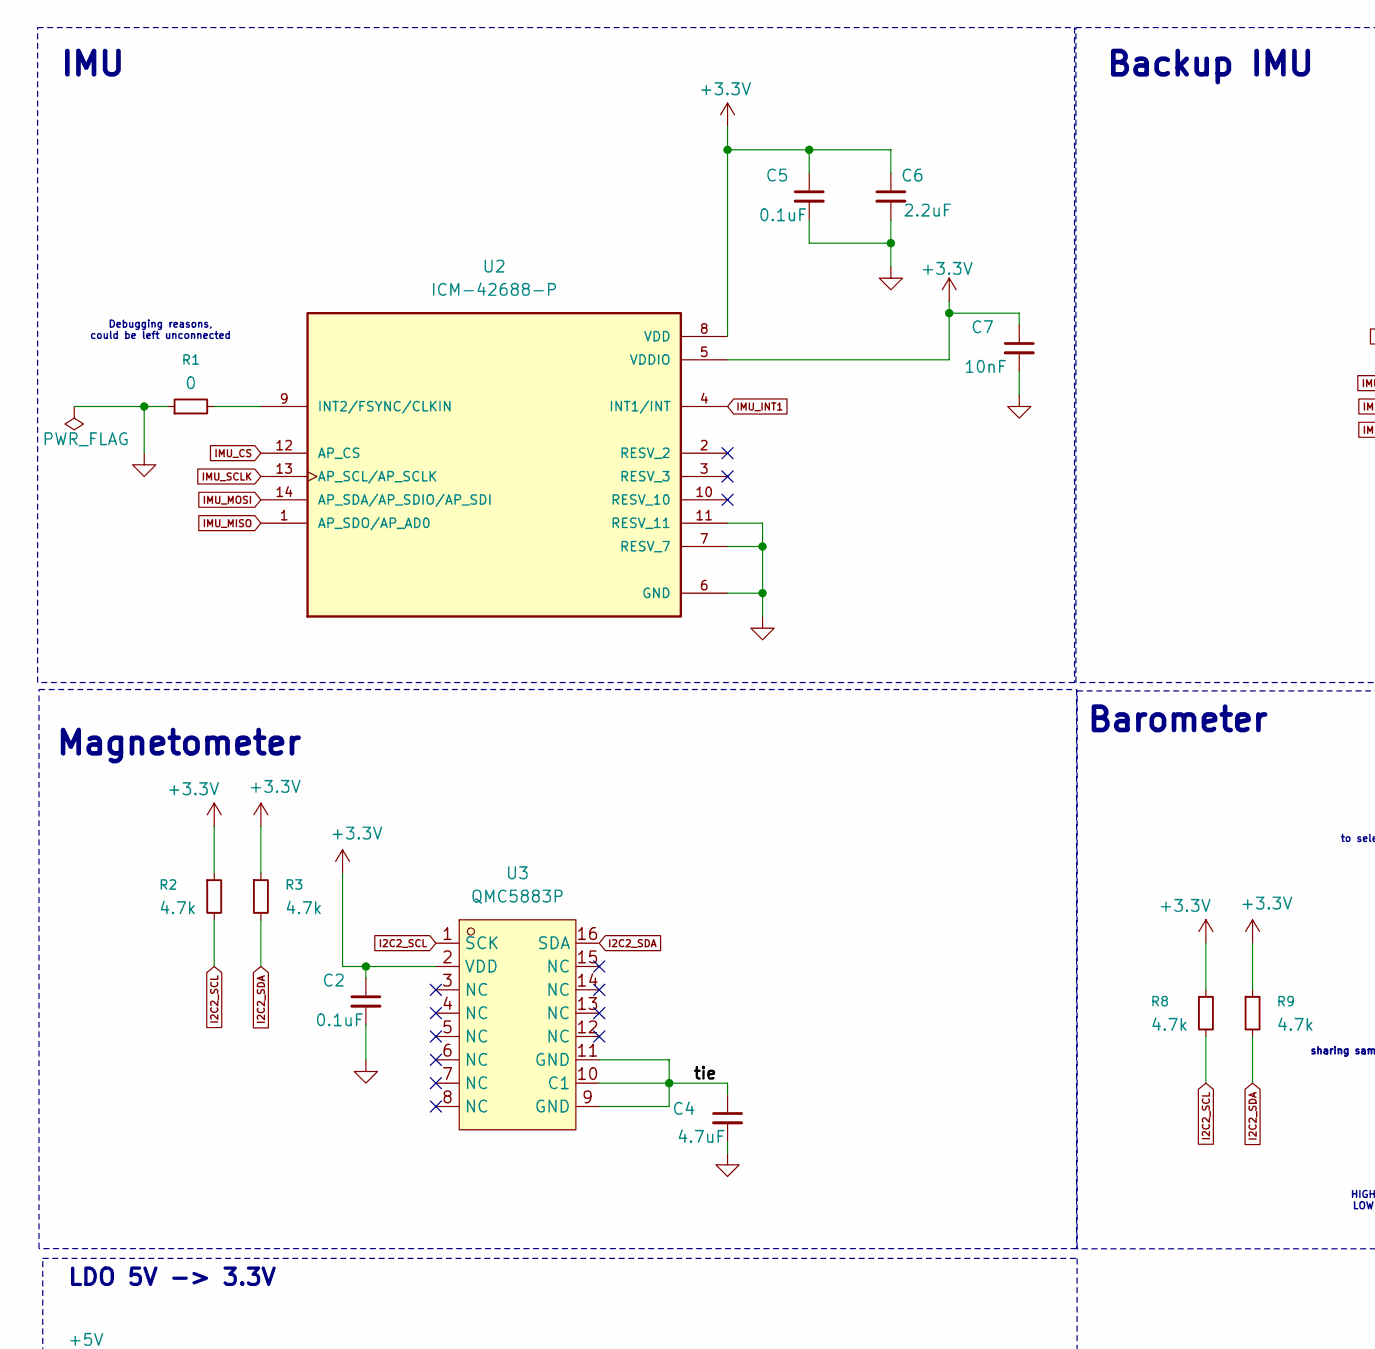
[picture p50: schematic board.kicad_sch, part in row 1, column 1]

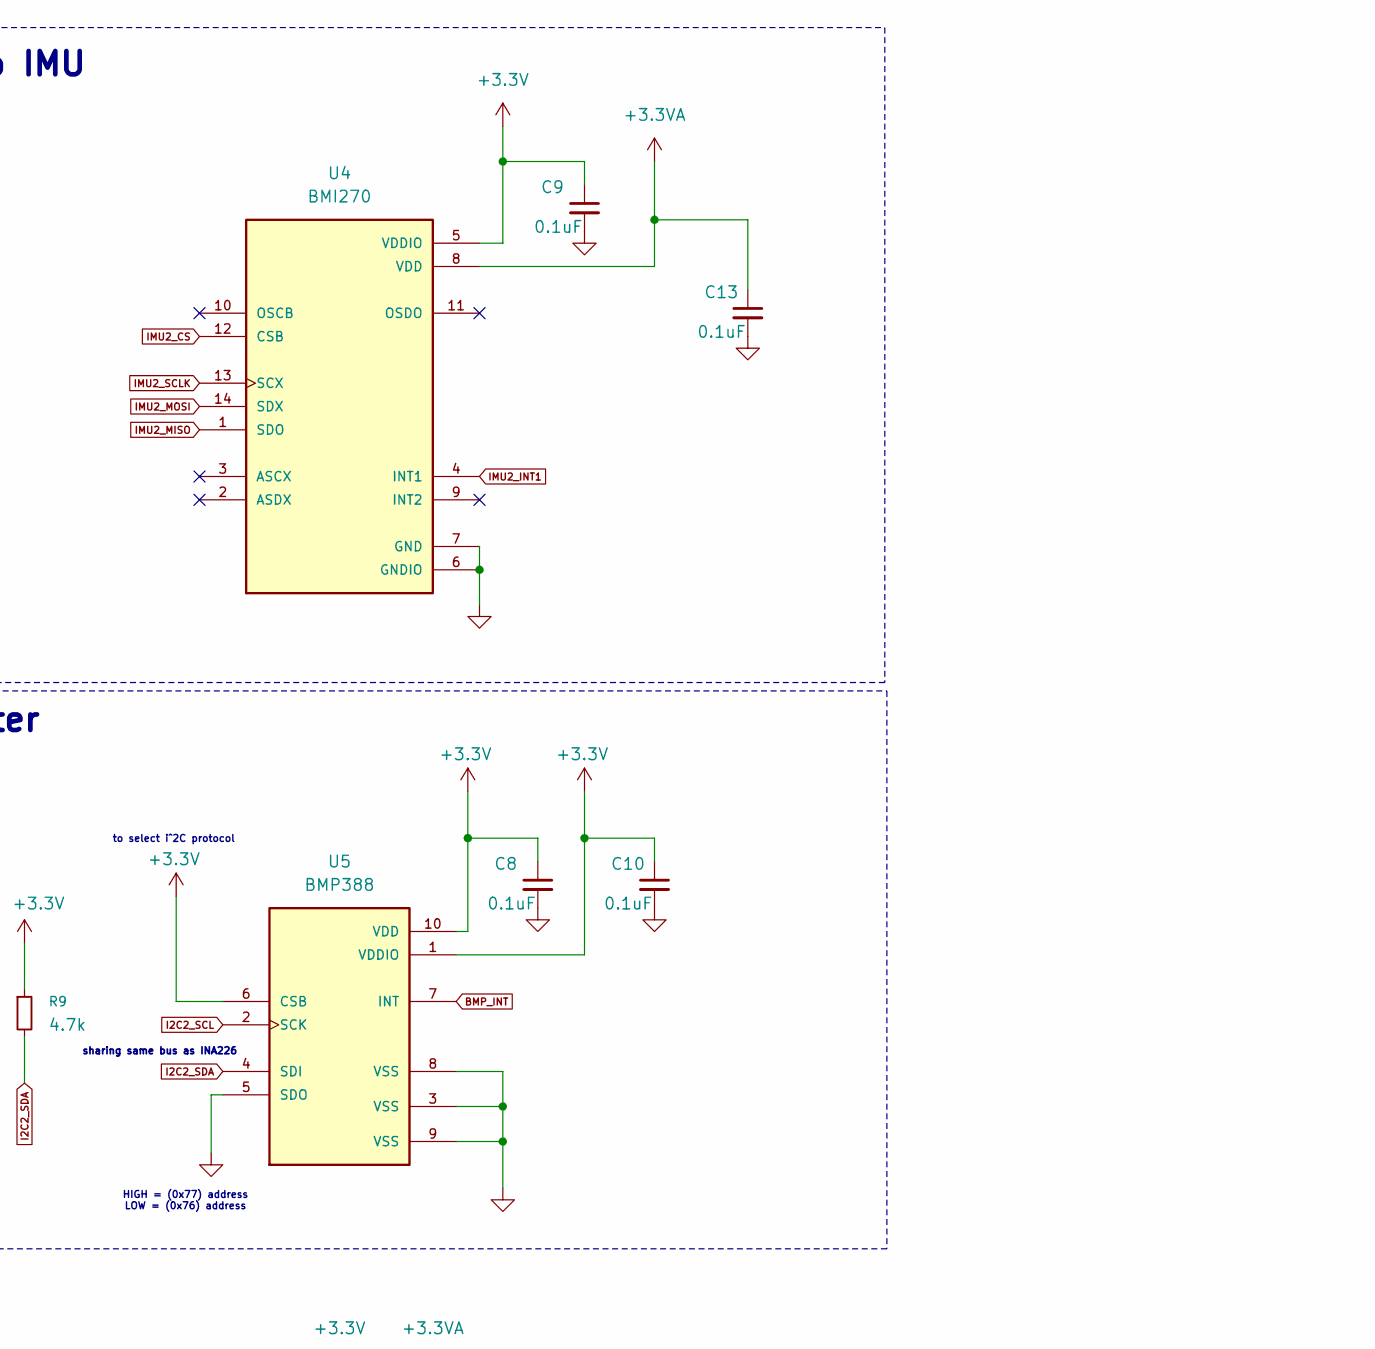
[picture p51: schematic board.kicad_sch, part in row 1, column 2]

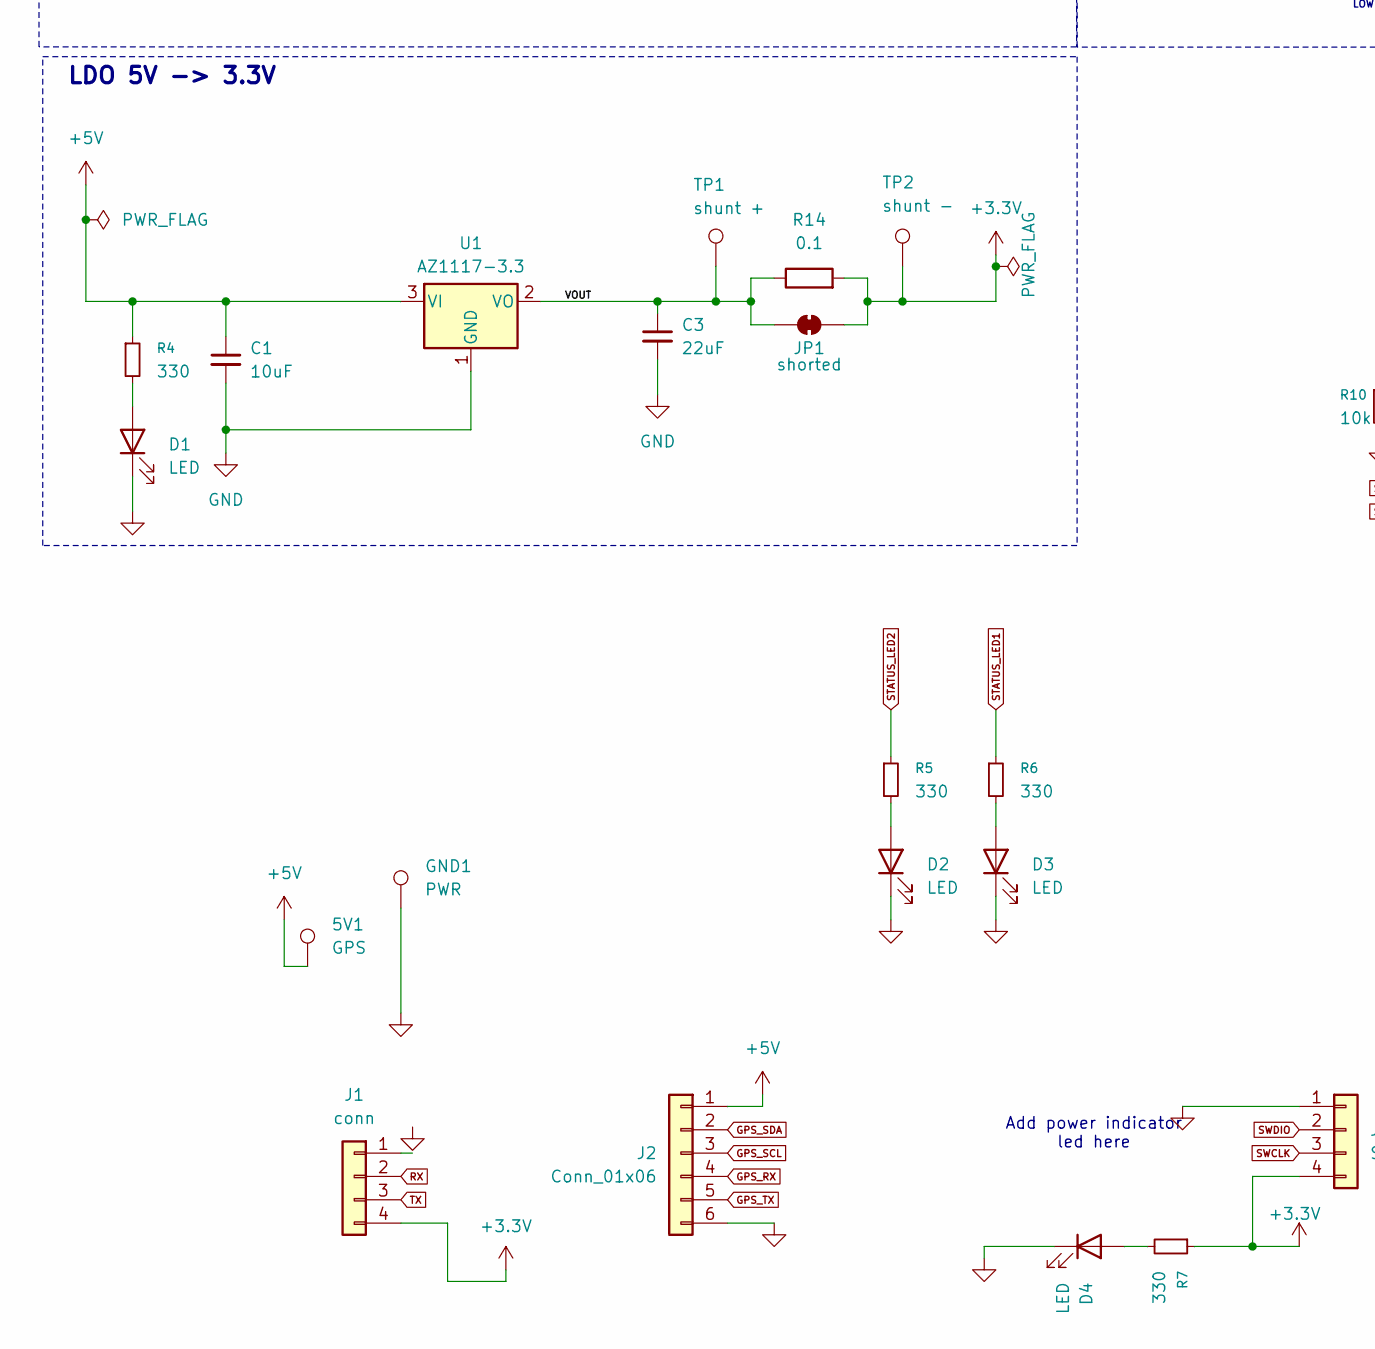
[picture p52: schematic board.kicad_sch, part in row 2, column 1]

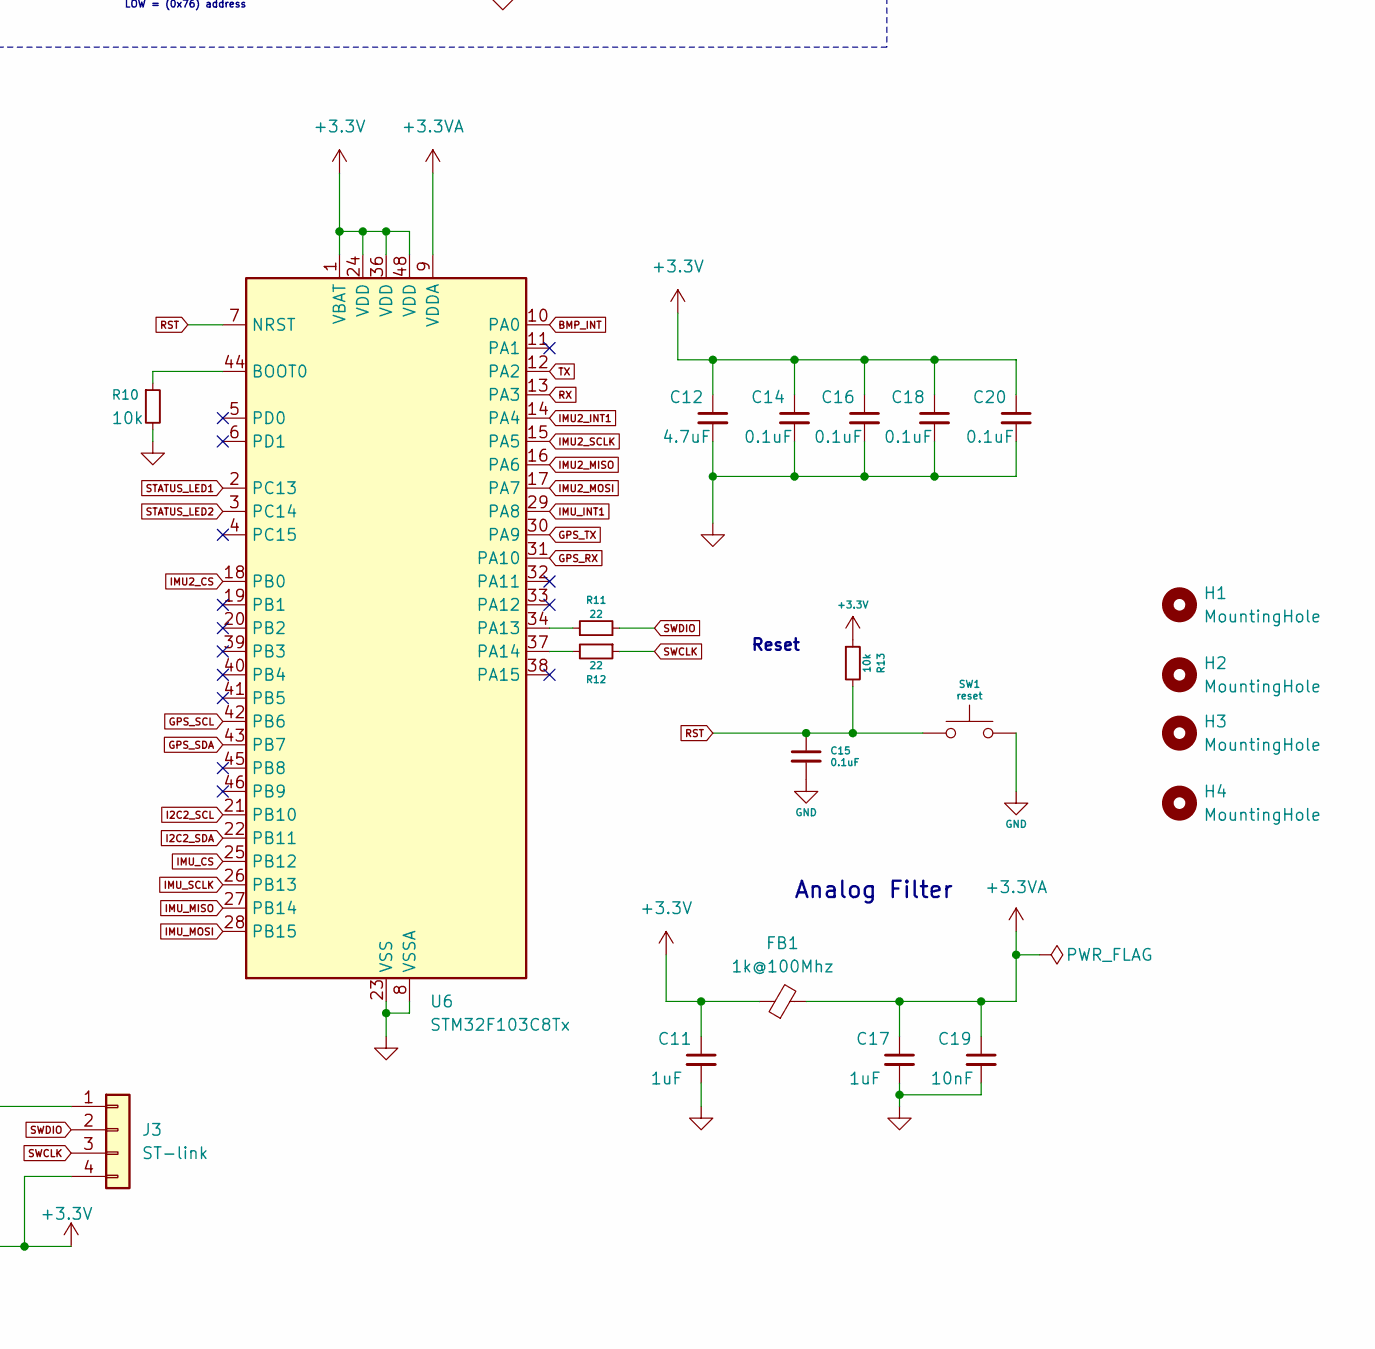
[picture p53: schematic board.kicad_sch, part in row 2, column 2]

Parts:
5V1: GPS; Solderpad
C1: 10uF; C_0603_1608Metric; JLCPCB PART# C19702
C2, C5, C8, C9, C10, C13, C14, C15, C16, C18, C20: 0.1uF; C_0603_1608Metric; JLCPCB PART# C14663
C3: 22uF; C_0603_1608Metric; JLCPCB PART# C86295
C4, C12: 4.7uF; C_0603_1608Metric; JLCPCB PART# C1705
C6: 2.2uF; C_0603_1608Metric; JLCPCB PART# C23630
C7, C19: 10nF; C_0603_1608Metric; JLCPCB PART# C100042
C11, C17: 1uF; C_0603_1608Metric; JLCPCB PART# C15849
D1, D2, D3, D4: LED; LED_0805_2012Metric; JLCPCB PART# C20608785
FB1: 1k@100Mhz; L_0603_1608Metric; JLCPCB PART# C44838
GND1: PWR; Solderpad
H1, H2, H3, H4: MountingHole; MountingHole_2.2mm_M2_Pad_Via
J1: conn; JST_EH_B4B-EH-A_1x04_P2.50mm_Vertical
J2: Conn_01x06; PinHeader_1x06_P2.54mm_Vertical
J3: ST-link; PinHeader_1x04_P2.54mm_Horizontal
JP1: shorted; SolderJumper-2_P1.3mm_Bridged_Pad1.0x1.5mm
R1: 0; R_0603_1608Metric; JLCPCB PART# C95177
R2, R3, R8, R9: 4.7k; R_0603_1608Metric; JLCPCB PART# C2904521
R4, R5, R6, R7: 330; R_0603_1608Metric; JLCPCB PART# C105881
R10, R13: 10k; R_0603_1608Metric; JLCPCB PART# C98220
R11, R12: 22; R_0603_1608Metric; JLCPCB PART# C107701
R14: 0.1; R_2512_6332Metric_Pad1.40x3.35mm_HandSolder
SW1: reset; SW_Push_SPST_NO_Alps_SKRK; JLCPCB PART# C115357
TP1: shunt +; Solderpad
TP2: shunt -; Solderpad
U1: AZ1117-3.3; SOT-223; JLCPCB PART# C108495
U2: ICM-42688-P; PQFN50P300X250X97-14N; PARTREV 1.2
U3: QMC5883P; LCSC Part C2847467
U4: BMI270; XDCR_BMI270; JLCPCB PART# C2836813
U5: BMP388; PQFN50P200X200X80-10N; PARTREV 1.1; JLCPCB PART# C779278
U6: STM32F103C8Tx; LQFP-48_7x7mm_P0.5mm; JLCPCB PART# C8734

Connections:
+3.3V: C2.1, C5.1, C6.1, C7.1, C8.1, C9.1, C10.1, C11.1, C12.1, C14.1, C16.1, C18.1, C20.1, FB1.1, J1.4, J3.4, JP1.2 (B), R2.1, R3.1, R7.1, R8.1, R9.1, R13.1, R14.2, TP2.1, U2.5 (VDDIO), U2.8 (VDD), U3.2 (VDD), U4.5 (VDDIO), U5.1 (VDDIO), U5.6 (CSB), U5.10 (VDD), U6.1 (VBAT), U6.24 (VDD), U6.36 (VDD), U6.48 (VDD)
+3.3VA: C13.1, C17.1, C19.1, FB1.2, U4.8 (VDD), U6.9 (VDDA)
+5V: 5V1.1, C1.1, J2.1, R4.1, U1.3 (VI)
/VOUT: C3.1, JP1.1 (A), R14.1, TP1.1, U1.2 (VO)
/tie: C4.1, U3.9 (GND), U3.10 (C1), U3.11 (GND)
BMP_INT: U5.7 (INT), U6.10 (PA0)
GND: C1.2, C2.2, C3.2, C4.2, C5.2, C6.2, C7.2, C8.2, C9.2, C10.2, C11.2, C12.2, C13.2, C14.2, C15.2, C16.2, C17.2, C18.2, C19.2, C20.2, D1.1 (K), D2.1 (K), D3.1 (K), D4.1 (K), GND1.1, J2.6, J3.1, R1.1, R10.2, SW1.2, U1.1 (GND), U2.6 (GND), U2.7 (RESV_7), U2.11 (RESV_11), U4.6 (GNDIO), U4.7 (GND), U5.3 (VSS), U5.5 (SDO), U5.8 (VSS), U5.9 (VSS), U6.8 (VSSA), U6.23 (VSS), U6.35 (VSS), U6.47 (VSS)
GPS_RX: J2.4, U6.31 (PA10)
GPS_SCL: J2.3, U6.42 (PB6)
GPS_SDA: J2.2, U6.43 (PB7)
GPS_TX: J2.5, U6.30 (PA9)
I2C2_SCL: R2.2, R8.2, U3.1 (SCK), U5.2 (SCK), U6.21 (PB10)
I2C2_SDA: R3.2, R9.2, U3.16 (SDA), U5.4 (SDI), U6.22 (PB11)
IMU2_CS: U4.12 (CSB), U6.18 (PB0)
IMU2_INT1: U4.4 (INT1), U6.14 (PA4)
IMU2_MISO: U4.1 (SDO), U6.16 (PA6)
IMU2_MOSI: U4.14 (SDX), U6.17 (PA7)
IMU2_SCLK: U4.13 (SCX), U6.15 (PA5)
IMU_CS: U2.12 (AP_CS), U6.25 (PB12)
IMU_INT1: U2.4 (INT1/INT), U6.29 (PA8)
IMU_MISO: U2.1 (AP_SDO/AP_AD0), U6.27 (PB14)
IMU_MOSI: U2.14 (AP_SDA/AP_SDIO/AP_SDI), U6.28 (PB15)
IMU_SCLK: U2.13 (AP_SCL/AP_SCLK), U6.26 (PB13)
unnamed: D1.2 (A), R4.2
unnamed: D2.2 (A), R5.2
unnamed: D3.2 (A), R6.2
unnamed: D4.2 (A), R7.2
unnamed: R1.2, U2.9 (INT2/FSYNC/CLKIN)
unnamed: R10.1, U6.44 (BOOT0)
unnamed: R11.1, U6.34 (PA13)
unnamed: R12.2, U6.37 (PA14)
RST: C15.1, R13.2, SW1.1, U6.7 (NRST)
RX: J1.2, U6.13 (PA3)
STATUS_LED1: R6.1, U6.2 (PC13)
STATUS_LED2: R5.1, U6.3 (PC14)
SWCLK: J3.3, R12.1
SWDIO: J3.2, R11.2
TX: J1.3, U6.12 (PA2)

Notes on the sheet:
Analog Filter
Add power indicator led here
Backup IMU
Debugging reasons, could be left unconnected
to select i^2C protocol
Reset
Barometer
LDO 5V -> 3.3V
IMU
HIGH = (0x77) address LOW = (0x76) address
Magnetometer
sharing same bus as INA226

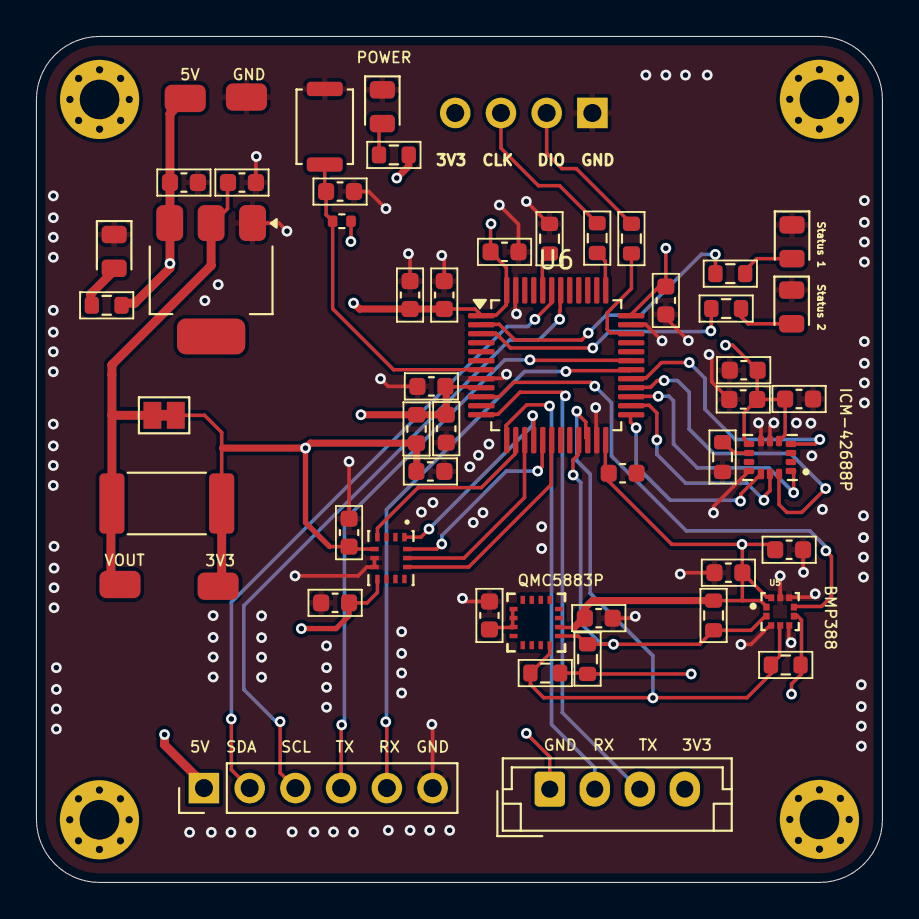
[picture p54: board board.kicad_pcb from above]

Board: 4 copper layers, 47.0 x 47.0 mm, 58 parts (1 on the bottom side), 38 nets.
