salehali22/Flight-Controller/firmware/Flight_Controller_h7/Flight_Controller_H7.ioc

Mcu.UserName=STM32H743VITx
PA0.Signal=UART4_TX
PA1.GPIO_Label=DJI_SBUS
PA1.Signal=UART4_RX
PA11.Signal=USB_OTG_FS_DM
PA12.Signal=USB_OTG_FS_DP
PA2.GPIO_Label=VTX_TX
PA2.Signal=USART2_TX
PA3.GPIO_Label=VTX_RX
PA3.Signal=USART2_RX
PA4.GPIO_Label=FLASH_CS
PA4.Signal=GPIO_Output
PA5.GPIO_Label=FLASH_SCK
PA5.Signal=SPI1_SCK
PA6.GPIO_Label=FLASH_MISO
PA6.Signal=SPI1_MISO
PA7.GPIO_Label=FLASH_MOSI
PA7.Signal=SPI1_MOSI
PB0.GPIO_Label=STATUS_LED_1
PB0.Signal=GPIO_Output
PB1.GPIO_Label=BMP_INT1
PB1.Signal=GPXTI1
PB10.Signal=I2C2_SCL
PB11.Signal=I2C2_SDA
PB12.GPIO_Label=TELEMETRY_RX
PB12.Signal=UART5_RX
PB13.GPIO_Label=TELEMETRY_TX
PB13.Signal=UART5_TX
PB14.GPIO_Label=Expansion_TX
PB14.Signal=USART1_TX
PB15.GPIO_Label=Expansion_RX
PB15.Signal=USART1_RX
PB5.GPIO_Label=IMU2_MOSI
PB5.Signal=SPI6_MOSI
PB6.GPIO_Label=GPS_SCL
PB6.Signal=I2C4_SCL
PB7.GPIO_Label=GPS_SDA
PB7.Signal=I2C4_SDA
PB8.Signal=I2C1_SCL
PB9.Signal=I2C1_SDA
PC1.GPIO_Label=ADC_VOLTAGE
PC1.Signal=ADCx_INP11
PC10.GPIO_Label=IMU_SCLK
PC10.Signal=SPI3_SCK
PC11.GPIO_Label=IMU_MISO
PC11.Signal=SPI3_MISO
PC12.GPIO_Label=IMU_MOSI
PC12.Signal=SPI3_MOSI
PC13.GPIO_Label=OSD_CS
PC13.Signal=GPIO_Output
PC3_C.GPIO_Label=ADC_CURR
PC3_C.Signal=ADC3_INP1
PC5.GPIO_Label=STATUS_LED_2
PC5.Signal=GPIO_Output
PC6.GPIO_Label=M1
PC6.Signal=S_TIM8_CH1
PC7.GPIO_Label=M2
PC7.Signal=S_TIM8_CH2
PC8.GPIO_Label=M3
PC8.Signal=S_TIM8_CH3
PC9.GPIO_Label=M4
PC9.Signal=S_TIM8_CH4
PD0.Signal=FDCAN1_RX
PD1.Signal=FDCAN1_TX
PD12.GPIO_Label=S1
PD12.Signal=S_TIM4_CH1
PD13.GPIO_Label=S2
PD13.Signal=S_TIM4_CH2
PD14.GPIO_Label=S3
PD14.Signal=S_TIM4_CH3
PD15.GPIO_Label=S4
PD15.Signal=S_TIM4_CH4
PD2.GPIO_Label=IMU_INT1
PD2.Signal=GPXTI2
PD3.GPIO_Label=IMU_CS
PD3.Signal=GPIO_Output
PD7.GPIO_Label=IMU2_CS
PD7.Signal=GPIO_Output
PD8.GPIO_Label=WIFI/RC_TX
PD8.Signal=USART3_TX
PD9.GPIO_Label=WIFI/RC_RX
PD9.Signal=USART3_RX
PE0.GPIO_Label=GPS_RX
PE0.Signal=UART8_RX
PE1.GPIO_Label=GPS_TX
PE1.Signal=UART8_TX
PE11.GPIO_Label=M6
PE11.Signal=S_TIM1_CH2
PE13.GPIO_Label=M7
PE13.Signal=S_TIM1_CH3
PE14.GPIO_Label=M8
PE14.Signal=S_TIM1_CH4
PE2.GPIO_Label=OSD_SCK
PE2.Signal=SPI4_SCK
PE3.GPIO_Label=OSD_CS
PE3.Signal=GPIO_Output
PE4.GPIO_Label=IMU2_INT
PE4.Signal=GPXTI4
PE5.GPIO_Label=OSD_MISO
PE5.Signal=SPI4_MISO
PE6.GPIO_Label=OSD_MOSI
PE6.Signal=SPI4_MOSI
PE7.GPIO_Label=DJI_RX
PE7.Signal=UART7_RX
PE8.GPIO_Label=DJI_TX
PE8.Signal=UART7_TX
PE9.GPIO_Label=M5
PE9.Signal=S_TIM1_CH1
