salehali22/Flight-Controller/firmware/Flight_Controller_h7/Core/Inc/main.h

#define OSD_SCK_Pin GPIO_PIN_2
#define OSD_SCK_GPIO_Port GPIOE
#define OSD_CS_Pin GPIO_PIN_3
#define OSD_CS_GPIO_Port GPIOE
#define IMU2_INT_Pin GPIO_PIN_4
#define IMU2_INT_GPIO_Port GPIOE
#define OSD_MISO_Pin GPIO_PIN_5
#define OSD_MISO_GPIO_Port GPIOE
#define OSD_MOSI_Pin GPIO_PIN_6
#define OSD_MOSI_GPIO_Port GPIOE
#define OSD_CSC13_Pin GPIO_PIN_13
#define OSD_CSC13_GPIO_Port GPIOC
#define ADC_VOLTAGE_Pin GPIO_PIN_1
#define ADC_VOLTAGE_GPIO_Port GPIOC
#define ADC_CURR_Pin GPIO_PIN_3
#define ADC_CURR_GPIO_Port GPIOC
#define DJI_SBUS_Pin GPIO_PIN_1
#define DJI_SBUS_GPIO_Port GPIOA
#define VTX_TX_Pin GPIO_PIN_2
#define VTX_TX_GPIO_Port GPIOA
#define VTX_RX_Pin GPIO_PIN_3
#define VTX_RX_GPIO_Port GPIOA
#define FLASH_CS_Pin GPIO_PIN_4
#define FLASH_CS_GPIO_Port GPIOA
#define FLASH_SCK_Pin GPIO_PIN_5
#define FLASH_SCK_GPIO_Port GPIOA
#define FLASH_MISO_Pin GPIO_PIN_6
#define FLASH_MISO_GPIO_Port GPIOA
#define FLASH_MOSI_Pin GPIO_PIN_7
#define FLASH_MOSI_GPIO_Port GPIOA
#define STATUS_LED_2_Pin GPIO_PIN_5
#define STATUS_LED_2_GPIO_Port GPIOC
#define STATUS_LED_1_Pin GPIO_PIN_0
#define STATUS_LED_1_GPIO_Port GPIOB
#define BMP_INT1_Pin GPIO_PIN_1
#define BMP_INT1_GPIO_Port GPIOB
#define DJI_RX_Pin GPIO_PIN_7
#define DJI_RX_GPIO_Port GPIOE
#define DJI_TX_Pin GPIO_PIN_8
#define DJI_TX_GPIO_Port GPIOE
#define M5_Pin GPIO_PIN_9
#define M5_GPIO_Port GPIOE
#define M6_Pin GPIO_PIN_11
#define M6_GPIO_Port GPIOE
#define M7_Pin GPIO_PIN_13
#define M7_GPIO_Port GPIOE
#define M8_Pin GPIO_PIN_14
#define M8_GPIO_Port GPIOE
#define TELEMETRY_RX_Pin GPIO_PIN_12
#define TELEMETRY_RX_GPIO_Port GPIOB
#define TELEMETRY_TX_Pin GPIO_PIN_13
#define TELEMETRY_TX_GPIO_Port GPIOB
#define Expansion_TX_Pin GPIO_PIN_14
#define Expansion_TX_GPIO_Port GPIOB
#define Expansion_RX_Pin GPIO_PIN_15
#define Expansion_RX_GPIO_Port GPIOB
#define WIFI_RC_TX_Pin GPIO_PIN_8
#define WIFI_RC_TX_GPIO_Port GPIOD
#define WIFI_RC_RX_Pin GPIO_PIN_9
#define WIFI_RC_RX_GPIO_Port GPIOD
#define S1_Pin GPIO_PIN_12
#define S1_GPIO_Port GPIOD
#define S2_Pin GPIO_PIN_13
#define S2_GPIO_Port GPIOD
#define S3_Pin GPIO_PIN_14
#define S3_GPIO_Port GPIOD
#define S4_Pin GPIO_PIN_15
#define S4_GPIO_Port GPIOD
#define M1_Pin GPIO_PIN_6
#define M1_GPIO_Port GPIOC
#define M2_Pin GPIO_PIN_7
#define M2_GPIO_Port GPIOC
#define M3_Pin GPIO_PIN_8
#define M3_GPIO_Port GPIOC
#define M4_Pin GPIO_PIN_9
#define M4_GPIO_Port GPIOC
#define IMU_SCLK_Pin GPIO_PIN_10
#define IMU_SCLK_GPIO_Port GPIOC
#define IMU_MISO_Pin GPIO_PIN_11
#define IMU_MISO_GPIO_Port GPIOC
#define IMU_MOSI_Pin GPIO_PIN_12
#define IMU_MOSI_GPIO_Port GPIOC
#define IMU_INT1_Pin GPIO_PIN_2
#define IMU_INT1_GPIO_Port GPIOD
#define IMU_CS_Pin GPIO_PIN_3
#define IMU_CS_GPIO_Port GPIOD
#define IMU2_CS_Pin GPIO_PIN_7
#define IMU2_CS_GPIO_Port GPIOD
#define IMU2_SCLK_Pin GPIO_PIN_3
#define IMU2_SCLK_GPIO_Port GPIOB
#define IMU2_MISO_Pin GPIO_PIN_4
#define IMU2_MISO_GPIO_Port GPIOB
#define IMU2_MOSI_Pin GPIO_PIN_5
#define IMU2_MOSI_GPIO_Port GPIOB
#define GPS_SCL_Pin GPIO_PIN_6
#define GPS_SCL_GPIO_Port GPIOB
#define GPS_SDA_Pin GPIO_PIN_7
#define GPS_SDA_GPIO_Port GPIOB
#define GPS_RX_Pin GPIO_PIN_0
#define GPS_RX_GPIO_Port GPIOE
#define GPS_TX_Pin GPIO_PIN_1
#define GPS_TX_GPIO_Port GPIOE
