salehali22/Flight-Controller/Test_Board/firmware/Core/Src/main.c

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
/* Includes ------------------------------------------------------------------*/
#include "main.h"
#include "icm42688p.h"
#include <math.h>

/* ============== Configuration ============== */
#define LPF_ALPHA           0.1f
#define CAL_SAMPLES         200
#define COMP_FILTER_ALPHA   0.98f   // Trust gyro 98%, accel 2%
#define RAD_TO_DEG          57.2957795f
#define DEG_TO_RAD          0.0174532925f
#define DT                  0.01f   // 10ms loop = 100Hz

/* ============== Data Logging ============== */
#define LOG_SIZE            500

volatile float log_roll[LOG_SIZE];
volatile float log_pitch[LOG_SIZE];
volatile float log_yaw[LOG_SIZE];
volatile uint16_t log_idx = 0;
volatile uint8_t log_done = 0;

/* ============== Attitude (output of sensor fusion) ============== */
volatile float roll  = 0;   // degrees, rotation around X
volatile float pitch = 0;   // degrees, rotation around Y
volatile float yaw   = 0;   // degrees, rotation around Z (drifts without mag)

/* ============== Debug Variables ============== */
volatile uint8_t device_id = 0;
volatile ICM42688P_Status_t imu_status = ICM42688P_ERR_ID;
volatile ICM42688P_Data_t imu_data = {0};

volatile uint32_t read_count = 0;
volatile uint32_t error_count = 0;

// Raw data (after bias removal)
volatile float raw_ax = 0, raw_ay = 0, raw_az = 0;
volatile float raw_gx = 0, raw_gy = 0, raw_gz = 0;

// Filtered data
volatile float filt_ax = 0, filt_ay = 0, filt_az = 0;
volatile float filt_gx = 0, filt_gy = 0, filt_gz = 0;

// Calibration
volatile float gyro_bias_x = 0, gyro_bias_y = 0, gyro_bias_z = 0;
volatile float accel_bias_x = 0, accel_bias_y = 0, accel_bias_z = 0;
volatile uint8_t calibrated = 0;

// Accel angles (for debugging)
volatile float accel_roll = 0, accel_pitch = 0;
/* USER CODE END PTD */

I2C_HandleTypeDef hi2c1;
I2C_HandleTypeDef hi2c2;

SPI_HandleTypeDef hspi1;
SPI_HandleTypeDef hspi2;

UART_HandleTypeDef huart1;
UART_HandleTypeDef huart2;

void SystemClock_Config(void);
static void MX_GPIO_Init(void);
static void MX_I2C1_Init(void);
static void MX_I2C2_Init(void);
static void MX_SPI1_Init(void);
static void MX_SPI2_Init(void);
static void MX_USART1_UART_Init(void);
static void MX_USART2_UART_Init(void);
/* USER CODE BEGIN 0 */
float lpf_update(float new_val, float prev_filtered, float alpha)
{
    return alpha * new_val + (1.0f - alpha) * prev_filtered;
}

void calibrate_imu(SPI_HandleTypeDef *hspi)
{
    float sum_gx = 0, sum_gy = 0, sum_gz = 0;
    float sum_ax = 0, sum_ay = 0, sum_az = 0;

    for (uint16_t i = 0; i < CAL_SAMPLES; i++)
    {
        ICM42688P_ReadAll(hspi, (ICM42688P_Data_t*)&imu_data);

        sum_gx += imu_data.gyro_dps.x;
        sum_gy += imu_data.gyro_dps.y;
        sum_gz += imu_data.gyro_dps.z;

        sum_ax += imu_data.accel_g.x;
        sum_ay += imu_data.accel_g.y;
        sum_az += imu_data.accel_g.z;

        HAL_Delay(10);
    }

    gyro_bias_x = sum_gx / CAL_SAMPLES;
    gyro_bias_y = sum_gy / CAL_SAMPLES;
    gyro_bias_z = sum_gz / CAL_SAMPLES;

    accel_bias_x = sum_ax / CAL_SAMPLES;
    accel_bias_y = sum_ay / CAL_SAMPLES;
    accel_bias_z = (sum_az / CAL_SAMPLES) - 1.0f;

    calibrated = 1;
}

// FIXED: Corrected atan2 arguments for proper pitch/roll convention per datasheet
void compute_accel_angles(float ax, float ay, float az)
{
    accel_roll  = atan2f(-ax, sqrtf(ay*ay + az*az)) * RAD_TO_DEG;
    accel_pitch = atan2f(ay, az) * RAD_TO_DEG;
}

void complementary_filter_update(float gx, float gy, float gz, float dt)
{
    // X gyro -> roll, Y gyro -> pitch
	roll  += gy * dt;  // was gx
	pitch += gx * dt;
    yaw   += gz * dt;

    // Correct with accel
    roll  = COMP_FILTER_ALPHA * roll  + (1.0f - COMP_FILTER_ALPHA) * accel_roll;
    pitch = COMP_FILTER_ALPHA * pitch + (1.0f - COMP_FILTER_ALPHA) * accel_pitch;
}
/**
  * @brief  The application entry point.
  * @retval int
  */
int main(void)
{
    HAL_Init();
    SystemClock_Config();

    MX_GPIO_Init();
    MX_I2C1_Init();
    MX_I2C2_Init();
    MX_SPI1_Init();
    MX_SPI2_Init();
    MX_USART1_UART_Init();
    MX_USART2_UART_Init();

    HAL_Delay(100);

    /*=========================================================================*/
    /*                     ICM-42688-P INITIALIZATION                          */
    /*=========================================================================*/

    imu_status = ICM42688P_ReadID(&hspi2, (uint8_t*)&device_id);

    if (device_id != ICM42688P_WHO_AM_I_VAL)
    {
        error_count++;
        Error_Handler();
    }

    imu_status = ICM42688P_Init(&hspi2);

    if (imu_status != ICM42688P_OK)
    {
        error_count++;
        Error_Handler();
    }

    /*=========================================================================*/
    /*                     CALIBRATION (keep board STILL!)                     */
    /*=========================================================================*/

    HAL_Delay(500);
    calibrate_imu(&hspi2);

    // Initialize roll/pitch from accel (starting orientation)
    ICM42688P_ReadAll(&hspi2, (ICM42688P_Data_t*)&imu_data);
    raw_ax = imu_data.accel_g.x - accel_bias_x;
    raw_ay = imu_data.accel_g.y - accel_bias_y;
    raw_az = imu_data.accel_g.z - accel_bias_z;
    compute_accel_angles(raw_ax, raw_ay, raw_az);
    roll = accel_roll;
    pitch = accel_pitch;
    yaw = 0;

    /*=========================================================================*/
    /*                          MAIN LOOP                                      */
    /*=========================================================================*/

    uint32_t last_time = HAL_GetTick();

    while (1)
    {
        // Compute actual dt
        uint32_t now = HAL_GetTick();
        float dt = (now - last_time) / 1000.0f;  // ms to seconds
        if (dt < 0.001f) dt = 0.01f;  // Minimum 1ms
        last_time = now;

        imu_status = ICM42688P_ReadAll(&hspi2, (ICM42688P_Data_t*)&imu_data);

        if (imu_status == ICM42688P_OK)
        {
            read_count++;

            // Bias correction
            raw_ax = imu_data.accel_g.x - accel_bias_x;
            raw_ay = imu_data.accel_g.y - accel_bias_y;
            raw_az = imu_data.accel_g.z - accel_bias_z;

            raw_gx = imu_data.gyro_dps.x - gyro_bias_x;
            raw_gy = imu_data.gyro_dps.y - gyro_bias_y;
            raw_gz = imu_data.gyro_dps.z - gyro_bias_z;

            // Low-pass filter
            filt_ax = lpf_update(raw_ax, filt_ax, LPF_ALPHA);
            filt_ay = lpf_update(raw_ay, filt_ay, LPF_ALPHA);
            filt_az = lpf_update(raw_az, filt_az, LPF_ALPHA);

            filt_gx = lpf_update(raw_gx, filt_gx, LPF_ALPHA);
            filt_gy = lpf_update(raw_gy, filt_gy, LPF_ALPHA);
            filt_gz = lpf_update(raw_gz, filt_gz, LPF_ALPHA);

            // Compute accel angles (for complementary filter)
            compute_accel_angles(filt_ax, filt_ay, filt_az);

            // Sensor fusion: complementary filter (pass dt now)
            complementary_filter_update(filt_gx, filt_gy, filt_gz, dt);

            // Log attitude data
            if (log_idx < LOG_SIZE)
            {
                log_roll[log_idx]  = roll;
                log_pitch[log_idx] = pitch;
                log_yaw[log_idx]   = yaw;
                log_idx++;

                if (log_idx >= LOG_SIZE)
                {
                    log_done = 1;
                }
            }
        }
        else
        {
            error_count++;
        }

        HAL_Delay(10);  // ~100Hz
    }
}


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
