salehali22/Flight-Controller/(commit log)

2025-11-12 updated the software on esp32. Sample rate set to 100hz.
2025-11-12 Replaced uC_code with IMU_uC PlatformIO project
    [main.cpp]
2025-11-12 Add IMU_uC project and update IMU_testing.py
2025-11-13 this commit adds the Hardware files
    [AT7456E.step, BMP388.step, Flight Controller.kicad_sch, ICM-42688-P.step, STM32F722RET6.step, USB4110GFA.step]
2025-11-13 clean repo
    [AT7456E.step, BMP388.step, Flight Controller.kicad_sch, ICM-42688-P.step, STM32F722RET6.step, USB4110GFA.step]
2025-11-13 this commit adds Hardware Folder
    [AT7456E.step, BMP388.step, Flight Controller.kicad_sch, ICM-42688-P.step, STM32F722RET6.step, USB4110GFA.step]
2025-11-13 GUI update and complementary filter fix
    [drift_test_2025-11-14_01-17.csv, drift_test_2025-11-14_01-25.csv, drift_test_2025-11-14_01-27.csv, drift_test_2025-11-14_03-00.csv, drift_test_2025-11-14_03-19.csv]
2025-11-13 Organize IMU code into tools directory
2025-11-14 this commit updates MCU shematics, Flash memory and Magnetometer
    [Flight Controller.kicad_sch, QMC5883P.step, W25Q128JVSIQ.step]
2025-11-14 This commit completes MCU and Crystals caps calculations
    [Flight Controller.kicad_sch, SW-SMD_SSSS810701.step]
2025-11-14 added modes and fixed some bugs in IMU testings
    [IMU_testing.py, main.cpp]
2025-11-15 This commit adds connectors in the schematics
    [Flight Controller.kicad_sch]
2025-11-15 export reworked, improved frequency
    [static test.csv]
2025-11-16 This commit changes the MCU and adds backup IMU
    [Flight Controller.kicad_sch]
2025-11-20 Changed 5V Regulator, pin mapping for ESC and motors
    [3p_connector.step, 6p_connector.step, 7p_connector.step, BMI270.step, Flight Controller.kicad_pcb, Flight Controller.kicad_sch]
2025-11-23 This commit completes the Schematics
    [Flight Controller.kicad_sch, R2512_L6.3-W3.2-H0.6.step]
2025-11-23 This commit changes Battery Filtering and Fixes Magnetometer wiring
    [AO3407A.step, Flight Controller.kicad_pcb, Flight Controller.kicad_sch, IND-SMD_L4.2-W4.4-H2.0.step, IND-SMD_L5.4-W5.2-H3.0.step]
2025-11-25 This commits adds latest Schematics
    [Flight Controller.kicad_pcb, Flight Controller.kicad_sch]
2025-11-25 This commit Adds test board
    [AT7456E.step, BMI270.step, BMP388.step, ICM-42688-P.step, QMC5883P.step, STM32F722RET6.step, SW-SMD_SSSS810701.step, USB4110GFA.step]
2025-11-25 Added connectors STEP files, edited Schematics and started layout
    [3p_connector.step, 4pconnector1mm.step, 6p_connector.step, 6pconn.step, 7p_connector.step, 8pconn.step, Flight Controller.kicad_pcb, Flight Controller.kicad_sch]
2025-11-26 This commits updates BOM for Test Board, Changes the Ferrit bead value
    [Flight Controller.kicad_pcb, Flight Controller.kicad_sch, board.csv, board.kicad_sch, board.xls, board.xlsx]
2025-11-28 Fixed Peripherals for OSD
    [Flight Controller.kicad_pcb, Flight Controller.kicad_sch]
2025-11-29 modified shcematics BOOT botton, added connector for VTX, did rough Layout
    [Flight Controller.kicad_pcb, Flight Controller.kicad_sch, board.csv, board.xls, board.xlsx]
2025-11-29 changed into 2 LDO's one for the IMU's and one for the rest
    [AP2112K-3.3TRG1.step, Flight Controller.kicad_pcb, Flight Controller.kicad_sch]
2025-11-30 Reformed the Schematics Files, reconfigured MCU pins
    [Flight Controller.kicad_sch, MCU.kicad_sch, Sensors.kicad_sch, connectors.kicad_sch, power.kicad_sch]
2025-12-01 Added Necessary Connectors, pads and comments in the respective file
    [Flight Controller.kicad_pcb, Flight Controller.kicad_sch, MCU.kicad_sch, Sensors.kicad_sch, connectors.kicad_sch, power.kicad_sch]
2025-12-01 Added Digital Airspeed Sensor Connector, Changed the Magnetometer
    [AP7343 .step, Flight Controller.kicad_pcb, Flight Controller.kicad_sch, MCU.kicad_sch, Sensors.kicad_sch, connectors.kicad_sch, mag.step, power.kicad_sch]
2025-12-03 added support for Pololu 0J8003 board
2025-12-03 clearing unnecessary net classes in power schematics
    [Flight Controller.kicad_pcb, power.kicad_sch]
2025-12-03 slightly fixed pololu board code
    [IMU_testing.py, imu_target_config.h, pololu_l3gd20h.cpp]
2025-12-05 removed enable pin resistor in 9V/12V regulator and Layout progress
    [Sensors.kicad_sch, power.kicad_sch]
2025-12-05 updated wiring of ESD from USB C
    [Flight Controller.kicad_pcb, power.kicad_sch]
2025-12-09 added magnetometer testing
2025-12-16 Changed to CMOS, layout progress
    [(HSE)OSC-SMD_4P-L3.2-W2.5-CJ13-320001210A20.step, Flight Controller.kicad_pcb, MCU.kicad_sch, Sensors.kicad_sch, connectors.kicad_sch, power.kicad_sch]
2025-12-18 added CAN connector
    [Flight Controller.kicad_pcb, Flight Controller.kicad_sch, connectors.kicad_sch, power.kicad_sch]
2025-12-27 added firmware drivers for all sensors for the test board
    [Flight Controller.kicad_pcb, Sensors.kicad_sch, connectors.kicad_sch]
2026-01-14 progress layout
    [Flight Controller.kicad_pcb, Sensors.kicad_sch, board.kicad_pcb, power.kicad_sch]
2026-01-30 changed hella stuff in firmware plan and hardware pcb layout
    [Flight Controller.csv, Flight Controller.kicad_pcb, Flight Controller.xlsx, MCU.kicad_sch, Sensors.kicad_sch, connectors.kicad_sch, power.kicad_sch]
2026-01-31 layout progress
    [Flight Controller.kicad_pcb, connectors.kicad_sch]
2026-02-06 hella shit configured, layout progress
    [Flight Controller.kicad_pcb, Flight Controller.kicad_sch, MCU.kicad_sch, Sensors.kicad_sch, connectors.kicad_sch, power.kicad_sch]
2026-02-07 added zener diode, more layout, Power verificatoin
    [(zener)SOD-123FL_L2.8-W1.8-LS3.7-RD-1.step, Flight Controller.kicad_pcb, MCU.kicad_sch, connectors.kicad_sch, power.kicad_sch]
2026-02-08 more routing and placement
    [Flight Controller.kicad_pcb, connectors.kicad_sch]
2026-02-09 First iteration layout done
    [Flight Controller.kicad_pcb, SM06B-GHS-TB.step, connectors.kicad_sch]
2026-02-10 silkscreen and some routing
    [Flight Controller.kicad_pcb]
2026-02-11 refined the layout
    [Flight Controller.kicad_pcb]
2026-02-19 fixed 5V rail
    [Flight Controller.kicad_pcb, power.kicad_sch]
2026-02-21 fixed connectors
    [Flight Controller.kicad_pcb, connectors.kicad_sch, power.kicad_sch]
2026-02-22 fixed the reset schematics
    [Flight Controller.kicad_pcb, MCU.kicad_sch, power.kicad_sch]
2026-02-22 DRC implementation
    [Flight Controller.kicad_pcb]
2026-02-24 add drone ground station Electron app
    Complete desktop ground station for STM32H743VIT6 flight controller:
    - Dashboard with Three.js 3D quadcopter model (real-time attitude)
    - 8 telemetry cards: roll/pitch/yaw/altitude/battery/GPS/mode/arm
    - 16-channel RC bar display updating at 50Hz
    - Mission planner with Leaflet.js map, click-to-place waypoints,
    save/load JSON missions, upload to FC placeholder
    - PID tuning tab with Roll/Pitch/Yaw P, I, D sliders
    - Configuration tab: serial port selector, FC info, arm/disarm
    - Simulator module (simulator.js) with clean DataSource interface
    designed so swapping to real serial requires changing one file only
    - Dark INAV-style theme (#1a1a2e background, #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
    [main.js]
