salehali22/Flight-Controller/(notices)

Notices in the files:
firmware/Flight_Controller/Core/Inc/main.h:
Copyright (c) 2025 STMicroelectronics.
All rights reserved.
This software is licensed under terms that can be found in the LICENSE file
